S1NZH/Course-project-9.101/МКЭ/В отчет/Снимок экрана 2026-06-16 001204.png

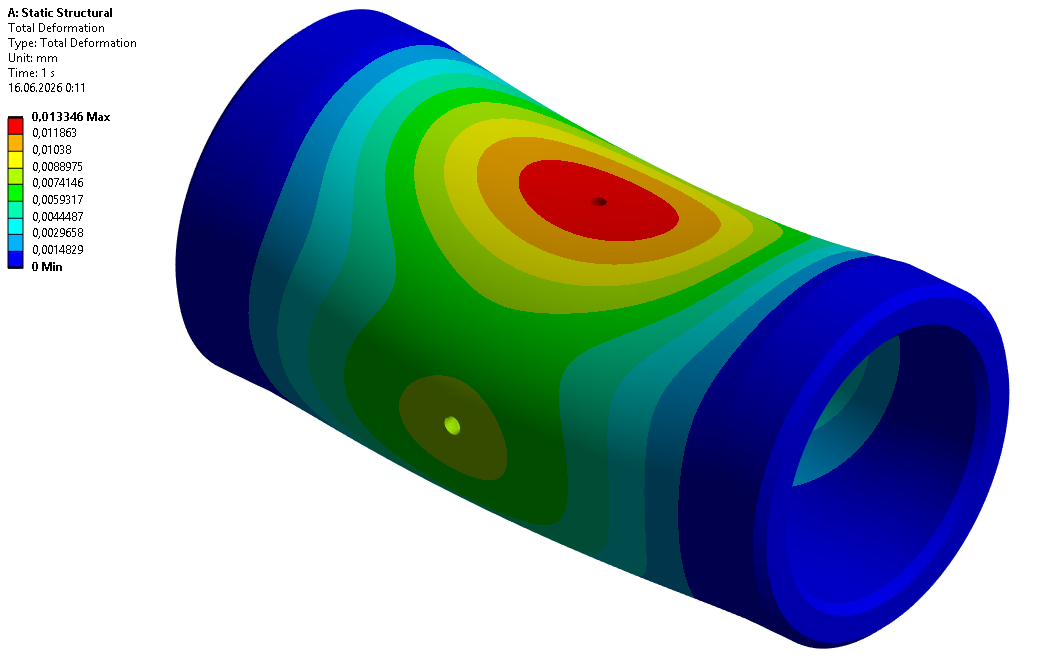
МКЭ/В отчет/Снимок экрана 2026-06-16 001204.png
