S1NZH/Course-project-9.101/Образцы/Ваня.jpg

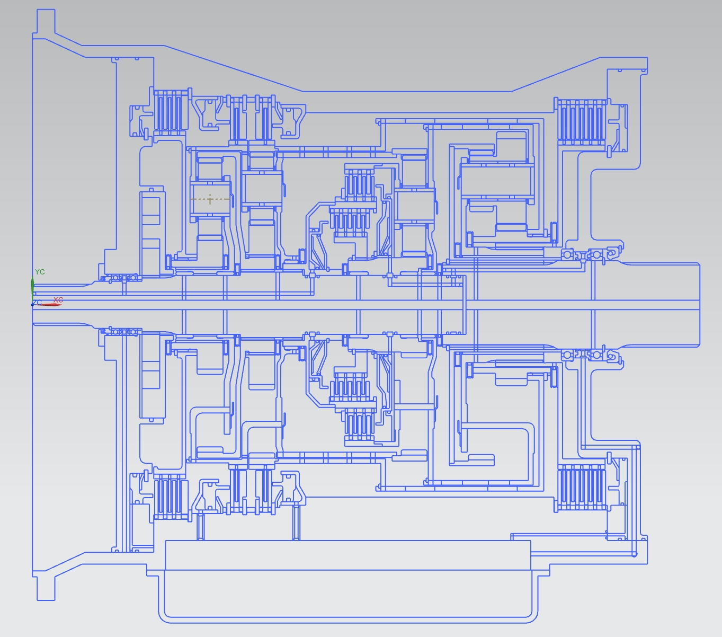
Образцы/Ваня.jpg
