S1NZH/Course-project-9.101/РПЗ ПКП Жиленко Н.Д, СМ9-101.docx

| Министерство науки и высшего образования Российской Федерации Федеральное государственное автономное образовательное учреждение высшего образования «Московский государственный технический университет имени Н.Э. Баумана (национальный исследовательский университет)» (МГТУ им. Н.Э. Баумана)

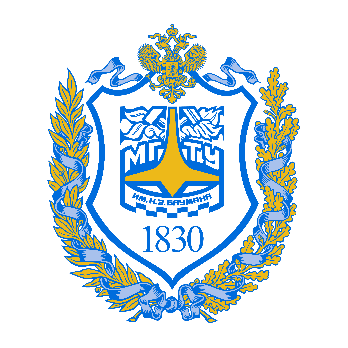
[picture p3: figure]

ФАКУЛЬТЕТ «Специальное машиностроение»

КАФЕДРА СМ9 «Многоцелевые гусеничные машины и мобильные роботы»

РАСЧЕТНО-ПОЯСНИТЕЛЬНАЯ ЗАПИСКА

К КУРСОВОМУ ПРОЕКТУ

НА ТЕМУ:

Проектирование планетарной

коробки передач

Студент: | | СМ9- 101 | | | | | | | | Н.Д. Жиленко
| | (Группа) | | | | (Подпись, дата) | | | | (И.О. Фамилия)
Руководитель курсового проекта: | | | | | | | | | | С.А. Харитонов
| | | | | | (Подпись, дата) | | | | (И.О. Фамилия)
Консультант: | | | | | | | | | | Т.Д. Поздняков
| | | | | | (Подпись, дата) | | | | (И.О. Фамилия)
Норм. контролер | | | | | | | | | | К.Е.Бяков
| | | | | | (Подпись, дата) | | | | (И.О. Фамилия)
Ответственный за курсовое проектирование | | | | | | | | | В.Б. Холоденко
| (Баллы за семестр) | | | | (Подпись, дата) | | | | (И.О. Фамилия)

Министерство науки и высшего образования Российской Федерации

Федеральное государственное бюджетное образовательное учреждение

высшего образования

«Московский государственный технический университет имени Н.Э. Баумана

(национальный исследовательский университет)»

(МГТУ им. Н.Э. Баумана)

Утверждаю
Заведующий кафедрой | | | СМ9
| | | (индекс)
| | В. А. Горелов
(подпись) | | (И.О. Фамилия)
| | (дата)

ЗАДАНИЕ

на выполнение курсового проекта

по дисциплине | | Методы расчета и проектирования
Студент группы | | СМ9-101 Жиленко Никита Дмитриевич
| | (Фамилия, имя, отчество)
Тема курсового проекта | | | Проектирование планетарной коробки передач

Направленность КП (учебная, исследовательская, практическая, производственная, др.)
Источник тематики (кафедра, предприятие, НИР)
Задание | Спроектировать по заданной кинематической схеме планетарную коробку передач

Раб. точки | 54 | 24 | 48 | 34 | 47 | 37 | 78 | 27 | 58 | 35
i0x | 7,75 | 3,10 | 1,84 | 1,46 | 1,22 | 1,10 | 1,00 | 0,87 | -5,55 | -3,40

Оформление курсовой работы:

Расчетно-пояснительная записка на _____ листах формата А4.

Перечень графического (иллюстративного) материала (чертежи, плакаты, слайды и т.п.)

Общий вид, продольный разрез коробки передач, поперечные разрезы по планетарным

рядам и насосу, рабочие чертежи, 3D-модель одного планетарного ряда

Дата выдачи задания «__» ______________ 2026 г.

Руководитель курсового проекта | | | | С.А. Харитонов
| | (подпись, дата) | | (И.О. Фамилия)
Студент | | | | Н.Д. Жиленко
| | (подпись, дата) | | (И.О. Фамилия)
Ответственный за курсовое проектирование | | | | В.Б. Холоденко
| | (подпись, дата) | | (И.О. Фамилия)

# Исходные данные

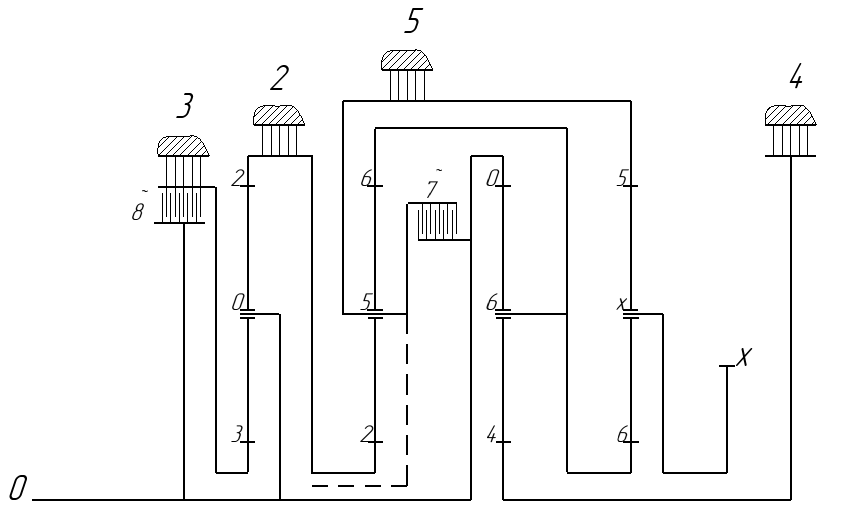
[picture p4: figure]

Исходные данные для расчетов элементов планетарной коробки передач на прочность

Mдвmax, Н∙м | nдв, об/мин | | Пробег, км | Коэффициент использования ДВС | Средняя скорость в течение всего срока эксплуатации, км/ч
| max | min
750 | 3000 | 900 | 250 000 | 0,45 | 25,0

Министерство науки и высшего образования Российской Федерации

Федеральное государственное бюджетное образовательное учреждение

высшего образования

«Московский государственный технический университет имени Н.Э. Баумана

(национальный исследовательский университет)»

(МГТУ им. Н.Э. Баумана)

КАЛЕНДАРНЫЙ ПЛАН

на выполнение курсового проекта

по дисциплине | Методы расчета и проектирования
Студент группы | СМ9-101 Жиленко Никита Дмитриевич
| (Фамилия, имя, отчество)
Тема курсового проекта | | Проектирование планетарной коробки передач

№ п/п | Наименование этапов выпускной квалификационной работы | Сроки выполнения этапов | | Отметка о выполнении
| | план | факт | Руководитель КП | Куратор
| Задание на выполнение курсового проекта
| 1 модуль | ____________ Планируемая дата
| 2 модуль | ____________ Планируемая дата
| Оформление РПЗ | ____________ Планируемая дата
| Подготовка доклада и презентации (при необходимости) | ____________ Планируемая дата
| Защита курсового проекта | ____________ Планируемая дата

Студент | | | Руководитель проекта
| (подпись, дата) | | | (подпись, дата)

СОДЕРЖАНИЕ

# СПИСОК СОКРАЩЕНИЙ И ОБОЗНАЧЕНИЙ

БЦК – большое центральное колесо

КПД – коэффициент полезного действия

КЭ – конечный элемент

КЭМ – конечно-элементная модель

МКЭ – метод конечных элементов

МЦК – малое центральное колесо

ПК – программный комплекс

ПКП – планетарная коробка передач

САТ – сателлит

a – межосевое расстояние

a_(дв) – коэффициент использования двигателя

a_1 – коэффициент, корректирующий ресурс в зависимости от надежности

a_23 – коэффициент, учитывающий условия применения подшипника

b – ширина зубчатого зацепления

b_ф – ширина контакта фрикционных дисков

C_(r i) – радиальная динамическая грузоподъемность подшипника i-го планетарного ряда

D_(о i) – внешний диаметр оси сателлита i-го ряда

D_(min) – минимальный внешний диаметр сечения вала

D_(we) – диаметр ролика

d – делительный диаметр

d_о – диаметр отверстия в валу

d_(о i) – внутренний диаметр оси сателлита i-го ряда

d_(отв i) – диаметр отверстия в сателлите

d_a – диаметр вершин зубьев

d_f – диаметр впадин зубьев

F – суммарная площадь боковых поверхностей зубьев с одной стороны

F_(оси i,j) – суммарная нагрузка на опору i-го сателлита на j-ой передаче

F_(оси ср. i) – средняя нагрузка на ось i-го планетарного ряда

F_(ЦБ i,j) – центробежная сила, действующая на ось i-го планетарного ряда на j-ой передаче

F_(t i,j) – окружная сила, действующая на ось i-го планетарного ряда на j-ой передаче

f_c – коэффициент, зависящий от отношения диаметра ролика к длине ролика

h_щ – минимальная толщина щеки

i_р – число рядов тел качения

K_б – коэффициент безопасности, учитывающий условия работы подшипника

K_(вод i,j) – коэффициент нагрузки водила i-го ряда на j-ой передаче

K_т – коэффициент, учитывающий рабочую температуру подшипника

K_(нер i) – коэффициент неравномерности распределения нагрузки для зацеплений iго ряда

k – коэффициент нагрузки на рассматриваемом участке

k_(ω вод i,j) – коэффициент угловой скорости водила i-го ряда на j-ой передаче

k_(ω сат i,j) – коэффициент угловой скорости сателлита i-го ряда на j-ой передаче

L_(sa i) – ресурс радиального игольчатого подшипника i-го планетарного ряда

L_(we) – длина ролика

l_(min) – минимальная длина шлицевого соединения

M_(дв max) – максимальный момент двигателя

M_н – момент, передаваемый фрикционным элементом

M_ф – расчетный момент фрикционного элемента

m – модуль зубчатых колес

m_ш – модуль шлицевого зацепления

m_i – приблизительная масса сателлита i-го ряда

N_(подш i,j) – требуемое количество оборотов подшипника i-го планетарного ряда на j-ой передаче до отказа

n_(ср) – средние обороты двигателя в процессе эксплуатации

n_(min) – минимальная частота вращения двигателя

n_(max) – максимальная частота вращения двигателя

P – сила, действующая на пакет фрикционов

P_(r i) – эквивалентная радиальная динамическая нагрузка подшипника i-го планетарного ряда

p_(упр) – давление в системе управления

q – удельное давление на поверхностях трения

R_(вод i) – радиус водила i-го ряда

R_(ПКП) – ресурс планетарной коробки передач

R_в – внутренний радиус контакта фрикционных дисков

R_н – наружный радиус контакта фрикционных дисков

R_(пв) – внутренний радиус поршня

R_(пн) – наружный радиус поршня

r_(ср) – средний радиус шлицевого соединения

V – коэффициент, учитывающий вращение внутреннего или внешнего кольца подшипника

v_(ср) – средняя скорость машины

Z – число роликов в подшипнике

z – пар трения фрикционного элемента

z_(МЦК) – число зубьев малого центрального колеса

z_(Сат) – число зубьев сателлита

z_(БЦК) – число зубьев большого центрального колеса

z_ш – количество шлицев

β – угол наклона зубчатых колес

β_з – коэффициент запаса фрикциона, при трении в масле

λ – коэффициент, учитывающий уменьшение площади поверхности трения дисков с накладками из-за наличия канавок

μ – коэффициент трения фрикционной пары

ρ_(ст) – плотность материала сателлита

[σ]_(см) – допустимые напряжения смятия

τ_(ср i) – напряжения среза осей i-го планетарного ряда

[τ]_(кр) – допускаемые касательные напряжения при кручении

φ – коэффициент неравномерности распределения нагрузки по рабочим поверхностям зубьев

# ВВЕДЕНИЕ

Курсовой проект посвящен проектированию планетарной коробки передач (ПКП). Планетарными называют передачи, в которых одно или несколько зубчатых колес кроме относительного вращения вокруг своих осей имеют еще и переносное вращение вместе с осями.

По сравнению с обычными передачами, в которых оси всех зубчатых колес неподвижны, планетарные передачи, благодаря применению нескольких промежуточных звеньев – сателлитов, обеспечивают большую напряженность зубьев, разгружают центральные валы и подшипниковые опоры от радиальных усилий, при правильном выборе кинематической схемы обладают более высоким коэффициентом полезного действия (далее КПД) при меньших размерах и больших передаточных отношениях.

Применение ПКП озволяет сократить время, затрачиваемое на переключение передач, существенно упрощает задачу автоматизации процесса управления, избавляет от необходимости устанавливать между двигателем и трансмиссией сцепление или главный фрикцион, так как его функции выполняют тормоза и блокировочные муфты, предназначенные для включения передач в коробке.

ПКП должна также обладать высокой надёжностью (в пределах заданного ресурса работы) и малыми габаритами.

# 1 Техническое задание

Разработать планетарную коробку передач с тремя степенями свободы, имеющую десять передач, из которых две – заднего хода, по исходным данным, представленным в таблицах 1 и 2.

Таблица 1 – Исходные данные

Наименование параметра | Значение
Максимальный крутящий момент двигателя М_(ДВСmax) , Н⋅м | 750
Максимальная частота вращения вала двигателя n_(ДВСmax) , об/мин | 3000
Минимальная частота вращения вала двигателя n_(ДВС min) , об/мин | 900
Ресурс коробки передач R_(КП) , км | 250000
Коэффициент использования двигателя a | 0,45
Средняя скорость машины в течение срока эксплуатации v_(ср) , км/ч | 25

Таблица 2 – Таблица включения передач

Номер передачи | КПД | i_(0x) | Элементы управления
| | | Т2 | Т3 | Т4 | Т5 | М7 | М8
ЗХ II | 0,940 | -3,459 | | X | | X
ЗХ I | 0,951 | -5,568 | | | | X | | X
1 | 0,962 | 7,830 | | | X | X
2 | 0,973 | 3,841 | X | | X
3 | 0,981 | 1,954 | | | X
4 | 0,972 | 1,542 | | X | X
5 | 0,991 | 1,277 | | | X | | X
6 | 0,991 | 1,123 | | X | | | X
7 | 1,000 | 1,000 | | | | | X | X
8 | 0,992 | 0,848 | X | | | | X

Кинематическая схема коробки передач представлена на рисунке 1

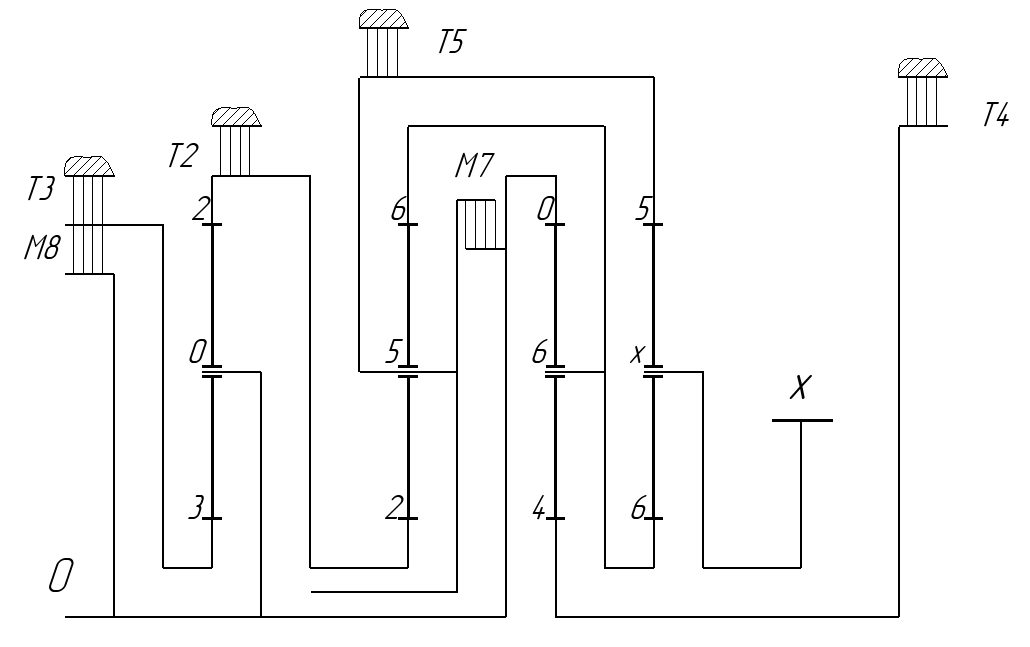
[picture p5: figure]

0 – входное звено; X – выходное звено коробки передач; 2, 3, 4, 5, 6 – звенья коробки передач; 7, 8 – блокировочные муфты

Рисунок 1 – Кинематическая схема ПКП

В ПКП имеются шесть элементов управления – четыре тормоза: Т2, Т3, Т4 и Т5 и две блокировочные муфты: муфта М7 соединяет звенья 0 и 5, муфта М8 – звенья 0 и 3. В ПКП входят 4 планетарных ряда (ПР) второго класса: первый ряд 302 с внутренним передаточным отношением -1,64, второй – 256 с внутренним передаточным отношением -1,93, третий – 460 с внутренним передаточным отношением -1,694, четвёртый – 6x5 с внутренним передаточным отношением -1,909.

# 2 Расчет элементов коробки передач

## Расчет минимального диаметра валов

Следует отметить, что одним из основных преимуществ планетарных коробок передач является разгруженность их центральных валов от радиальных сил, что определяется симметричным расположением сателлитов. Поэтому все центральные валы и их подшипниковые опоры разгружены от действия радиальных сил. Это значительно упрощает расчеты всех центральных валов, которые следует проводить только на действие крутящего момента.

Еще одна особенность работы планетарных коробок передач заключается в том, что на разных передачах на один и тот же участок вала могут действовать различные, как по направлению, так и по величине, крутящие моменты. Причем на каждом участке момент может изменяться от максимального по абсолютной величине до нулевого значения. Это приводит к необходимости использовать при выборе допускаемых напряжений на кручения значения, соответствующие переменной нагрузке, действующей от нуля до максимума и от максимума до нуля (пульсирующая нагрузка).

Для определения минимально допустимого числа зубьев МЦК планетарных рядов необходимо знать модуль зубчатых колес. При проектировании планетарных коробок передач в виду особенности назначения чисел зубьев зубчатых колес их модуль не рассчитывается, а назначается. Назначение величины модуля происходит, как правило, в зависимости от максимальной величины крутящего момента на ведущем валу и на основании опыта проектирования предыдущих планетарных коробок передач. Рекомендуемые значения модуля в зависимости от максимального момента на ведущем валу представлены в таблице 3.

Таблица 3 – Рекомендуемые значения модуля зубчатых колес планетарных рядов
Момент на ведущем валу, Н∙м | 100-300 | 300-700 | 700-2000 | 2000-4000
Модуль, мм | 1,25-1,5 | 1,5-1,75 | 2,0-2,5 | 3,0-4,0

Таким образом, для дальнейших расчетов примем величину модуля зубчатых колес всех планетарных рядов равным 2 мм.

Еще одним назначаемым параметром является угол наклона зубьев β . Наличие угла наклона зубьев увеличивает несущую способность цилиндрических передач. Кроме того, косозубые передачи отличаются от прямозубых меньшей виброактивностью и пониженным уровнем шума, которые тем меньше, чем больше угол наклона зубьев.

Но слишком большие значения β приводят к увеличению осевой составляющей силы в зацеплении. Поэтому для значений максимального момента, развиваемого двигателем, до 1500 Н∙м рекомендуется принимать угол наклона зубьев в пределах от 8º до 25º. Для моментов превышающих эту величину β должен быть принят равным нулю. В нашем случае назначим угол 15º.

Для проведения расчета минимальных диаметров валов необходимо, прежде всего, определить моменты, нагружающие тот или иной участок каждого вала. Для этого необходимо знать, какие пары элементов управления, включаются на каждой передаче, и значения относительный моментов, нагружающих звенья и элементы управления проектируемой коробки передач.

Какие пары элементов управления задействованы на каждой передаче задано в техническом задании или это также можно определить по плану угловых скоростей.

Схема участков валов для расчета их диаметров представлена на рисунке 2.

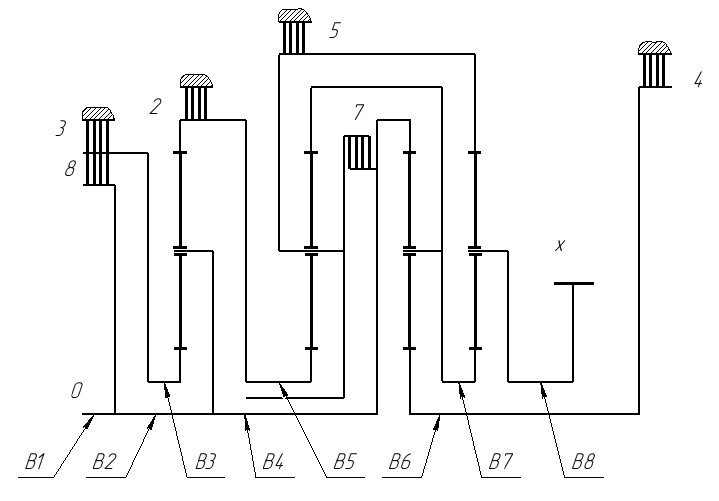
[picture p6: figure]

Рисунок 2 – Схема участков валов

Не сложный анализ структуры кинематической схемы показывает, что необходимо произвести расчет восьми участков валов (рисунок 8):

- В1 – ведущий вал ПКП (нагружен только моментом двигателя);
- В2 – момент с двигателя + на муфте 8;
- В3 – момент на МЦК первого ряда;
- В4 – момент с двигателя + на муфте 8 + водило первого ряда;
- В5 – момент на МЦК второго ряда;
- В6 – момент на МЦК третьего ряда;
- В7 – момент на МЦК четвертого ряда;
- В8 – момент 1-ой передаче или передаче заднего хода;

Для расчет минимальных диаметров валов можно воспользоваться программой WALY, расположенной в одноименной папке.

Работа с программой WALY весьма проста. Программа рассчитывает минимальное значение внешнего диаметра вала. Для этого следует задать следующие величины:

- допускаемые напряжения на кручение;
- максимальный момент, развиваемый двигателем;
- относительный момент, действующий на данный участок вала
- внутренний диаметр вала.

Величина относительного момента, действующего на том или ином участке вала, определяется по результату расчета кинематических и силовых характеристик кинематической схемы, проведенного по программе PKP4, (Приложение А).

Величину внутреннего диаметра вала возможно определить только, приступив к выполнению эскизной компоновки планетарной коробки передач.

При выборе марки стали для валов следует руководствоваться следующим: сталь должна быть относительно не дорогой, но при этом иметь достаточно приемлемое значение допускаемых напряжений на кручение.

Руководствуясь приведенными выше соображениями, выберем для изготовления валов нашей коробки передач сталь 35ХМ ГОСТ 4543-71. Данная марка стали при закалке и отпуске в масле имеет вполне приемлемые допускаемые напряжения на кручение 310 МПа. Также в процессе проектирования рассчитывались эвольвентные шлицы, служащие для сборки узлов ПКП. Расчёт производился в программе «Расчёт эвольвентных шлицов».

Начнем расчет минимальных внешних диаметров участков валов с ведущего вала. Результаты всех расчетов будем сводить в таблицу 4.

1) Участок В1.

Относительный момент, действующий на участке В1, равен 1.

Смазка планетарной коробки передач осуществляется принудительно посредством подачи масла через осевые и радиальные отверстия центрального вала к подшипниковым узлам, фрикционным дисковым элементам управления и зубчатым зацеплениям. В ведущем валу предусмотрено осевое отверстие диаметром 8 мм.

Расчеты по программе WALY с учетом принятых исходных данных показали, что внешний диаметр участка вала должен быть не менее 23 мм.

Поскольку участок В1 является частью ведущего вала, на его конце необходимо предусмотреть шлицы для соединения с двигателем или другими агрегатами трансмиссии.

На основании расчетов внешний диаметр участка В1 определяет диаметр впадин шлицев. Учитывая, что высота шлицев приблизительно равна модулю, внешний диаметр шлицованного конца участка В1 определяется как рассчитанный диаметр плюс два модуля эвольвентных шлицев.

При известных параметрах шлицев минимальный внешний диаметр шлицев составляет 21,15 мм. Заносим этот результат в таблицу 4. Таким образом, внешний диаметр шлицевого участка ведущего вала принимается равным 30 мм.

Таблица 4 – Результаты расчета минимальных диаметров валов

Участок | [τ] , МПа | M_(дв. max) , Н⋅м | Элемент ПКП,определяющий нагрузку | Коэф-т нагрузки участка | Внутренний диаметр, мм | Минимальный диаметр, мм | Принятый внешний диаметр, мм
В1 | 310 | 350 | ДВС | 1,00 | 8 | 23 | 30
В2 | | | ДВС + муфта 8 | 1,38 | 8 | 26 | 45
В3 | | | МЦК 1-го ПР | 0,38 | 54 | 55 | 76
В4 | | | ДВС + муфта 8 + водила 1-го ПР | 1,32 | 8 | 26 | 45
В5 | | | МЦК 2-го ПР | 1,00 | 61 | 62 | 69
В6 | | | МЦК 3-го ПР | 0,56 | 51 | 52 | 70

Продолжение таблицы 4

В7 | | | МЦК 4-го ПР | 2,70 | 74 | 76 | 82
В8 | | | I-ая передача | 7,83 | 74 | 78 | 85

Для установки уплотнений и подшипников предусматривается шейка диаметром 30 мм.

Далее устанавливаются шлицы для привода насоса диаметром 35 мм. Эти же шлицы используются для передачи крутящего момента на другие участки коробки передач.

1) Участок В2.

Относительный момент, действующий на участке В2, равен 1,38. На участке В2 находятся шлицы диаметром 35 мм и звено тормозной муфты 8.

2) Участок В3.

Относительный момент, действующий на участке В3, равен 0,37.

Внутренний диаметр участка составляет 36 мм. Внешний диаметр, равный 76 мм, принимаем для расположения шлицев.

На участке В3 располагается МЦК I-го ПР

Определим для него минимальные делительный диаметр и количество зубьев по формулам (1) и (2) соответственно:

d_(minПР1) =d_(fПР1) +2,5⋅m=76+2,5⋅2=81 мм | (1)
где d_f – диаметр впадин зубьев, мм; m – модуль зацепления, мм; z_(minПР1) =(d_(minПР1) ⋅cos(β))/m=(81⋅cos(15))/2≈40. | (2)

3) Участок В4.

Относительный момент, действующий на участке В4, равен 1,32.

Внутренний диаметр участка – 8 мм, для подвода масла. Согласно расчетам в программе WALY минимальное значение внешнего диаметра вала составило 26 мм. Принятый внешний диаметр на данном участке – 45 мм.

4) Участок В5.

Относительный момент, действующий на участке В5, равен моменту в тормозе звена 5, и равен 1.

Внутренний диаметр вала на этой участке – 61 мм. После расчетов в программе WALY значение минимального диаметра данного участка должно быть не менее 62 мм. Внешний диаметр принимается 69 мм. На участке В5 расположено МЦК II-го ПР. Определим для него минимальные делительный диаметр и количество зубьев по формулам (1) и (2) соответственно:

d_(minПР2) =d_(fПР1) +2,5⋅m=69+2,5⋅2=74 мм
z_(minПР2) =(d_(minПР2) ⋅cos(β))/m=(74⋅cos(15))/2≈36.

5) Участок В6.

Относительный момент, действующий на участке В6, равен 0,56.

Внутренний диаметр равен диаметру вершин внутренних эвольвентных шлицев (51мм). Тогда после расчета программы получаем внешний диаметр вала 52 мм. Из конструктивных соображений примем диаметр равным 70 мм.

На участке В6 расположено МЦК III-го ПР.

d_(minПР3) =d_(fПР1) +2,5⋅m=70+2,5⋅2=75 мм;

z_(minПР3) =(d_(minПР3) ⋅cos(β))/m=(75⋅cos(15))/2≈20.

6) Участок В7.

Относительный момент, действующий на участке В7, равен 2,7. На участке В7 расположено МЦК IV-го ПР. Внутренний диаметр вала – 74 мм. После расчета в программе получили значение внешнего диаметра вала равное 76 мм. Из конструктивных соображений примем значение равным 82 мм.

Таким образом,

d_(minПР4) =d_(fПР4) +2,5⋅m=82+2,5⋅2=87 мм ;

z_(minПР4) =(d_(minПР4) ⋅cos(β))/m=(82⋅cos(15))/2≈40.

7) Участок В8.

Относительный момент, действующий на участке В8, равен 7,83.

Внутренний диаметр участка вала 74 мм. Тогда после расчета программы получаем внешний диаметр вала 78 мм. Из конструктивных соображений примем диаметр равным 85 мм.

## Подбор чисел зубьев зубчатых колес планетарных рядов

В результате проведенных выше конструктивных проработок и расчетов были определены минимально допустимые числа зубьев МЦК для всех четырех планетарных рядов. Это обстоятельство дает возможность приступить к следующему этапу разработки эскизного проекта планетарной коробки передач – подбору чисел зубьев всех зубчатых колес, входящих в состав планетарных рядов.

Как известно, при подборе чисел зубьев шестерен планетарных рядов руководствуются шестью принципами:

1) Не желательны варианты, в которых числа зубьев сцепляющихся колес имели хотя бы один общий множитель;
2) Не желательны варианты, в которых числа зубьев сцепляющихся колес имели хотя бы один общий множитель;
3) Соблюдение условия соосности;
4) Соблюдение условия сборки;
5) Обеспечение условия соседства сателлитов;
8) Обеспечение условия не подрезания зубьев зубчатых колес.

В общем случае это достаточно трудоемкая процедура, поэтому удобнее воспользоваться разработанной для этой цели программой ZUB, расположенной в одноименной папке. Следует отметить, что данная программа осуществляет подбор чисел зубьев зубчатых колес только для планетарных рядов второго класса с одновенцовыми сателлитами.

В результате расчета программа предложит достаточно большое количество вариантов сочетания чисел зубьев шестерен планетарного ряда в зависимости от количества сателлитов, входящих в состав данного планетарного ряда. При этом следует выбирать такие варианты, в которых число зубьев МЦК было не меньше минимально допустимого значения, определенного выше. Кроме того, с точки зрения стоимости производства коробки передач, число сателлитов желательно принимать минимальным, но не менее трех.

Следует отметить, что это еще не окончательный выбор чисел зубьев шестерен планетарных рядов. Может оказаться так, что в результате прочностных расчетов или по конструктивным соображениям возникнет необходимость изменить количество зубьев шестерен в сторону их увеличения.

Так с помощью программы ZUB были получены варианты сочетания чисел зубьев зубчатых колес для каждого планетарного ряда. Результат расчета представлен в приложении Б.

При выборе сочетания числа зубьев зубчатых колес планетарных рядов следует учитывать еще один момент. Желательно, чтобы радиальные размеры всех планетарных рядов имели бы одинаковый размер. Это означает, что при одном и том же значении модуля зубчатых колес желательно, чтобы числа зубьев БЦК всех планетарных рядов имели бы близкие значения.

Сочетания чисел зубьев, принятых для дальнейших расчетов с учетом, высказанных выше замечаний представлены в таблице 5.

Следует отметить, что подобранные сочетания чисел зубьев шестерен планетарных рядов не являются окончательными, их, возможно, в результате расчетов на прочность необходимо будет использовать другие сочетания зубьев.

Таблица 5 – Подбор чисел зубьев шестерен планетарных рядов
Планетарный ряд | | Конструктивный параметр, k | Число сателлитов | Число зубьев МЦК, ZМЦК | | Число зубьев сателлитов, ZСАТ | Число зубьев БЦК, ZБЦК
| | | | min | принятое
1 | 302 | 1,640 | 3 | 30 | 50 | 16 | 82
2 | 256 | 1,930 | 3 | 33 | 43 | 20 | 83
3 | 460 | 1,694 | 3 | 20 | 49 | 17 | 83
4 | 6x5 | 1,909 | 4 | 26 | 44 | 20 | 84

## Определение параметров зубчатых колес и планетарных рядов

Исходные параметры для расчета зубчатых колес и планетарных рядов приведены в таблице 5. Все зубчатые колеса косозубые, марка стали – 20ХНМ. Химико-термическая обработка выбранной стали – цементация. Числа зубьев и количество сателлитов подбираются для каждого планетарного ряда по приложению Б.

Расчет геометрии зубчатых колес был проведен с помощью программы RASCHETPR, разработанной на кафедре СМ-9 МГТУ им. Н. Э. Баумана. Распечатки результатов расчета представлены в приложениях В-Е. Основные параметры приведены в таблице 6.

Таблица 6 – Исходные параметры зубчатых колес и планетарных рядов

Наименование параметра | | Номер планетарного ряда
| | 1 | | 2 | | 3 | | 4
Модуль зубчатых колес m, мм | | 2
Угол наклона зубьев , град. | | 20
Твердость поверхности зубьев, ед. HRC | | 60
Количество сателлитов ПР | 3 | | 3 | | 3 | | 4

Продолжение таблицы 6

Ширина зубчатого венца, мм | | 15 | 20 | 15 | 30
Число зубьев малого центрального колеса (МЦК) zМЦК | | 50 | 43 | 49 | 44
Число зубьев сателлитов (САТ) zСат | | 16 | 20 | 17 | 20
Число зубьев большого центрального колеса (БЦК) zБЦК | | 82 | 83 | 83 | 84
Коэффициент смещения МЦК | | 0
Коэффициент смещения САТ | | 0
Коэффициент смещения БЦК | | 0
Делительный диаметр | МЦК | 103,528 | 89,0338 | 101,457 | 91,1043
| БЦК | 169,785 | 171,856 | 171,856 | 173,926
Окружная скорость в зацеплении, м/с | | 16,26 | 22,52 | 10,04 | 7,85
Степень точности | | 6 | 6 | 7 | 7

## Расчет осей сателлитов

Радиальная нагрузка, воспринимаемая осями сателлитов, определяется моментом от зацеплений МЦК и БЦК, а также центробежной силой, действующей на сателлит. При этом необходимо провести расчет результирующей радиальной силы на каждой из передач для определения максимальной, продолжить расчет при данной силе и затем определить напряжения изгиба, среза и смятия. Далее приведен расчет первой задней передачи первого планетарного ряда. Расчет второго, третьего и четвёртого рядов аналогичен первому. Материал осей – закаленная сталь 45Х.

Радиальная нагрузка на оси сателлитов определяется по формуле (3):

F_(вод) =(K_M ⋅M_(ДВСmax) ⋅K_(нер))/(a_(ст) ⋅R_(сат)), | (3)

где K_M – коэффициент передаваемого момента, равный отношению момента на водиле к максимальному моменту от двигателя, берется из приложения А;

a_(ст) – количество сателлитов, равно трём;

K_(нер) – коэффициент неравномерности в зависимости от степени точности;

R_(сат) – радиус, на котором расположены оси сателлитов относительно оси МЦК, для первого планетарного ряда равен 68,33 мм.

Тогда:

F_(вод) =(1,61∙750∙1)/(3∙0,06833)=5890,53 Н.

Центробежная сила, действующая на сателлит, определяется по формуле (4):

P_ц =m_(сат) ∙ω_(вод) ^2 ∙R_(сат,) | (4)

где – масса сателлита, кг, определяется по формуле (5):

m_(сат) =ρV, | (5)

ρ – плотность легированной стали, кг/м³, равна 7874;

V – объем сателлита, м³ определяется по формуле (6):

V=(πb_(сат) (D_(сат) ^2 -d_(сат)^2 ))/4 | (6)

где b_(сат) – ширина сателлита, мм, равна 15;

D_(сат) – делительный диаметр сателлита, мм, равен 33,13;

d_(сат)^() – внешний диаметр оси сателлита, мм, равен 15;

– угловая скорость водила, об/мин определяется по формуле (7):

ω_(вод) =К_ω ⋅(2⋅n⋅_(ДВСmax))/60, | (7)

где – коэффициент угловой скорости, равный отношению угловой скорости водила на рассчитываемой передаче к максимальной угловой скорости двигателя, берется из приложения А, для первой передачи заднего хода первого ряда равен 1.

Тогда, центробежная сила, выражается формулой (8):

P_ц =(ρ⋅π⋅b_(сат) ⋅R_(сат) ⋅(D_(сат) ^2 -d_(сат) ^2 )((K_ω ⋅2⋅n_(⋅ДВСmax) π)/60)^2)/(4∙10^9), | (8)

P_ц =(7874∙π∙15∙68,33∙(33,13^2 -15^2 )∙((1∙2∙3000π)/60)^2)/(4∙10^12)=545,82 Н.

Расчетная схема представлена на рисунке 3.

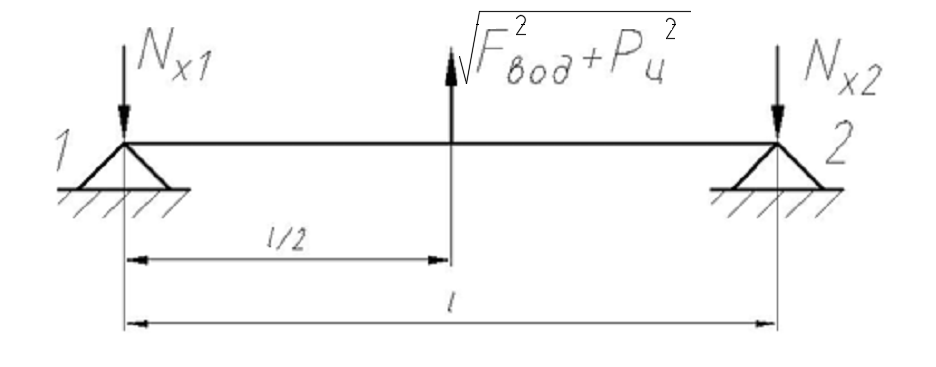
[picture p7: figure]
схема сателит

Рисунок 3 – Расчетная схема оси сателлита

Уравнение моментов относительно опоры 1 определяется выражением (9):

N_(x2) l-l/2√((F_(вод) ^2 +P_ц ^2 ))=0, | (9)

где l – расстояние между опорами, мм. Значение составляет 25.

Тогда, реакцию во второй опоре можно определить из выражения (10):

N_(x2) =1/2√((F_(вод) ^2 +P_ц ^2 )); N_(x2) =1/2∙√((5890 ^2 +545,82^2 ))=2958 Н. | (10)

Так как опоры расположены симметрично, то нагрузки в них одинаковы

N_(x2) =N_(x1) =N_x =2958 Н.

Наибольший изгибающий момент действует в середине оси и вычисляется по формуле (11).

M_и =N_x ∙l/(2∙10^3). | (11)

Таким образом, изгибающий момент равен:

M_и =2958∙25/(2∙10^3)=36,97 Н∙м.

Момент сопротивления оси сателлита вычисляется по формуле (12):

W=0,2∙d_(сат)^3 ∙(1-(d_(0сат)^4)/(d_(сат)^4)), | (12)

где d_(0сат) – внутренний диаметр оси сателлита, мм , равен 10.

Тогда

W=0,2∙15^3 ∙(1-(10^4)/(15^4))=541,67 мм^3 .

Напряжения, возникающие в поперечном сечении оси сателлита, вычисляются по формуле (13):

σ=(10^3 ∙M_и)/W. | (13)

Следовательно:

σ=(10^3 ∙36,97)/(541,67)=68,26 МПа.

Запас прочности в расчетном сечении определяется по формуле (14)

s=([σ])/σ. | (14)

Таким образом:

s=900/(68,26)=13,18.

Запас прочности превышает достаточный.

Далее необходимо провести расчет оси на срез. Напряжения среза, действующие в сечении, определяются по формуле (15)

τ_(ср) =(4∙N_x)/(π∙(d_(сат)^2 -d_(0сат)^2 )). | (15)

Следовательно, напряжения среза:

τ_(ср) =(4∙2958)/(π∙(15^2 -10^2 ))=30,13 МПа.

Запас прочности в расчетном сечении определяется по формуле (16):

s_(ср) =([τ])/τ. | (16)

Таким образом:

s_(ср) =135/(30,13)=4,48.

Запас прочности достаточный.

Далее необходимо провести расчет на смятие щек. Действующие напряжения смятия определяются по формуле (17):

σ_(см) =(N_x)/(δ∙d_(сат)), | (17)

где δ – толщина щеки водила, мм , равна 4.

Тогда:

σ_(см) =2958/(4∙15)=49,3 МПа.

Запас прочности на смятие определяется по формуле (18):

s_(см) =(σ_т)/σ, | (18)

Таким образом:

s_(см) =194/(49,3)=3.94.

Запас прочности достаточный.

Для остальных ПР и расчетных случаев по зависимостям, указанным выше, были проведены расчеты в Matlab, скрипт представлен в приложении Г. Результаты расчета приведены в таблице 7.

Таблица 7 – Результаты расчета осей сателлитов

Наименование параметра | Значения
Номер планетарного ряда | 1 | 2 | 3 | 4
Внешний диаметр оси сателлита d_(сат) , мм | 15 | 20 | 15 | 20
Внутренний диаметр оси сателлита d_(0сат) , мм | 10 | 15 | 10 | 15
Толщина щеки водила δ , мм | 3 | 3 | 3 | 4
Запас прочности оси при изгибе s | 13,18 | 11,68 | 7,81 | 4,42

Продолжение таблицы Таблица 7

Запас прочности оси на срез s_(ср) | 4,48 | 3,30 | 2,65 | 1,67
Запас прочности оси на смятие s_(см) | 3,94 | 2,76 | 2,33 | 1,39

## Расчет подшипников сателлитов

Радиальные усилия в сателлитах планетарных механизмов воспринимаются роликовыми игольчатыми подшипниками. В проектируемой ПКП используются роликовые игольчатые подшипники.

Расчет осуществляется по программе RASCHETPOD, которая расположена в папке с точно таким же названием.

Программа предназначена для расчета двух вариантов использования подшипников:

- в качестве опоры сателлитов;
- в качестве опоры вала.

Для определения варианта использования рассчитываемого подшипника необходимо в скрипте программы RASCHETPOD задать соответствующее значение параметра NPRIZNAK. Для расчета подшипников сателлитов этот параметр должен равняться 1, для подшипников, являющими опорой вала 2.

Для ввода исходных данных необходимо создать соответствующий файл в формате EXEL (приложение Д). Причем файлы для расчета подшипников сателлитов и опор валов отличаются друг от друга как по количеству вводимых параметров, так и по самим параметрам.

Покажем составление файла исходных данных для варианта использования подшипников в качества опоры сателлитов.

В первой строчке файла исходных данных указывается тип используемого подшипника:

1) шариковый радиальный или радиально упорный;
9) шариковый упорный или упорно-радиальный;
10) роликовый (игольчатый) радиальный или радиально упорный;
11) роликовый упорный или упорно-радиальный.

В большинстве случаев для опоры сателлитов используются игольчатые подшипники, реже – роликовые.

Во второй строке указывается диаметр тел качения. В третьей и четвертой строках следует указать диаметр окружности центров тел качения и длину тела качения. При этом, если используется шариковые подшипники, то длина указывается равной нулю.

В пятой строке записывается количество тел качения.

Длину иголок рекомендуется брать в переделах формулы (19):

l=(5..10)⋅d_(тк) , | (19)

где d_(тк) – диаметр тел качения, мм;

l – длина ролика, мм.

Нижний предел относится к подшипникам малых, а верхний – к подшипникам больших диаметров.

Если по конструкции необходима большая длина подшипника, чем подсчитанная по вышеприведенным формулам, то следует использовать двухрядную установку иголок.

Боковой зазор между иголками определяют из условия, чтобы при плотной укладке на валу между первой и последней иголкой оставался зазор, определяемый по формуле (20):

t=q⋅d_(тк) , | (20)

где q – коэффициент, равный 0,4…0,8.

При q<0,4 в подшипнике возникает повышенное трение, а при q>0,8 становятся возможными перекос и заклинивание иголок.

В шестую строчку заносится число рядов тел качения. Число иголок находим по формуле (21):

z=(π⋅d_(ср) -q⋅d_(тк))/(d_(тк))=(π⋅(D-d))/(2⋅d_(тк))-q=(π⋅(d+2⋅d_(тк) +d))/(2⋅d_(тк))==π⋅(d/(d_(тк))+1)-q, | (21)

где d_(ср) – диаметр центров тел качения, мм;

D – диаметр внешней беговой дорожки, мм.

Далее указывается номинальный угол контакта подшипника, град, (для игольчатых подшипников этот угол равен нулю) и коэффициент вращения. Для подшипников опоры сателлитов ось не вращается, а вращение совершает сам сателлит, поэтому коэффициент вращения подшипника равен 2.

Затем задаются уже эксплуатационные параметры условий работы подшипника:

- количество передач в коробке передач;
- максимальный момент, развиваемый двигателем;
- максимальная частота вращения двигателя;
- коэффициент использования двигателя;
- средняя частота вращения двигателя;
- пробег до капитального ремонта;
- средняя скорость;
- относительная угловая скорость сателлитов для каждой передачи;
- относительная угловая скорость водила для каждой передачи;
- масса сателлита (вычисляется приблизительно с учетом плотности материала);
- радиус центров осей сателлитов;
- относительный момент на водиле для каждой передачи;
- тип движителя транспортного средства (1колесный; 2 – гусеничный);
- число сателлитов планетарного ряда;
- какая используется функция распределения работы по передачам (0 заданная в программе; 1 – оригинальная).

Таким образом получаем результат расчета, представленный в Приложении Е.

## Расчет фрикционных элементов управления

В планетарных коробках передач для переключения передач используются фрикционные узлы, с помощью которых осуществляется полная остановка звена (тормоза) или совместное движение двух звеньев (блокировочные муфты).

В данной ПКП используются пары трения – сталь-материал на целлюлозной основе, так как данная пара трения наиболее компактна, обладает высоким коэффициентом трения μ , значения которого по [1] лежат в диапазоне от μ_(min) =0,13 до μ_(max) =0,17 , а допускаемое удельное давление [q] на поверхностях трения для данной пары составляет 10 МПа.

Расчет фрикционных элементов управления выполнен в программном комплексе Microsoft Office Excel 2021. Результаты расчета приведены в приложении И. Ниже приведен алгоритм, по которому выполнялся расчет.

Для надежной работы фрикционный элемент должен быть рассчитан на момент M_ф , превышающий расчетный M_н , по формуле (22):

M_ф =β∙M_н , | (22)

где β – коэффициент запаса фрикциона, при трении в масле принимается равным 1,1…1,5[4].

Расчетная схема представлена на рисунке 4. Диски сжимаются силой P , создаваемой поршнем. Момент с ведущих на ведомые детали передается за счет трения между сжатыми фрикционными дисками.

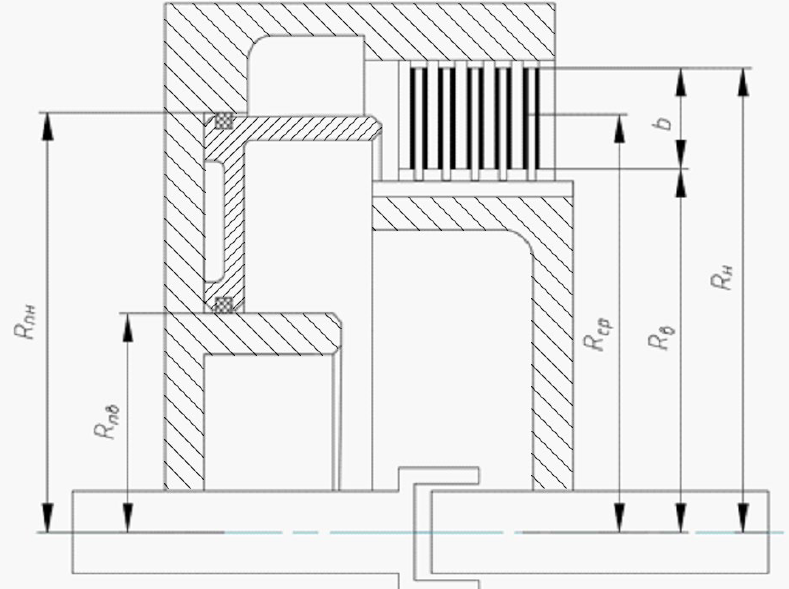
[picture p8: figure]

R_(пн) – наружный радиус поршня, R_(пв) – внутренний радиус поршня, R_(ср) – средний радиус поверхности трения, R_н и R_в - соответственно наружный и внутренний радиусы поверхности трения

Рисунок 4 – расчетная схема фрикционных элементов

Площадь контакта дисков вычисляется по формуле (23):

F=2π∙R_(ср) ∙b∙(1-λ), | (23)

где R_(ср) – средний радиус поверхности трения диска, мм;

b – ширина поверхности трения диска, мм;

λ – коэффициент, учитывающий уменьшение площади поверхности трения дисков с накладками из-за наличия канавок.

Тогда удельное давление на поверхности трения вычисляется по формуле (24):

q=P/(2π∙R_(ср) ∙b∙(1-λ)). | (24)

Момент трения по [1] определяется по формуле (25):

M_ф =2π∙z∙μ∙q∙b∙R_(ср)^2 ∙(1-λ), | (25)

где z – число пар трения.

Выразим средний радиус поверхности трения через наружный радиус диска по формуле (26):

R_(ср) =(R_н +R_в)/2=(R_н)/2∙(1-γ), | (26)

где γ – коэффициент ширины поверхности трения диска, рекомендуется принимать лежащим в диапазоне от 0,1 до 0,2, определяется по формуле (27):

γ=b/(R_н). | (27)

Тогда число пар трения, необходимое для передачи требуемого момента можно определить с помощью выражения (28):

z=(M_ф)/(2π∙μ_(min) ∙[q]∙R_(ср) ∙b∙(1-λ)). | (28)

Осевое усилие P ограничивается лишь допускаемым удельным давлением и рассчитывается по формуле (29):

P=2π∙[q]∙R_(ср) ∙b∙(1-λ). | (29)

Площадь поршня вычисляется по формуле (30)

F_п =(P-P_(пр))/(p_м), | (30)

где p_м – усилие возвратных пружин, как правило составляет приблизительно 20% от осевого усилия сжатия пакета фрикционных дисков P .

## Расчет шлицевых соединений

Расчет шлицевых соединений ведется по напряжениям смятия при максимальном моменте в соединении. Момент определяется из силового расчета ПКП, приведенного в приложении А.

Шлицевые соединения эвольвентные по ГОСТ 6033-80. Исходные данные для расчета шлицевых соединений приведены в таблице 8. На рисунке 5 представлены рассчитываемые шлицевые соединения.

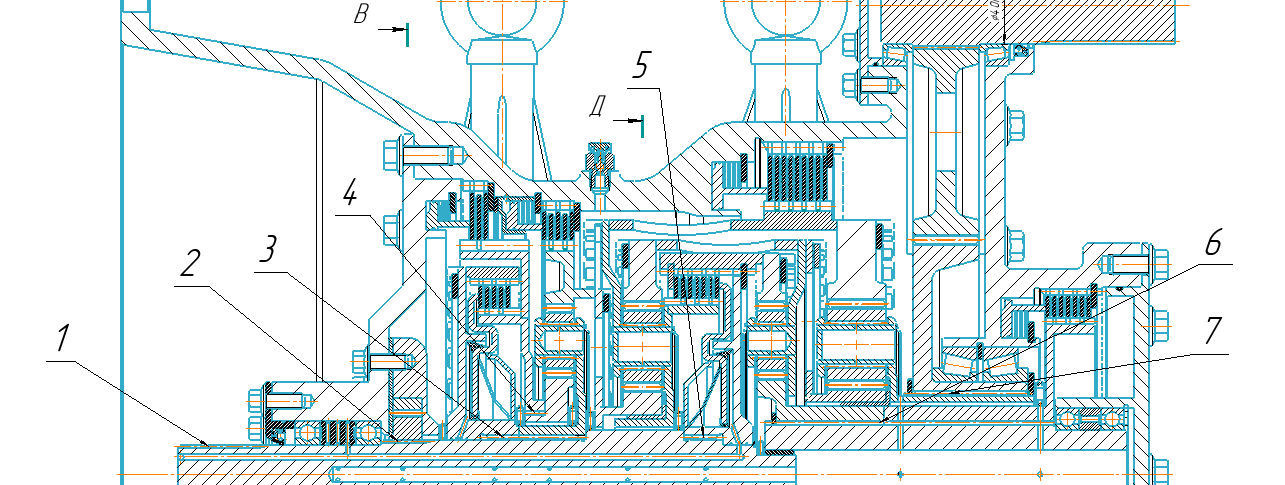
[picture p9: figure]

Рисунок 5 – Рассчитываемые шлицевые соединения

Таблица 8 – Исходные данные для расчета шлицевого соединения

Шлицевое соединение | 1 | 2 | 3 | 4
Обозначение соединения по ГОСТ 6033-80 | 30x1,25x9g | 35x1,25x9g | 40x2x9g | 65x2x9g
Передаваемый момент M_ш , Н∙м | 750 | 750 | 1035 | 285
Шлицевое соединение | 5 | | 6 | 7
Обозначение соединения по ГОСТ 6033-80 | 40x2x9g | | 55x2x9g | 40x2x9g
Передаваемый момент M_ш , Н∙м | 1035 | | 420 | 5872,5

Основным для шлицевых соединений является расчет на смятие [1]. Минимальная допустимая длина соединения определяется по формуле (31):

l_(min) =(10^3 M_ш)/(φ∙F∙r_(ср) ∙[σ]_(см)), | (31)

где φ – коэффициент неравномерности распределения нагрузки по рабочим поверхностям зубьев, принимается равным 0,75 [1];

F – суммарная площадь боковых поверхностей зубьев, с одной стороны, м2;

r_(ср) – средний радиус соединения, м;

[σ]_(см) – допускаемые напряжения смятия для шлицевых соединений, для термообработанных зубьев неподвижного соединения принимаются равными 200 МПа [1].

Суммарная площадь боковых поверхностей зубьев, с одной стороны, определяется по формуле (32):

F=0,8∙z_ш ∙m_ш , | (32)

где z_ш – количество шлицев;

m_ш – модуль шлицевого зацепления.

Расчет по приведенным формулам проводится с помощью программы для расчёта эвольвентных шлицев. Результаты расчета шлицевых соединений представлены в таблице 9.

Таблица 9 – Минимальные длины шлицевых соединений

Шлицевое соединение | 1 | 2 | 3 | 4 | 5 | 6 | 7
Минимальная длина соединения l_(min) , мм | 34,06 | 25,83 | 27,17 | 2,77 | 27,17 | 5,75 | 34,41

# 3 Расчет напряженно-деформированного состояния балансира методом конечных элементов

## Выполнение работы

Для дополнительного подтверждения работоспособности оси сателлита, выполним прочностной расчет методом конечных элементов (МКЭ). Пользуясь данными, полученными в при расчете осей сателитов, определим максимальные усилия, действующие на ось сателлита четвертого планетарного ряда. Исходя из расчета это сила:

N_x =7959 Н.

Имея эти данные и характеристики стали 45Х, из которой выполнена деталь, а именно:

- предел текучести σ_т , равный 835 МПа;

можно приступить к конечно-элементному моделированию.

После загрузки модели в программу ANSYS Workbench 2023 R1 приступим к построению конечно-элементной сетки. 3D-модель оси представлена на рисунке 6. Для наложения сетки было выбрано все тело целиком, что показано на рисунке 7.

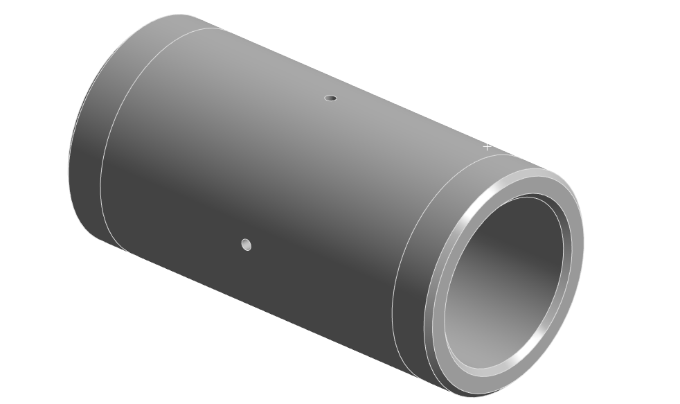
[picture p10: figure]

Рисунок 6 – 3D-модель оси

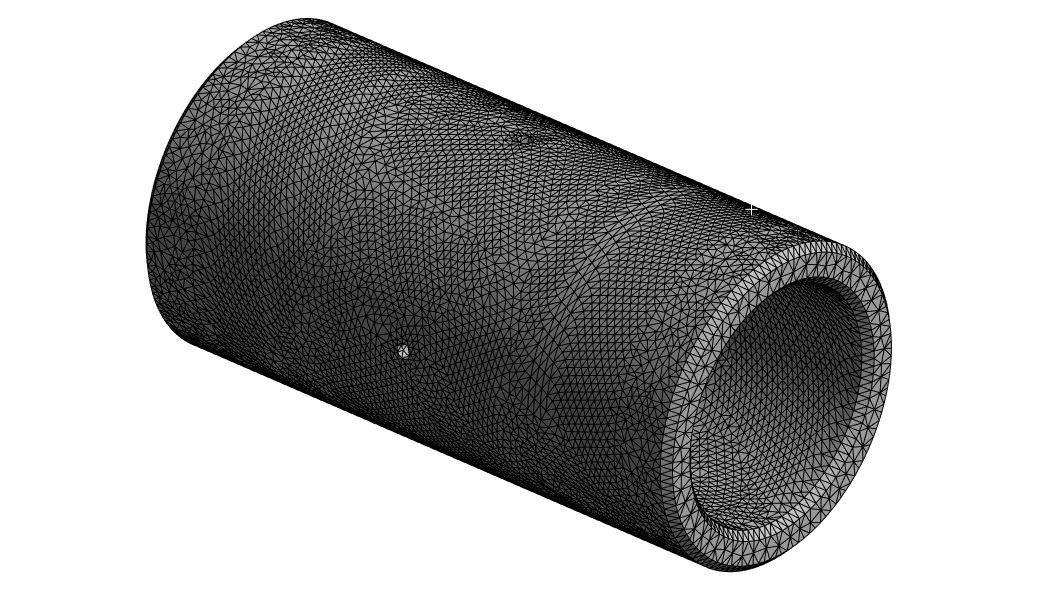
[picture p11: figure]

Рисунок 7 – Наложение сетки на математическую модель

Разбиение на элементы Tet10 показало себя как наиболее точное, о чем свидетельствует график, визуализирующий качество полученных элементов, изображенный на рисунке 8. Размер элемента ‒ 0,5 мм, количество элементов ‒ 88878, количество узлов ‒ 152897.

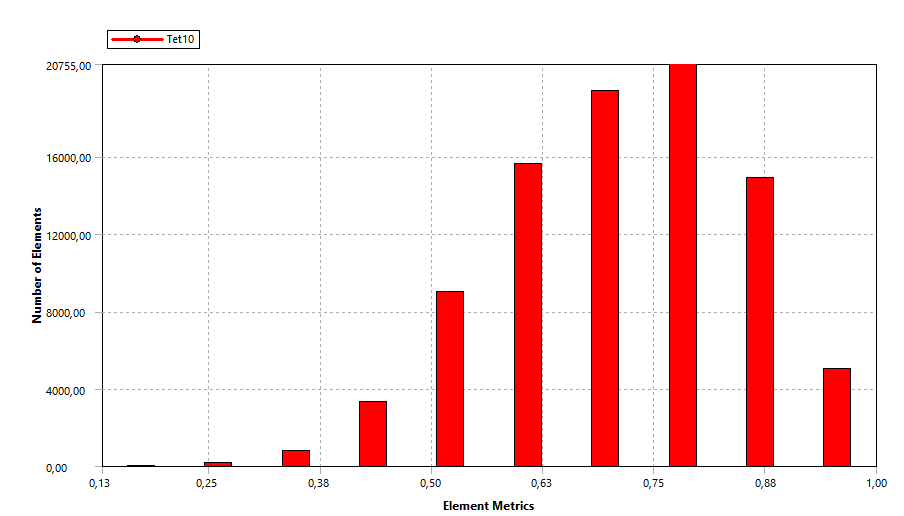
[picture p12: figure]

Рисунок 8 – График качества конечных элементов

Далее следует назначить граничные условия. В нашем случае ими будут являться зафиксированные опоры, расположенные в местах, где ось крепится к щекам водила. Граничные условия изображены на рисунке 9.

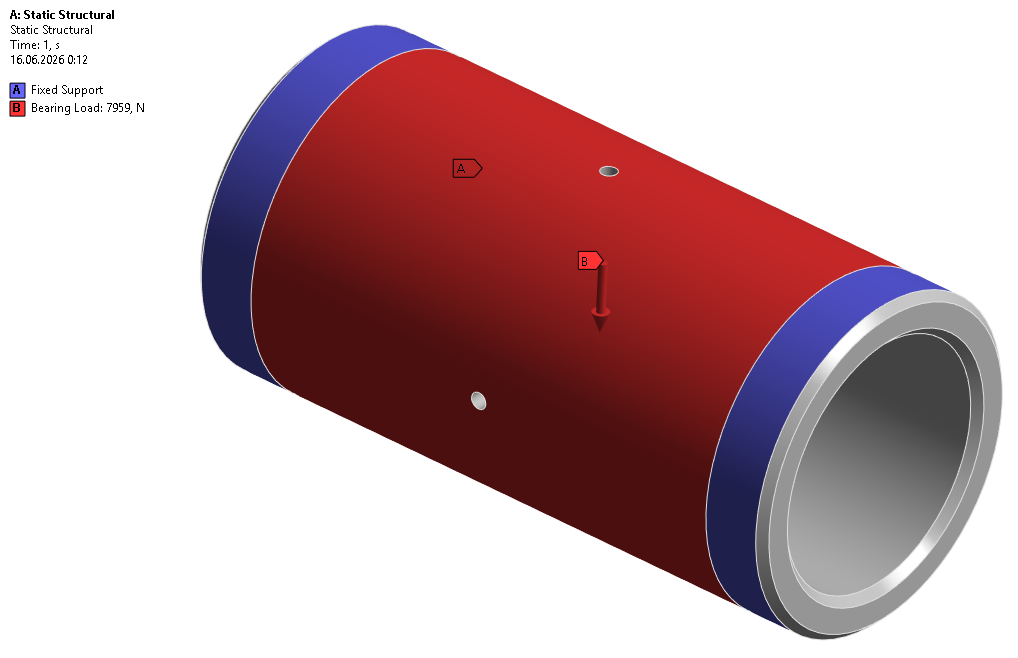
[picture p13: figure]

Рисунок 9 – Режим нагружения

Задав все необходимые граничные условия и нагрузки, можно приступать к расчету. В качестве критерия оценки напряженно-деформированного состояния, предел текучести предполагаемого материала сравнивается с эквивалентными напряжениями, рассчитанными по теории прочности Мизеса. Этот метод предполагает рассмотрение некоторого эквивалентного напряжения, посчитанного на основании трех главных напряжений по формуле (33):

σ_(экв) =1/(√2)√((σ_1 -σ_2 )^2 +(σ_2 -σ_3 )+(σ_3 -σ_1 )) | (33)

где σ_1 – первое главное напряжение;

σ_2 – второеглавное напряжение:

σ_3 – третье главное напряжение.

Данное эквивалентное напряжение сравнивается с пределом текучести материала по формуле (34), на основании чего делается вывод о работоспособности детали.

S=(σ_т)/(σ_(экв)). | (34)

В качестве результатов будем выводить перемещения и напряжения, которые реализуются в изделии вследствие нагружения детали. Полученные результаты представлены на рисунках 10 и 11


Рисунок 10 – Перемещения, реализуемые при нагружении, мм

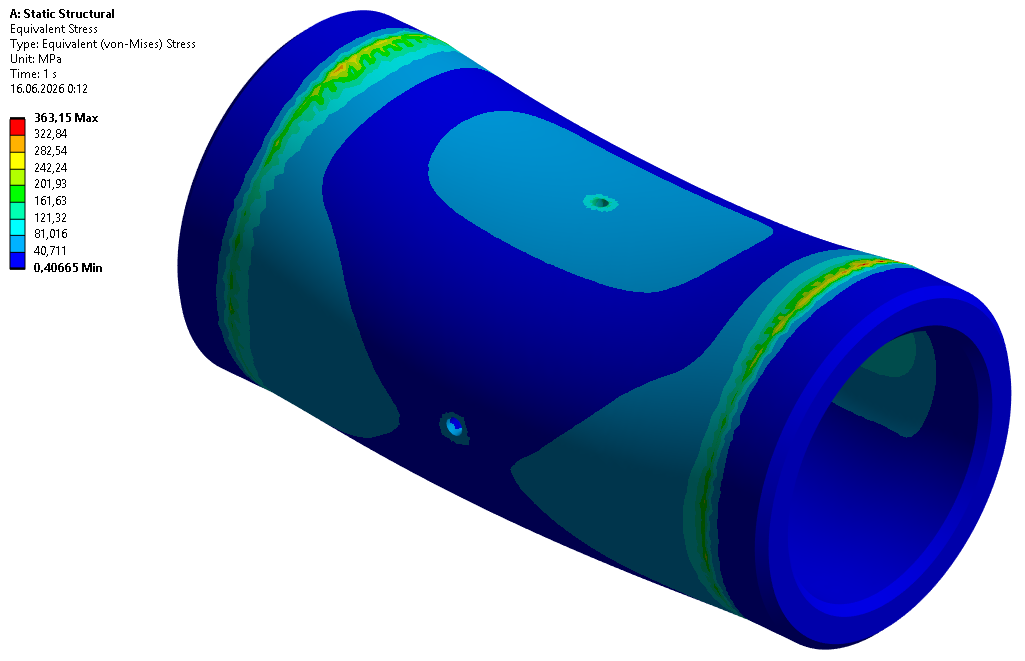
[picture p14: figure]

Рисунок 11 – Эквивалентные напряжения, реализуемые при нагружении, МПа

На рисунке 11 видно, что эквивалентные напряжения концентрируются в областях оси, находящихся рядом с местом ее крепления в щеке водила и около масляного канала. При этом большая часть оси с избыточной прочностью. Максимальные эквивалентные напряжения составили 363,15 МПа. Максимальные перемещения реализовались ближе к центру оси и составили 0,0133 мм.

## Анализ полученных результатов

В ходе работы был проведен расчет на прочность оси сателлита первого планетарного ряда с помощью программного пакета ANSYS. В результате расчета было выявлено, что деталь выдерживает приложенные нагрузки, и эквивалентные напряжения в детали не превышают предела текучести выбранного материала ( σ_т =835 МПа), а значит она не подвергается разрушению и при снятии нагрузки возвращается в свое первоначальное состояние.

Значение коэффициента запаса, считаемого по формуле (34) равно

S=835/(363,15)=2,29.

Можно сделать вывод о том, что деталь спроектирована верно и удовлетворяет прочностным требованиям конструкции. Максимальные перемещения, образующиеся в детали, составили 0,0133 мм. Исходя из вышесказанного, можно сделать вывод о достаточной конструкционной прочности исследуемого объекта.

# ЗАКЛЮЧЕНИЕ

В рамках данного курсового проекта разработана ПКП на 8 передач переднего и 2 передачи заднего хода.

Конструкция полностью отвечает критериям прочности и технологичности. В работе реализован полный цикл расчетов: кинематический, силовой, а также прочностной анализ валов, шлицев, подшипников, осей сателлитов, зубчатых передач и фрикционных пакетов. Дополнительно выполнен КЭ-расчет оси водила первого ряда, оценена технологичность детали и подготовлена пояснительная записка.

Все расчетно-графические задачи решены в программных средах: Mat, MS Excel, Ansys Workbench и Компас-3D.

# СПИСОК ИСПОЛЬЗОВАННЫХ ИСТОЧНИКОВ

1. Харитонов, С.А. Нагайцев М.В. «Расчет и проектирование планетарных коробок передач»/ С.А. Харитонов, М.В. Нагайцев – Москва, МГТУ им. Н. Э. Баумана, 2013, с.227.
2. Зубченко А.С. «Марочник сталей и сплавов» – Москва, «Машиностроение», 2001, с. 672.
3. Ряховский О. А. «Механика в техническом университете» – Москва, изд-во МГТУ им. Н. Э. Баумана, 2002, с. 544.
4. Харитонов, С.А. «Автоматические коробки передач» - Москва, Астрель∙АСТ, 2003, с. 479.
5. Носов, Н. А., Галышев, В. Д., Волков, Ю. П., Харченко, А. П. Расчет и конструирование гусеничных машин [Текст] / Н. А. Носов, В. Д. Галышев, Ю. П. Волков, А. П. Харченко. — Л.: Машиностроение, 1972 — 560 c.: ил.
6. Бруяка В. А., Инженерный анализ в ANSYS Workbench: учеб. пособ. / В. А. Бруяка, В. Г. Фокин, Е. А. Солдусова, Н. А. Глазунова, И. Е. Адеянов — Самара: Самар. гос. техн. ун-т, 2010. — 271 с.: ил.

# ПРИЛОЖЕНИЕ А

Количество планетарных рядов - 4

Количество элементов управления - 6

Количество звеньев ПКП - 7

Количество передач ПКП - 10

Схема ПКП:

ПР 3 1 2

ПР 2 5 6

ПР 4 6 1

ПР 6 7 5

Схема элементов управления:

1) 2 0

2) 3 0

3) 4 0

4) 5 0

5) 1 5

6) 1 3

Схема включения элементов управления на передачах:

1) 4 3 0

2) 1 3 0

3) 3 6 0

4) 2 3 0

5) 5 3 0

6) 2 5 0

7) 5 6 0

8) 1 5 0

9) 4 6 0

10) 2 4 0

Число зубьев шестерен планетарных рядов:

ПР1: -10 17 0 16.4

ПР2: -10 17 0 19.2

ПР3: -10 17 0 17

ПР4: -10 17 0 19

Конструктивные параметры планетарных рядов:

ПР1: -1.64

ПР2: -1.92

ПР3: -1.7

ПР4: -1.9

КПД планетарных рядов:

ПР1: 0.97

ПР2: 0.97

ПР3: 0.97

ПР4: 0.97

************************************************************

РЕЗУЛЬТАТЫ РАСЧЕТОВ

I Передача I 1 I 2 I 3 I 4 I 5 I 6 I 7 I 8 I 9 I 10 I

I I(0X) I 7.830 I 3.481 I 1.954 I 1.542 I 1.277 I 1.123 I 1.000 I 0.848 I -5.568 I -3.459 I

I q I I 2.249 I 1.781 I 1.267 I 1.207 I 1.137 I 1.123 I 1.180 I 0.000 I 0.000 I

I КПД I 0.962 I 0.973 I 0.981 I 0.972 I 0.991 I 0.991 I 1.000 I 0.992 I 0.951 I 0.940 I

Средний КПД: 0.982773; Диапазон: 9.23625

Угловые скорости звеньев

I Звено 1 I 1.000 I 1.000 I 1.000 I 1.000 I 1.000 I 1.000 I 1.000 I 1.000 I 1.000 I 1.000 I

I Звено 2 I -0.711 I 0.000 I 1.000 I 1.610 I 2.209 I 1.610 I 1.000 I 0.000 I 1.000 I 1.610 I

I Звено 3 I 3.806 I 2.640 I 1.000 I 0.000 I -0.983 I 0.000 I 1.000 I 2.640 I 1.000 I 0.000 I

I Звено 4 I 0.000 I 0.000 I 0.000 I 0.000 I 0.000 I 0.496 I 1.000 I 1.827 I -1.415 I -1.920 I

I Звено 5 I 0.000 I 0.244 I 0.586 I 0.795 I 1.000 I 1.000 I 1.000 I 1.000 I 0.000 I 0.000 I

I Звено 6 I 0.370 I 0.370 I 0.370 I 0.370 I 0.370 I 0.682 I 1.000 I 1.521 I -0.521 I -0.838 I

I Звено 7 I 0.128 I 0.287 I 0.512 I 0.648 I 0.783 I 0.890 I 1.000 I 1.180 I -0.180 I -0.289 I

Относительные угловые скорости сателлитов

I Wст(мцк)1 ряда I -8.769 I -5.125 I 0.000 I 3.125 I 6.196 I 3.125 I 0.000 I -5.125 I 0.000 I 3.125 I

I Wст(мцк)2 ряда I 1.546 I 0.529 I -0.900 I -1.772 I -2.628 I -1.326 I 0.000 I 2.174 I -2.174 I -3.499 I

I Wст(мцк)3 ряда I -1.799 I -1.799 I -1.799 I -1.799 I -1.799 I -0.907 I 0.000 I 1.488 I -4.345 I -5.253 I

I Wст(мцк)4 ряда I -0.539 I -0.185 I 0.314 I 0.618 I 0.917 I 0.462 I 0.000 I -0.758 I 0.758 I 1.221 I

Моменты на МЦК планетарных рядов

I M(мцк)1 ряда I -0.00 I -0.00 I 0.27 I 0.21 I -0.00 I -0.12 I -0.11 I -0.00 I 0.38 I 0.38 I

I M(мцк)2 ряда I -0.00 I -0.78 I -0.44 I -0.35 I -0.00 I 0.20 I 0.18 I 0.15 I -1.00 I -0.62 I

I M(мцк)3 ряда I -1.00 I -1.00 I -0.56 I -0.44 I -0.16 I -0.00 I -0.00 I -0.00 I -0.00 I -0.00 I

I M(мцк)4 ряда I -2.70 I -1.20 I -0.67 I -0.53 I -0.44 I -0.39 I -0.34 I -0.29 I 1.92 I 1.19 I

Моменты на водилах планетарных рядов

I M(вод)1 ряда I 0.00 I 0.00 I -0.71 I -0.56 I 0.00 I 0.32 I 0.29 I 0.00 I -1.61 I -1.00 I

I M(вод)2 ряда I 0.00 I 2.28 I 1.28 I 1.01 I 0.00 I -0.59 I -0.52 I -0.44 I 2.92 I 1.81 I

I M(вод)3 ряда I 2.70 I 2.70 I 1.52 I 1.20 I 0.44 I 0.00 I 0.00 I 0.00 I 0.00 I 0.00 I

I M(вод)4 ряда I 7.83 I 3.48 I 1.95 I 1.54 I 1.28 I 1.12 I 1.00 I 0.85 I -5.57 I -3.46 I

Моменты на БЦК планетарных рядов

I M(бцк)1 ряда I -0.00 I -0.00 I 0.44 I 0.35 I -0.00 I -0.20 I -0.18 I -0.00 I 1.00 I 0.62 I

I M(бцк)2 ряда I -0.00 I -1.50 I -0.84 I -0.66 I -0.00 I 0.39 I 0.34 I 0.29 I -1.92 I -1.19 I

I M(бцк)3 ряда I -1.70 I -1.70 I -0.95 I -0.75 I -0.28 I -0.00 I -0.00 I -0.00 I -0.00 I -0.00 I

I M(бцк)4 ряда I -5.13 I -2.28 I -1.28 I -1.01 I -0.84 I -0.74 I -0.66 I -0.56 I 3.65 I 2.27 I

Мощность на МЦК планетарных рядов

I N(мцк)1 ряда I -0.00 I -0.00 I 0.27 I 0.00 I 0.00 I -0.00 I -0.11 I -0.00 I 0.61 I 0.00 I

I N(мцк)2 ряда I 0.00 I -0.00 I -0.44 I -0.56 I -0.00 I 0.32 I 0.18 I 0.00 I -1.00 I -1.00 I

I N(мцк)3 ряда I -1.00 I -1.00 I -0.56 I -0.44 I -0.16 I -0.00 I -0.00 I -0.00 I -0.00 I -0.00 I

I N(мцк)4 ряда I -1.00 I -0.44 I -0.25 I -0.20 I -0.16 I -0.26 I -0.34 I -0.44 I -1.00 I -1.00 I

Мощность на водилах планетарных рядов

I N(вод)1 ряда I 0.00 I 0.00 I -0.71 I -0.56 I 0.00 I 0.32 I 0.29 I 0.00 I -1.61 I -1.00 I

I N(вод)2 ряда I 0.00 I 0.56 I 0.75 I 0.80 I 0.00 I -0.59 I -0.52 I -0.44 I 0.00 I 0.00 I

I N(вод)3 ряда I 1.00 I 1.00 I 0.56 I 0.44 I 0.16 I 0.00 I 0.00 I 0.00 I -0.00 I -0.00 I

I N(вод)4 ряда I 1.00 I 1.00 I 1.00 I 1.00 I 1.00 I 1.00 I 1.00 I 1.00 I 1.00 I 1.00 I

Мощность на БЦК планетарных рядов

I N(бцк)1 ряда I 0.00 I -0.00 I 0.44 I 0.56 I -0.00 I -0.32 I -0.18 I -0.00 I 1.00 I 1.00 I

I N(бцк)2 ряда I -0.00 I -0.56 I -0.31 I -0.25 I -0.00 I 0.26 I 0.34 I 0.44 I 1.00 I 1.00 I

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

k= 1.702 A(CT)= 6 Z(МЦК)= 131 Z(CT)= 46 Z(БЦК)= 223

k= 1.700 A(CT)= 6 Z(МЦК)= 140 Z(CT)= 49 Z(БЦК)= 238

k= 1.698 A(CT)= 6 Z(МЦК)= 149 Z(CT)= 52 Z(БЦК)= 253

k= 1.702 A(CT)= 6 Z(МЦК)= 151 Z(CT)= 53 Z(БЦК)= 257

k= 1.700 A(CT)= 6 Z(МЦК)= 160 Z(CT)= 56 Z(БЦК)= 272

k= 1.698 A(CT)= 6 Z(МЦК)= 169 Z(CT)= 59 Z(БЦК)= 287

k= 1.702 A(CT)= 6 Z(МЦК)= 171 Z(CT)= 60 Z(БЦК)= 291

k= 1.700 A(CT)= 6 Z(МЦК)= 180 Z(CT)= 63 Z(БЦК)= 306

k= 1.698 A(CT)= 6 Z(МЦК)= 189 Z(CT)= 66 Z(БЦК)= 321

k= 1.702 A(CT)= 6 Z(МЦК)= 191 Z(CT)= 67 Z(БЦК)= 325

k= 1.700 A(CT)= 6 Z(МЦК)= 200 Z(CT)= 70 Z(БЦК)= 340

k= 1.699 A(CT)= 6 Z(МЦК)= 209 Z(CT)= 73 Z(БЦК)= 355

k= 1.701 A(CT)= 6 Z(МЦК)= 211 Z(CT)= 74 Z(БЦК)= 359

k= 1.700 A(CT)= 6 Z(МЦК)= 220 Z(CT)= 77 Z(БЦК)= 374

k= 1.699 A(CT)= 6 Z(МЦК)= 229 Z(CT)= 80 Z(БЦК)= 389

k= 1.701 A(CT)= 6 Z(МЦК)= 231 Z(CT)= 81 Z(БЦК)= 393

k= 1.700 A(CT)= 6 Z(МЦК)= 240 Z(CT)= 84 Z(БЦК)= 408

k= 1.699 A(CT)= 6 Z(МЦК)= 249 Z(CT)= 87 Z(БЦК)= 423

k= 1.701 A(CT)= 6 Z(МЦК)= 251 Z(CT)= 88 Z(БЦК)= 427

k= 1.700 A(CT)= 6 Z(МЦК)= 260 Z(CT)= 91 Z(БЦК)= 442

k= 1.699 A(CT)= 6 Z(МЦК)= 269 Z(CT)= 94 Z(БЦК)= 457

k= 1.701 A(CT)= 6 Z(МЦК)= 271 Z(CT)= 95 Z(БЦК)= 461

k= 1.700 A(CT)= 6 Z(МЦК)= 280 Z(CT)= 98 Z(БЦК)= 476

k= 1.699 A(CT)= 6 Z(МЦК)= 289 Z(CT)= 101 Z(БЦК)= 491

k= 1.701 A(CT)= 6 Z(МЦК)= 291 Z(CT)= 102 Z(БЦК)= 495

k= 1.700 A(CT)= 6 Z(МЦК)= 300 Z(CT)= 105 Z(БЦК)= 510

k= 1.699 A(CT)= 6 Z(МЦК)= 309 Z(CT)= 108 Z(БЦК)= 525

k= 1.701 A(CT)= 6 Z(МЦК)= 311 Z(CT)= 109 Z(БЦК)= 529

k= 1.700 A(CT)= 6 Z(МЦК)= 320 Z(CT)= 112 Z(БЦК)= 544

k= 1.699 A(CT)= 6 Z(МЦК)= 329 Z(CT)= 115 Z(БЦК)= 559

k= 1.701 A(CT)= 6 Z(МЦК)= 331 Z(CT)= 116 Z(БЦК)= 563

k= 1.700 A(CT)= 6 Z(МЦК)= 340 Z(CT)= 119 Z(БЦК)= 578

k= 1.699 A(CT)= 6 Z(МЦК)= 349 Z(CT)= 122 Z(БЦК)= 593

k= 1.701 A(CT)= 6 Z(МЦК)= 351 Z(CT)= 123 Z(БЦК)= 597

k= 1.700 A(CT)= 6 Z(МЦК)= 360 Z(CT)= 126 Z(БЦК)= 612

k= 1.699 A(CT)= 6 Z(МЦК)= 369 Z(CT)= 129 Z(БЦК)= 627

k= 1.701 A(CT)= 6 Z(МЦК)= 371 Z(CT)= 130 Z(БЦК)= 631

# ПРИЛОЖЕНИЕ В

Планетарный ряд №1

ГИСТОГРАММЫ РАСПРЕДЕЛЕНИЕ ВРЕМЕНИ ДВИЖЕНИЯ ПО ПЕРЕДАЧАМ:

0.01 0.02 0.04 0.05 0.07 0.13 0.23 0.4 0.05 0.025

ИСХОДНЫЕ ДАННЫЕ

МОДУЛЬ ЗАЦПЛЕНИЯ - 2.00

ЧИСЛО ЗУБЬЕВ МЦК - 50 САТ(МЦК) - 16 САТ(БЦК) - 0 БЦК - 82

САТЕЛЛИТЫ ОДНОВЕНЦОВЫЕ

УГОЛ НАКЛОНА ЗУБЬЕВ (град.) - 15.00

КОЭФФИЦИЕНТЫ СМЕЩЕНИЯ: МЦК - 0.000 САТ1 - 0.000 САТ2 - 0.000 БЦК - 0.000

ШИРИНА ЗУБЧАТОГО ВЕНЦА (мм) - 15.00

ЧИСЛО САТЕЛЛИТОВ - 3

МАРКА СТАЛИ: МЦК - 20ХНМ САТ1 - 20ХНМ САТ2 - 20ХНМ БЦК - 20ХНМ

СПОСОБ ТЕРМИЧЕСКОЙ ОБРАБОТКИ ПОВЕРХНОСТЕЙ ЗУБЬЕВ: МЦК - 4 САТ1 - 4 САТ2 - 4 БЦК - 4

ТВЕРДОСТЬ ПОВЕРХНОСТЕЙ ЗУБЬЕВ: МЦК - 60 САТ1 - 60 САТ2 - 60 БЦК - 60

ВИД ОБРАБОТКИ ПЕРЕХОДНОЙ ПОВЕРХНОСТИ ЗУБЬЕВ: МЦК - 0 САТ1 - 0 САТ2 - 0 БЦК - 0

Kоэффициент, учитывающий способ получения заготовки: МЦК - 2 САТ1 - 2 САТ2 - 2 БЦК - 2

Номер схемы расположения зубчатых колес относительно опор: 6

Количество передач переднего хода: 8

Количество передач заднего хода: 2

МАКСИМАЛЬНЫЙ МОМЕНТ ДВИГАТЕЛЯ, Нм: 750

Максимальная частота вращения ведущего вала, об/мин: 3000

Коэффициент использования момента двигателя: 0.45

Средняя частота вращения двигателя, об/мин: 1950

Пробег до капитального ремонта, км: 250000

Средняя скорость, км/ч: 25

Коэффициент трансформации момента гидротрансформатора на стоповом режиме: 1.00

Коэффициенты частоты вращения МЦК на передачах:

4.623 2.64 1 0 -0.166 0 1 2.64 1 0

Коэффициенты частоты вращения водила на передачах:

1 1 1 1 1 1 1 1 1 1

Коэффициенты момента МЦК на передачах:

0 0 0.12 0.16 0 -0.12 -0.07 0 0.38 0.38

Тип движителя: 2

****************************************************

Расчет геометрии пары МЦК-Сателлит

Коэффициенты смещения Х(1)= 0, X(2)= 0

Делительное межосевое расстояние a, мм: 68.3282

Коэффициент суммы смещений - X(СУМ)= 0

Угол профиля ALFA(t)= 20.6469

Угол зацепления ALFA(tw)= 20.6469

Межосевое расстояние a(w), мм= 68.3282

Делительные диаметры d, мм:

Шестерни = 33.1288 Колеса = 103.528

Передаточное отношение U= 3.125

Начальные диаметры d(w), мм:

Шестерни = 33.1288 Колеса = 103.528

Коэффициент воспринимаемого смещения Y = 0

Коэффициент уравнительного смещения DELTA(Y) = 0

Диаметры вершин зубьев d(a), мм:

Шестерни: 37.1288 Колеса: 107.528

Диаметры впадин зубьев d(f), мм:

Шестерни: 28.1288 Колеса: 98.5276

Ocновной диаметр d(b), мм:

Шестерни: 31.001 Колеса: 96.8782

Угол профиля зуба в точке окружности вершин ALFA(a):

Шестерни: 33.3886 Колеса: 25.7154

Шаг зацепления P(alfa), мм: 5.90127

Осевой шаг P(x), мм: 24.2641

Коэффициенты торцевого перекрытия E(ALFA):

Шестерни: 0.718826 Колеса: 0.833875

Коэффициенты торцевого перекрытия E(ALFA): 1.5527

Коэффициенты осевого перекрытия E(BETTA): 1.5527

Коэффициенты перекрытия E(Y): 2.1709

Основной угол наклона BETTA(B): 14.0761

Эквивалентное число зубьев Z(V):

Шестерни: 17.7537 Колеса: 55.4803

Окружная скорость в зацеплении V, м/с: 16.2621

Удельное скольжение:

Шестерни: -0.855395 Колеса: 1.30066

Степень точности изготовления зубчатых колес: 6

****************************************************

КОЭФФИЦИЕНТ НЕРАВНОМЕРНОСТИ РАСПРЕДЕЛЕНИЯ НАГРУЗКИ 1.000

****************************************************

Расчет на контактную прочность для ПРЯМОГО действия нагрузки

МЦК-Сателлит

ОПРЕДЕЛЕНИЕ ДОПУСКАЕМЫХ НАПРЯЖЕНИЙ ПРИ РАСЧЕТЕ НА КОНТАКТНУЮ ВЫНОСЛИВОСТЬ

СУММАРНОЕ ЧИСЛО ЦИКЛОВ НАГРУЖЕНИЙ: ШЕСТЕРНИ - 2.74219e+08 КОЛЕСА - 2.6325e+08

РАСЧЕТ ВЕДЕТСЯ ПРИ ПЕРЕМЕННОЙ НАГРУЗКЕ И ПОСТОЯННЫХ ОБОРОТАХ

Oкружная сила на делительном диаметре F(TH), H - 825.867

Kоэффициент учитывающий характер циклограммы нагружения, MJU:

Шестерни - 0.0008 Колеса - 0.8404

Эквивалентное число циклов перемены напряжений N(HE):

Шестерни - 92133.6 Колеса - 1.0085e+08

Коэффициенты, учитывающие окружную скорость Z(V):

Шестерни - 1.04075 Колеса - 1.04075

Kоэффициент, учитывающий радиальный размер зубчатого колеса K(XH):

Шестерни - 1 Колеса - 1

Kоэффициент, учитывающий влияние смазки K(L) - 1

Kоэффициент, учитывающий шероховатость сопряженных поверхностей зубьев Z(R) - 1

Коэффициент долговечности Z(N):

Шестерни - 1.8 Колеса - 1.0294

Предел контактной выносливости поверхностей зубьев SIGMA(HLIM), MПa:

Шестерни - 2484 Колеса - 1420.57

Допускаемые контактные напряжения SIGMA(HP), МПа:

Шестерни - 2154.35 Колеса - 1232.05

Допускаемые контактные напряжения передачи, МПа - 1317.33

РАСЧЕТ НА КОНТАКТНУЮ ВЫНОСЛИВОСТЬ

Коэффициент, учитывающий форму сопряженных поверхностей зубьев, Z(H) - 2.42473

Коэффициент, учитывающий суммарную длину контактных линий, Z(EPSILON) - 0.84238

Коэффициент, учитывающий внешнюю динамическую нагрузку K(A) - 1.75

Коэффициент, учитывающий распределение нагрузки между зубьями, K(HALFA) - 1.02819

Коэффициент, учитывающий динамическую нагрузку, возникающую в зацеплении, K(HV) - 1.11696

Коэффициент, учитывающий распределение нагрузки по ширине венца, K(HBETTA) -1.03149

Коэффициент нагрузки K(H) - 2.07308

Контактные напряжения без учета дополнительных нагрузок SIGMA(HO), МПа - 574.803

Действующие в полюсе зацепления контактные напряжения SIGMA(H), МПа - 827.612

РАСЧЕТ НА КОНТАКТНУЮ ПРОЧНОСТЬ ПРИ ДЕЙСТВИИ МАКСИМАЛЬНОЙ НАГРУЗКИ

Коэффициент, учитывающий динамическую нагрузку, возникающую в зацеплении при max моменте, K(HV) - 1.05263

Коэффициент нагрузки K(HMAX) - 1.95368

Максимальный момент М(max), Нм - 95

Средний момент М(1), Нм - 42.75

Контактные напряжения при действии максимальной нагрузки SIGMA(HMAX), МПа - 1197.68

Допускаемые контактные напряжения при действии максимальной нагрузки SIGMA(HPMAX):

Шестерни - 2640 Колеса - 2640

****************************************************

Расчет на контактную прочность для реверсивной нагрузки

МЦК-Сателлит

ОПРЕДЕЛЕНИЕ ДОПУСКАЕМЫХ НАПРЯЖЕНИЙ ПРИ РАСЧЕТЕ НА КОНТАКТНУЮ ВЫНОСЛИВОСТЬ

РАСЧЕТ ВЕДЕТСЯ ПРИ ПОСТОЯННОЙ НАГРУЗКЕ

Коэффициенты, учитывающие окружную скорость Z(V):

Шестерни - 1.04075 Колеса - 1.04075

Kоэффициент, учитывающий радиальный размер зубчатого колеса K(XH):

Шестерни - 1 Колеса - 1

Kоэффициент, учитывающий влияние смазки K(L) - 1

Kоэффициент, учитывающий шероховатость сопряженных поверхностей зубьев Z(R) - 1

Коэффициент долговечности Z(N):

Шестерни - 0.933491 Колеса - 0.935398

Предел контактной выносливости поверхностей зубьев SIGMA(HLIM), MПa:

Шестерни - 1288.22 Колеса - 1290.85

Допускаемые контактные напряжения SIGMA(HP), МПа:

Шестерни - 1117.26 Колеса - 1119.54

Допускаемые контактные напряжения передачи, МПа - 1089.35

РАСЧЕТ НА КОНТАКТНУЮ ВЫНОСЛИВОСТЬ

Коэффициент, учитывающий форму сопряженных поверхностей зубьев, Z(H) - 2.42473

Коэффициент, учитывающий суммарную длину контактных линий, Z(EPSILON) - 0.84238

Коэффициент, учитывающий внешнюю динамическую нагрузку K(A) - 1.75

Коэффициент, учитывающий распределение нагрузки между зубьями, K(HALFA) - 1.02819

Коэффициент, учитывающий динамическую нагрузку, возникающую в зацеплении, K(HV) - 1.37038

Коэффициент, учитывающий распределение нагрузки по ширине венца, K(HBETTA) -1.03149

Коэффициент нагрузки K(H) - 2.54342

Контактные напряжения без учета дополнительных нагрузок SIGMA(HO), МПа - 323.012

Действующие в полюсе зацепления контактные напряжения SIGMA(H), МПа - 515.142

РАСЧЕТ НА КОНТАКТНУЮ ПРОЧНОСТЬ ПРИ ДЕЙСТВИИ МАКСИМАЛЬНОЙ НАГРУЗКИ

Коэффициент, учитывающий динамическую нагрузку, возникающую в зацеплении при max моменте, K(HV) - 1.16667

Коэффициент нагрузки K(HMAX) - 2.16534

Максимальный момент М(max), Нм - 30

Средний момент М(1), Нм - 13.5

Контактные напряжения при действии максимальной нагрузки SIGMA(HMAX), МПа - 708.557

Допускаемые контактные напряжения при действии максимальной нагрузки SIGMA(HPMAX):

Шестерни - 2640 Колеса - 2640

****************************************************

РАСЧЕТ НА ИЗГИБНУЮ ПРОЧНОСТЬ ПАРЫ МЦК-САТЕЛЛИТ

Расчет зубьев МЦК

ОПРЕДЕЛЕНИЕ ДОПУСКАЕМЫХ НАПРЯЖЕНИЙ ПРИ РАСЧЕТЕ НА ИЗГИБНУЮ ВЫНОСЛИВОСТЬ

ПРЯМОЕ ДЕЙСТВИЕ НАГРУЗКИ

Oкружная сила на делительном диаметре для прямого действия нагрузки F(TF), H - 825.867

Kоэффициент, учитывающий характер циклограммы для прямого действия нагрузки MJU(F1) - 21.9375

Эквивалентное число циклов перемены напряжений для прямого действия нагрузки N(FE) - 8.775e+07

Расчетный момент, M(H) - 13.68

Kоэффициент, учитывающий характер циклограммы для прямого действия нагрузки MJU(F1) - 21.9987

Эквивалентное число циклов перемены напряжений для прямого действия нагрузки N(FE) - 8.79949e+07

Расчетный момент, M(H) - 13.68

Коэффициент долговечности K(FL) - 1.000

РЕВЕРСИВНОЕ ДЕЙСТВИЕ НАГРУЗКИ

НАГРУЗКА ПОСТОЯННА

Oкружная сила на делительном диаметре для реверсивного действия нагрузки F(TF), H - 260.8

РАСЧЕТНЫЙ МОМЕНТ, Hм - 4.32

СКОРОСТЬ В ЗАЦЕПЛЕНИИ, м/с - 10.5704

ЧИСЛО ЦИКЛОВ - 4.563e+08

Коэффициент долговечности для реверсивного действия нагрузки K(FL) - 1

Kоэффициент, учитывающий влияние двухстороннего приложения нагрузки, K(FC) - 0.921053

Kоэффициент, учитывающий влияние деформационного упрочнeния или электрохимической обработки переходной поверхности, K(FG) - 0.75

Kоэффициент, учитывающий влияние шлифования переходной - 1

Kоэффициент, учитывающий влияние шлифования переходной поверхности зуба шестерни, K(FD) - 1

Предел изломной выносливости, SIGMA(FLIM0), МПа - 950

Предел выносливости зубьев колес при изгибе, SIGMA(FLIM), МПа - 712.5

Kоэффициент безопасности, S(F) - 1.7825

Kоэффициент, учитывающий градиент напряжений и чувствительность материала к концентрации напряжений, Y(S) - 1.03022

Kоэффициент, учитывающий шероховатость переходной поверхности, Y(R) - 1

Kоэффициент, учитывающий размеры зубчатого колеса, K(XF) - 1

Допускаемое изгибное напряжение при расчете на выносливость, МПа - 411.8

РАСЧЕТ НА ИЗГИБНУЮ ВЫНОСЛИВОСТЬ

Коэффициент, учитывающий динамическую нагрузку, возникающую в зацеплении, K(FV) - 1.117

Коэффициент, учитывающий распределение нагрузки по ширине венца, K(FBETTA) - 1.057

Коэффициент, учитывающий распределение нагрузки между зубьями, K(FALFA) - 1.028

Коэффициент внешней динамической нагрузки KA - 1.750

Коэффициент нагрузки, K(F) - 2.125

Коэффициент, учитывающий наклон зубьев, Y(BETTA) - 0.934

Коэффициент, учитывающий перекрытие зубьев, Y(E) - 0.644

Коэффициент, учитывающий форму зуба, Y(FS) - 3.708

Действующие в полюсе зацепления изгибные напряжения, SIGMA(F), МПа - 130.463

РАСЧЕТ НА ИЗГИБНУЮ ПРОЧНОСТЬ ПРИ ДЕЙСТВИИ МАКСИМАЛЬНОЙ НАГРУЗКИ

Максимальная расчетная нагрузка F(Tmax), Н - 1835.26

Pасчетная нагрузка F(T), Н - 825.867

Действующие максимальные изгибные напряжения SIGMA(FMAX), МПа - 165.667

Допускаемые максимальные изгибные напряжения SIGMA(FPMAX), МПа - 1932

Расчет зубьев сателлита

ОПРЕДЕЛЕНИЕ ДОПУСКАЕМЫХ НАПРЯЖЕНИЙ ПРИ РАСЧЕТЕ НА ИЗГИБНУЮ ВЫНОСЛИВОСТЬ

ПРЯМОЕ ДЕЙСТВИЕ НАГРУЗКИ

Oкружная сила на делительном диаметре для прямого действия нагрузки F(TF), H - 825.867

Kоэффициент, учитывающий характер циклограммы для прямого действия нагрузки MJU(F1) - 0

Эквивалентное число циклов перемены напряжений для прямого действия нагрузки N(FE) - 0

Расчетный момент, M(H) - 42.75

Kоэффициент, учитывающий характер циклограммы для прямого действия нагрузки MJU(F1) - 0

Эквивалентное число циклов перемены напряжений для прямого действия нагрузки N(FE) - 0

Расчетный момент, M(H) - 42.75

Коэффициент долговечности K(FL) - 1.630

РЕВЕРСИВНОЕ ДЕЙСТВИЕ НАГРУЗКИ

НАГРУЗКА ПОСТОЯННА

Oкружная сила на делительном диаметре для реверсивного действия нагрузки F(TF), H - 260.8

РАСЧЕТНЫЙ МОМЕНТ, Hм - 13.5

СКОРОСТЬ В ЗАЦЕПЛЕНИИ, м/с - 10.5704

ЧИСЛО ЦИКЛОВ - 4.75312e+08

Коэффициент долговечности для реверсивного действия нагрузки K(FL) - 1

Kоэффициент, учитывающий влияние двухстороннего приложения нагрузки, K(FC) - 0.871316

Kоэффициент, учитывающий влияние деформационного упрочнeния или электрохимической обработки переходной поверхности, K(FG) - 0.75

Kоэффициент, учитывающий влияние шлифования переходной - 1

Kоэффициент, учитывающий влияние шлифования переходной поверхности зуба шестерни, K(FD) - 1

Предел изломной выносливости, SIGMA(FLIM0), МПа - 950

Предел выносливости зубьев колес при изгибе, SIGMA(FLIM), МПа - 1011.92

Kоэффициент безопасности, S(F) - 1.7825

Kоэффициент, учитывающий градиент напряжений и чувствительность материала к концентрации напряжений, Y(S) - 1.03022

Kоэффициент, учитывающий шероховатость переходной поверхности, Y(R) - 1

Kоэффициент, учитывающий размеры зубчатого колеса, K(XF) - 1

Допускаемое изгибное напряжение при расчете на выносливость, МПа - 584.857

РАСЧЕТ НА ИЗГИБНУЮ ВЫНОСЛИВОСТЬ

Коэффициент, учитывающий динамическую нагрузку, возникающую в зацеплении, K(FV) - 1.117

Коэффициент, учитывающий распределение нагрузки по ширине венца, K(FBETTA) - 1.057

Коэффициент, учитывающий распределение нагрузки между зубьями, K(FALFA) - 1.028

Коэффициент внешней динамической нагрузки KA - 1.750

Коэффициент нагрузки, K(F) - 2.125

Коэффициент, учитывающий наклон зубьев, Y(BETTA) - 0.934

Коэффициент, учитывающий перекрытие зубьев, Y(E) - 0.644

Коэффициент, учитывающий форму зуба, Y(FS) - 4.214

Действующие в полюсе зацепления изгибные напряжения, SIGMA(F), МПа - 148.252

РАСЧЕТ НА ИЗГИБНУЮ ПРОЧНОСТЬ ПРИ ДЕЙСТВИИ МАКСИМАЛЬНОЙ НАГРУЗКИ

Максимальная расчетная нагрузка F(Tmax), Н - 1835.26

Pасчетная нагрузка F(T), Н - 825.867

Действующие максимальные изгибные напряжения SIGMA(FMAX), МПа - 188.256

Допускаемые максимальные изгибные напряжения SIGMA(FPMAX), МПа - 1932

****************************************************

Расчет геометрии пары Сателлит-БЦК

Коэффициенты смещения Х(1)= 0, X(2)= 0

Делительное межосевое расстояние a, мм: 68.3282

Коэффициент разности смещений X(d)= 0

Угол профиля ALFA(t)= 20.6365

Угол зацепления ALFA(tw)= 20.6365

Межосевое расстояние a(w), мм= 68.3282

Делительные диаметры d, мм:

Шестерни = 33.1288 Колеса = 169.785

Передаточное отношение U= 5.125

Начальные диаметры d(w), мм:

Шестерни = 33.1288 Колеса = 169.785

Коэффициент воспринимаемого смещения Y = 0

Коэффициент уравнительного смещения DELTA(Y) = 0

Диаметры вершин зубьев d(a), мм:

Шестерни: 37.1288 Колеса: 166.585

Диаметры впадин зубьев d(f), мм:

Шестерни: 28.1288 Колеса: 174.785

Ocновной диаметр d(b), мм:

Шестерни: 31.0031 Колеса: 158.891

Угол профиля зуба в точке окружности вершин ALFA(a):

Шестерни: 33.3826 Колеса: 17.4819

Шаг зацепления P(alfa), мм: 5.90165

Осевой шаг P(x), мм: 24.2641

Коэффициенты торцевого перекрытия E(ALFA):

Шестерни: 0.718975 Колеса: -0.804595

Коэффициенты торцевого перекрытия E(ALFA): 1.52357

Коэффициенты осевого перекрытия E(BETTA): 1.52357

Коэффициенты перекрытия E(Y): 2.14177

Основной угол наклона BETTA(B): 14.077

Эквивалентное число зубьев Z(V):

Шестерни: 17.7537 Колеса: 90.9877

Окружная скорость в зацеплении V, м/с: 16.2621

Удельное скольжение:

Шестерни: -0.139456 Колеса: 0.526415

Степень точности изготовления зубчатых колес: 6

****************************************************

КОЭФФИЦИЕНТ НЕРАВНОМЕРНОСТИ РАСПРЕДЕЛЕНИЯ НАГРУЗКИ 1.000

****************************************************

Планетарный ряд №2

ГИСТОГРАММЫ РАСПРЕДЕЛЕНИЕ ВРЕМЕНИ ДВИЖЕНИЯ ПО ПЕРЕДАЧАМ:

0.01 0.02 0.04 0.05 0.07 0.13 0.23 0.4 0.05 0.025

ИСХОДНЫЕ ДАННЫЕ

МОДУЛЬ ЗАЦПЛЕНИЯ - 2.00

ЧИСЛО ЗУБЬЕВ МЦК - 43 САТ(МЦК) - 20 САТ(БЦК) - 0 БЦК - 83

САТЕЛЛИТЫ ОДНОВЕНЦОВЫЕ

УГОЛ НАКЛОНА ЗУБЬЕВ (град.) - 15.00

КОЭФФИЦИЕНТЫ СМЕЩЕНИЯ: МЦК - 0.000 САТ1 - 0.000 САТ2 - 0.000 БЦК - 0.000

ШИРИНА ЗУБЧАТОГО ВЕНЦА (мм) - 20.00

ЧИСЛО САТЕЛЛИТОВ - 3

МАРКА СТАЛИ: МЦК - 20ХНМ САТ1 - 20ХНМ САТ2 - 20ХНМ БЦК - 20ХНМ

СПОСОБ ТЕРМИЧЕСКОЙ ОБРАБОТКИ ПОВЕРХНОСТЕЙ ЗУБЬЕВ: МЦК - 4 САТ1 - 4 САТ2 - 4 БЦК - 4

ТВЕРДОСТЬ ПОВЕРХНОСТЕЙ ЗУБЬЕВ: МЦК - 60 САТ1 - 60 САТ2 - 60 БЦК - 60

ВИД ОБРАБОТКИ ПЕРЕХОДНОЙ ПОВЕРХНОСТИ ЗУБЬЕВ: МЦК - 0 САТ1 - 0 САТ2 - 0 БЦК - 0

Kоэффициент, учитывающий способ получения заготовки: МЦК - 2 САТ1 - 2 САТ2 - 2 БЦК - 2

Номер схемы расположения зубчатых колес относительно опор: 6

Количество передач переднего хода: 8

Количество передач заднего хода: 2

МАКСИМАЛЬНЫЙ МОМЕНТ ДВИГАТЕЛЯ, Нм: 750

Максимальная частота вращения ведущего вала, об/мин: 3000

Коэффициент использования момента двигателя: 0.45

Средняя частота вращения двигателя, об/мин: 1950

Пробег до капитального ремонта, км: 250000

Средняя скорость, км/ч: 25

Коэффициент трансформации момента гидротрансформатора на стоповом режиме: 1.00

Коэффициенты частоты вращения МЦК на передачах:

-1.209 0 1 1.61 1.711 1.61 1 0 1 1.61

Коэффициенты частоты вращения водила на передачах:

0 0.414 0.756 0.965 1 1 1 1 0 0

Коэффициенты момента МЦК на передачах:

0 -0.46 -0.31 -0.26 0 0.2 0.18 0.15 -1 -0.62

Тип движителя: 2

****************************************************

Расчет геометрии пары МЦК-Сателлит

Коэффициенты смещения Х(1)= 0, X(2)= 0

Делительное межосевое расстояние a, мм: 65.2224

Коэффициент суммы смещений - X(СУМ)= 0

Угол профиля ALFA(t)= 20.6469

Угол зацепления ALFA(tw)= 20.6469

Межосевое расстояние a(w), мм= 65.2224

Делительные диаметры d, мм:

Шестерни = 41.411 Колеса = 89.0338

Передаточное отношение U= 2.15

Начальные диаметры d(w), мм:

Шестерни = 41.411 Колеса = 89.0338

Коэффициент воспринимаемого смещения Y = 0

Коэффициент уравнительного смещения DELTA(Y) = 0

Диаметры вершин зубьев d(a), мм:

Шестерни: 45.411 Колеса: 93.0338

Диаметры впадин зубьев d(f), мм:

Шестерни: 36.411 Колеса: 84.0338

Ocновной диаметр d(b), мм:

Шестерни: 38.7513 Колеса: 83.3152

Угол профиля зуба в точке окружности вершин ALFA(a):

Шестерни: 31.4227 Колеса: 26.4224

Шаг зацепления P(alfa), мм: 5.90127

Осевой шаг P(x), мм: 24.2641

Коэффициенты торцевого перекрытия E(ALFA):

Шестерни: 0.745279 Колеса: 0.821805

Коэффициенты торцевого перекрытия E(ALFA): 1.56708

Коэффициенты осевого перекрытия E(BETTA): 1.56708

Коэффициенты перекрытия E(Y): 2.39135

Основной угол наклона BETTA(B): 14.0761

Эквивалентное число зубьев Z(V):

Шестерни: 22.1921 Колеса: 47.713

Окружная скорость в зацеплении V, м/с: 22.5165

Удельное скольжение:

Шестерни: -2.98823 Колеса: 1.28042

Степень точности изготовления зубчатых колес: 6

****************************************************

КОЭФФИЦИЕНТ НЕРАВНОМЕРНОСТИ РАСПРЕДЕЛЕНИЯ НАГРУЗКИ 1.000

****************************************************

Расчет на контактную прочность для ПРЯМОГО действия нагрузки

МЦК-Сателлит

ОПРЕДЕЛЕНИЕ ДОПУСКАЕМЫХ НАПРЯЖЕНИЙ ПРИ РАСЧЕТЕ НА КОНТАКТНУЮ ВЫНОСЛИВОСТЬ

СУММАРНОЕ ЧИСЛО ЦИКЛОВ НАГРУЖЕНИЙ: ШЕСТЕРНИ - 1.20568e+09 КОЛЕСА - 1.68234e+09

РАСЧЕТ ВЕДЕТСЯ ПРИ ПЕРЕМЕННОЙ НАГРУЗКЕ И ПЕРЕМЕННЫХ ОБОРОТАХ

Oкружная сила на делительном диаметре F(TH), H - 505.426

Kоэффициент учитывающий характер циклограммы нагружения, MJU:

Шестерни - 5.8634 Колеса - 8.1815

Эквивалентное число циклов перемены напряжений N(HE):

Шестерни - 7.0361e+08 Колеса - 9.81781e+08

Коэффициенты, учитывающие окружную скорость Z(V):

Шестерни - 1.00771 Колеса - 1.00771

Kоэффициент, учитывающий радиальный размер зубчатого колеса K(XH):

Шестерни - 1 Колеса - 1

Kоэффициент, учитывающий влияние смазки K(L) - 1

Kоэффициент, учитывающий шероховатость сопряженных поверхностей зубьев Z(R) - 1

Коэффициент долговечности Z(N):

Шестерни - 0.915361 Колеса - 0.90024

Предел контактной выносливости поверхностей зубьев SIGMA(HLIM), MПa:

Шестерни - 1263.2 Колеса - 1242.33

Допускаемые контактные напряжения SIGMA(HP), МПа:

Шестерни - 1060.79 Колеса - 1043.26

Допускаемые контактные напряжения передачи, МПа - 1022.15

РАСЧЕТ НА КОНТАКТНУЮ ВЫНОСЛИВОСТЬ

Коэффициент, учитывающий форму сопряженных поверхностей зубьев, Z(H) - 2.42473

Коэффициент, учитывающий суммарную длину контактных линий, Z(EPSILON) - 0.81762

Коэффициент, учитывающий внешнюю динамическую нагрузку K(A) - 1.75

Коэффициент, учитывающий распределение нагрузки между зубьями, K(HALFA) - 1.01479

Коэффициент, учитывающий динамическую нагрузку, возникающую в зацеплении, K(HV) - 1.15746

Коэффициент, учитывающий распределение нагрузки по ширине венца, K(HBETTA) -1.03578

Коэффициент нагрузки K(H) - 2.12905

Контактные напряжения без учета дополнительных нагрузок SIGMA(HO), МПа - 356.173

Действующие в полюсе зацепления контактные напряжения SIGMA(H), МПа - 519.702

РАСЧЕТ НА КОНТАКТНУЮ ПРОЧНОСТЬ ПРИ ДЕЙСТВИИ МАКСИМАЛЬНОЙ НАГРУЗКИ

Коэффициент, учитывающий динамическую нагрузку, возникающую в зацеплении при max моменте, K(HV) - 1.07086

Коэффициент нагрузки K(HMAX) - 1.96975

Максимальный момент М(max), Нм - 50

Средний момент М(1), Нм - 22.5

Контактные напряжения при действии максимальной нагрузки SIGMA(HMAX), МПа - 745.18

Допускаемые контактные напряжения при действии максимальной нагрузки SIGMA(HPMAX):

Шестерни - 2640 Колеса - 2640

****************************************************

Расчет на контактную прочность для реверсивной нагрузки

МЦК-Сателлит

ОПРЕДЕЛЕНИЕ ДОПУСКАЕМЫХ НАПРЯЖЕНИЙ ПРИ РАСЧЕТЕ НА КОНТАКТНУЮ ВЫНОСЛИВОСТЬ

СУММАРНОЕ ЧИСЛО ЦИКЛОВ НАГРУЖЕНИЙ: ШЕСТЕРНИ - 3.53528e+08 КОЛЕСА - 4.93295e+08

РАСЧЕТ ВЕДЕТСЯ ПРИ ПЕРЕМЕННОЙ НАГРУЗКЕ И ПЕРЕМЕННЫХ ОБОРОТАХ

Oкружная сила на делительном диаметре F(TH), H - 2527.13

Kоэффициент учитывающий характер циклограммы нагружения, MJU:

Шестерни - 1.2949 Колеса - 1.8069

Эквивалентное число циклов перемены напряжений N(HE):

Шестерни - 1.55393e+08 Колеса - 2.16828e+08

Коэффициенты, учитывающие окружную скорость Z(V):

Шестерни - 1.03293 Колеса - 1.03293

Kоэффициент, учитывающий радиальный размер зубчатого колеса K(XH):

Шестерни - 1 Колеса - 1

Kоэффициент, учитывающий влияние смазки K(L) - 1

Kоэффициент, учитывающий шероховатость сопряженных поверхностей зубьев Z(R) - 1

Коэффициент долговечности Z(N):

Шестерни - 0.98716 Колеса - 0.970853

Предел контактной выносливости поверхностей зубьев SIGMA(HLIM), MПa:

Шестерни - 1362.28 Колеса - 1339.78

Допускаемые контактные напряжения SIGMA(HP), МПа:

Шестерни - 1172.62 Колеса - 1153.25

Допускаемые контактные напряжения передачи, МПа - 1129.9

РАСЧЕТ НА КОНТАКТНУЮ ВЫНОСЛИВОСТЬ

Коэффициент, учитывающий форму сопряженных поверхностей зубьев, Z(H) - 2.42473

Коэффициент, учитывающий суммарную длину контактных линий, Z(EPSILON) - 0.81762

Коэффициент, учитывающий внешнюю динамическую нагрузку K(A) - 1.75

Коэффициент, учитывающий распределение нагрузки между зубьями, K(HALFA) - 1.02424

Коэффициент, учитывающий динамическую нагрузку, возникающую в зацеплении, K(HV) - 1.05163

Коэффициент, учитывающий распределение нагрузки по ширине венца, K(HBETTA) -1.03578

Коэффициент нагрузки K(H) - 1.9524

Контактные напряжения без учета дополнительных нагрузок SIGMA(HO), МПа - 796.427

Действующие в полюсе зацепления контактные напряжения SIGMA(H), МПа - 1112.84

РАСЧЕТ НА КОНТАКТНУЮ ПРОЧНОСТЬ ПРИ ДЕЙСТВИИ МАКСИМАЛЬНОЙ НАГРУЗКИ

Коэффициент, учитывающий динамическую нагрузку, возникающую в зацеплении при max моменте, K(HV) - 1.02323

Коэффициент нагрузки K(HMAX) - 1.89969

Максимальный момент М(max), Нм - 250

Средний момент М(1), Нм - 112.5

Контактные напряжения при действии максимальной нагрузки SIGMA(HMAX), МПа - 1636.37

Допускаемые контактные напряжения при действии максимальной нагрузки SIGMA(HPMAX):

Шестерни - 2640 Колеса - 2640

****************************************************

РАСЧЕТ НА ИЗГИБНУЮ ПРОЧНОСТЬ ПАРЫ МЦК-САТЕЛЛИТ

Расчет зубьев МЦК

ОПРЕДЕЛЕНИЕ ДОПУСКАЕМЫХ НАПРЯЖЕНИЙ ПРИ РАСЧЕТЕ НА ИЗГИБНУЮ ВЫНОСЛИВОСТЬ

ПРЯМОЕ ДЕЙСТВИЕ НАГРУЗКИ

Oкружная сила на делительном диаметре для прямого действия нагрузки F(TF), H - 505.426

Kоэффициент, учитывающий характер циклограммы для прямого действия нагрузки MJU(F1) - 69.5858

Эквивалентное число циклов перемены напряжений для прямого действия нагрузки N(FE) - 2.78343e+08

Расчетный момент, M(H) - 10.4651

Kоэффициент, учитывающий характер циклограммы для прямого действия нагрузки MJU(F1) - 3428.75

Эквивалентное число циклов перемены напряжений для прямого действия нагрузки N(FE) - 1.3715e+10

Расчетный момент, M(H) - 10.4651

Коэффициент долговечности K(FL) - 1.000

РЕВЕРСИВНОЕ ДЕЙСТВИЕ НАГРУЗКИ

НАГРУЗКА ПОСТОЯННА

Окружная сила на делительном диаметре для реверсивного действия нагрузки F(TF), H - 2527.13

Kоэффициент, учитывающий характер циклограммы, для реверсивного действия нагрузки MJU(F1) - 89.2526

Эквивалентное число циклов перемены напряжений для реверсивного действия нагрузки N(FE) - 3.5701e+08

Расчетный момент для реверсивного действия нагрузки, M(H) - 52.3256

Коэффициент долговечности для реверсивного действия нагрузки K(FL) - 1

Kоэффициент, учитывающий влияние двухстороннего приложения нагрузки, K(FC) - 0.95

Kоэффициент, учитывающий влияние деформационного упрочнeния или электрохимической обработки переходной поверхности, K(FG) - 0.75

Kоэффициент, учитывающий влияние шлифования переходной - 1

Kоэффициент, учитывающий влияние шлифования переходной поверхности зуба шестерни, K(FD) - 1

Предел изломной выносливости, SIGMA(FLIM0), МПа - 950

Предел выносливости зубьев колес при изгибе, SIGMA(FLIM), МПа - 712.5

Kоэффициент безопасности, S(F) - 1.7825

Kоэффициент, учитывающий градиент напряжений и чувствительность материала к концентрации напряжений, Y(S) - 1.03022

Kоэффициент, учитывающий шероховатость переходной поверхности, Y(R) - 1

Kоэффициент, учитывающий размеры зубчатого колеса, K(XF) - 1

Допускаемое изгибное напряжение при расчете на выносливость, МПа - 411.8

РАСЧЕТ НА ИЗГИБНУЮ ВЫНОСЛИВОСТЬ

Коэффициент, учитывающий динамическую нагрузку, возникающую в зацеплении, K(FV) - 1.052

Коэффициент, учитывающий распределение нагрузки по ширине венца, K(FBETTA) - 1.068

Коэффициент, учитывающий распределение нагрузки между зубьями, K(FALFA) - 1.024

Коэффициент внешней динамической нагрузки KA - 1.750

Коэффициент нагрузки, K(F) - 2.013

Коэффициент, учитывающий наклон зубьев, Y(BETTA) - 0.912

Коэффициент, учитывающий перекрытие зубьев, Y(E) - 0.638

Коэффициент, учитывающий форму зуба, Y(FS) - 3.747

Действующие в полюсе зацепления изгибные напряжения, SIGMA(F), МПа - 277.238

РАСЧЕТ НА ИЗГИБНУЮ ПРОЧНОСТЬ ПРИ ДЕЙСТВИИ МАКСИМАЛЬНОЙ НАГРУЗКИ

Максимальная расчетная нагрузка F(Tmax), Н - 5615.85

Pасчетная нагрузка F(T), Н - 2527.13

Действующие максимальные изгибные напряжения SIGMA(FMAX), МПа - 352.048

Допускаемые максимальные изгибные напряжения SIGMA(FPMAX), МПа - 1932

Расчет зубьев сателлита

ОПРЕДЕЛЕНИЕ ДОПУСКАЕМЫХ НАПРЯЖЕНИЙ ПРИ РАСЧЕТЕ НА ИЗГИБНУЮ ВЫНОСЛИВОСТЬ

ПРЯМОЕ ДЕЙСТВИЕ НАГРУЗКИ

Oкружная сила на делительном диаметре для прямого действия нагрузки F(TF), H - 505.426

Kоэффициент, учитывающий характер циклограммы для прямого действия нагрузки MJU(F1) - 0

Эквивалентное число циклов перемены напряжений для прямого действия нагрузки N(FE) - 0

Расчетный момент, M(H) - 22.5

Kоэффициент, учитывающий характер циклограммы для прямого действия нагрузки MJU(F1) - 0

Эквивалентное число циклов перемены напряжений для прямого действия нагрузки N(FE) - 0

Расчетный момент, M(H) - 22.5

Коэффициент долговечности K(FL) - 1.630

РЕВЕРСИВНОЕ ДЕЙСТВИЕ НАГРУЗКИ

НАГРУЗКА ПОСТОЯННА

Окружная сила на делительном диаметре для реверсивного действия нагрузки F(TF), H - 2527.13

Kоэффициент, учитывающий характер циклограммы, для реверсивного действия нагрузки MJU(F1) - 0

Эквивалентное число циклов перемены напряжений для реверсивного действия нагрузки N(FE) - 0

Расчетный момент для реверсивного действия нагрузки, M(H) - 112.5

Коэффициент долговечности для реверсивного действия нагрузки K(FL) - 1.63

Kоэффициент, учитывающий влияние двухстороннего приложения нагрузки, K(FC) - 0.95

Kоэффициент, учитывающий влияние деформационного упрочнeния или электрохимической обработки переходной поверхности, K(FG) - 0.75

Kоэффициент, учитывающий влияние шлифования переходной - 1.63

Kоэффициент, учитывающий влияние шлифования переходной поверхности зуба шестерни, K(FD) - 1

Предел изломной выносливости, SIGMA(FLIM0), МПа - 950

Предел выносливости зубьев колес при изгибе, SIGMA(FLIM), МПа - 1103.31

Kоэффициент безопасности, S(F) - 1.7825

Kоэффициент, учитывающий градиент напряжений и чувствительность материала к концентрации напряжений, Y(S) - 1.03022

Kоэффициент, учитывающий шероховатость переходной поверхности, Y(R) - 1

Kоэффициент, учитывающий размеры зубчатого колеса, K(XF) - 1

Допускаемое изгибное напряжение при расчете на выносливость, МПа - 637.673

РАСЧЕТ НА ИЗГИБНУЮ ВЫНОСЛИВОСТЬ

Коэффициент, учитывающий динамическую нагрузку, возникающую в зацеплении, K(FV) - 1.052

Коэффициент, учитывающий распределение нагрузки по ширине венца, K(FBETTA) - 1.068

Коэффициент, учитывающий распределение нагрузки между зубьями, K(FALFA) - 1.024

Коэффициент внешней динамической нагрузки KA - 1.750

Коэффициент нагрузки, K(F) - 2.013

Коэффициент, учитывающий наклон зубьев, Y(BETTA) - 0.912

Коэффициент, учитывающий перекрытие зубьев, Y(E) - 0.638

Коэффициент, учитывающий форму зуба, Y(FS) - 4.065

Действующие в полюсе зацепления изгибные напряжения, SIGMA(F), МПа - 300.780

РАСЧЕТ НА ИЗГИБНУЮ ПРОЧНОСТЬ ПРИ ДЕЙСТВИИ МАКСИМАЛЬНОЙ НАГРУЗКИ

Максимальная расчетная нагрузка F(Tmax), Н - 5615.85

Pасчетная нагрузка F(T), Н - 2527.13

Действующие максимальные изгибные напряжения SIGMA(FMAX), МПа - 381.942

Допускаемые максимальные изгибные напряжения SIGMA(FPMAX), МПа - 1932

****************************************************

Расчет геометрии пары Сателлит-БЦК

Коэффициенты смещения Х(1)= 0, X(2)= 0

Делительное межосевое расстояние a, мм: 65.2224

Коэффициент разности смещений X(d)= 0

Угол профиля ALFA(t)= 20.6365

Угол зацепления ALFA(tw)= 20.6365

Межосевое расстояние a(w), мм= 65.2224

Делительные диаметры d, мм:

Шестерни = 41.411 Колеса = 171.856

Передаточное отношение U= 4.15

Начальные диаметры d(w), мм:

Шестерни = 41.411 Колеса = 171.856

Коэффициент воспринимаемого смещения Y = 0

Коэффициент уравнительного смещения DELTA(Y) = 0

Диаметры вершин зубьев d(a), мм:

Шестерни: 45.411 Колеса: 168.656

Диаметры впадин зубьев d(f), мм:

Шестерни: 36.411 Колеса: 176.856

Ocновной диаметр d(b), мм:

Шестерни: 38.7539 Колеса: 160.829

Угол профиля зуба в точке окружности вершин ALFA(a):

Шестерни: 31.4163 Колеса: 17.5239

Шаг зацепления P(alfa), мм: 5.90165

Осевой шаг P(x), мм: 24.2641

Коэффициенты торцевого перекрытия E(ALFA):

Шестерни: 0.74545 Колеса: -0.80375

Коэффициенты торцевого перекрытия E(ALFA): 1.5492

Коэффициенты осевого перекрытия E(BETTA): 1.5492

Коэффициенты перекрытия E(Y): 2.37346

Основной угол наклона BETTA(B): 14.077

Эквивалентное число зубьев Z(V):

Шестерни: 22.1921 Колеса: 92.0973

Окружная скорость в зацеплении V, м/с: 22.5165

Удельное скольжение:

Шестерни: -0.14213 Колеса: 0.410496

Степень точности изготовления зубчатых колес: 6

****************************************************

КОЭФФИЦИЕНТ НЕРАВНОМЕРНОСТИ РАСПРЕДЕЛЕНИЯ НАГРУЗКИ 1.000

****************************************************

Планетарный ряд №3

ГИСТОГРАММЫ РАСПРЕДЕЛЕНИЕ ВРЕМЕНИ ДВИЖЕНИЯ ПО ПЕРЕДАЧАМ:

0.01 0.02 0.04 0.05 0.07 0.13 0.23 0.4 0.05 0.025

ИСХОДНЫЕ ДАННЫЕ

МОДУЛЬ ЗАЦПЛЕНИЯ - 2.00

ЧИСЛО ЗУБЬЕВ МЦК - 49 САТ(МЦК) - 17 САТ(БЦК) - 0 БЦК - 83

САТЕЛЛИТЫ ОДНОВЕНЦОВЫЕ

УГОЛ НАКЛОНА ЗУБЬЕВ (град.) - 15.00

КОЭФФИЦИЕНТЫ СМЕЩЕНИЯ: МЦК - 0.000 САТ1 - 0.000 САТ2 - 0.000 БЦК - 0.000

ШИРИНА ЗУБЧАТОГО ВЕНЦА (мм) - 15.00

ЧИСЛО САТЕЛЛИТОВ - 3

МАРКА СТАЛИ: МЦК - 20ХНМ САТ1 - 20ХНМ САТ2 - 20ХНМ БЦК - 20ХНМ

СПОСОБ ТЕРМИЧЕСКОЙ ОБРАБОТКИ ПОВЕРХНОСТЕЙ ЗУБЬЕВ: МЦК - 4 САТ1 - 4 САТ2 - 4 БЦК - 4

ТВЕРДОСТЬ ПОВЕРХНОСТЕЙ ЗУБЬЕВ: МЦК - 60 САТ1 - 60 САТ2 - 60 БЦК - 60

ВИД ОБРАБОТКИ ПЕРЕХОДНОЙ ПОВЕРХНОСТИ ЗУБЬЕВ: МЦК - 0 САТ1 - 0 САТ2 - 0 БЦК - 0

Kоэффициент, учитывающий способ получения заготовки: МЦК - 2 САТ1 - 2 САТ2 - 2 БЦК - 2

Номер схемы расположения зубчатых колес относительно опор: 6

Количество передач переднего хода: 8

Количество передач заднего хода: 2

МАКСИМАЛЬНЫЙ МОМЕНТ ДВИГАТЕЛЯ, Нм: 750

Максимальная частота вращения ведущего вала, об/мин: 3000

Коэффициент использования момента двигателя: 0.45

Средняя частота вращения двигателя, об/мин: 1950

Пробег до капитального ремонта, км: 250000

Средняя скорость, км/ч: 25

Коэффициент трансформации момента гидротрансформатора на стоповом режиме: 1.00

Коэффициенты частоты вращения МЦК на передачах:

0 0 0 0 0 0.143 1 2.406 -3.106 -3.964

Коэффициенты частоты вращения водила на передачах:

0.63 0.63 0.63 0.63 0.63 0.682 1 1.521 -0.521 -0.838

Коэффициенты момента МЦК на передачах:

-0.59 -0.59 -0.4 -0.34 -0.15 0 0 0 0 0

Тип движителя: 2

****************************************************

Расчет геометрии пары МЦК-Сателлит

Коэффициенты смещения Х(1)= 0, X(2)= 0

Делительное межосевое расстояние a, мм: 68.3282

Коэффициент суммы смещений - X(СУМ)= 0

Угол профиля ALFA(t)= 20.6469

Угол зацепления ALFA(tw)= 20.6469

Межосевое расстояние a(w), мм= 68.3282

Делительные диаметры d, мм:

Шестерни = 35.1994 Колеса = 101.457

Передаточное отношение U= 2.88235

Начальные диаметры d(w), мм:

Шестерни = 35.1994 Колеса = 101.457

Коэффициент воспринимаемого смещения Y = 0

Коэффициент уравнительного смещения DELTA(Y) = 0

Диаметры вершин зубьев d(a), мм:

Шестерни: 39.1994 Колеса: 105.457

Диаметры впадин зубьев d(f), мм:

Шестерни: 30.1994 Колеса: 96.4571

Ocновной диаметр d(b), мм:

Шестерни: 32.9386 Колеса: 94.9406

Угол профиля зуба в точке окружности вершин ALFA(a):

Шестерни: 32.83 Колеса: 25.8055

Шаг зацепления P(alfa), мм: 5.90127

Осевой шаг P(x), мм: 24.2641

Коэффициенты торцевого перекрытия E(ALFA):

Шестерни: 0.726158 Колеса: 0.832318

Коэффициенты торцевого перекрытия E(ALFA): 1.55848

Коэффициенты осевого перекрытия E(BETTA): 1.55848

Коэффициенты перекрытия E(Y): 2.17667

Основной угол наклона BETTA(B): 14.0761

Эквивалентное число зубьев Z(V):

Шестерни: 18.8633 Колеса: 54.3707

Окружная скорость в зацеплении V, м/с: 10.0402

Удельное скольжение:

Шестерни: -1.04429 Колеса: 1.27426

Степень точности изготовления зубчатых колес: 7

****************************************************

КОЭФФИЦИЕНТ НЕРАВНОМЕРНОСТИ РАСПРЕДЕЛЕНИЯ НАГРУЗКИ 1.230

****************************************************

Расчет на контактную прочность для ПРЯМОГО действия нагрузки

МЦК-Сателлит

ОПРЕДЕЛЕНИЕ ДОПУСКАЕМЫХ НАПРЯЖЕНИЙ ПРИ РАСЧЕТЕ НА КОНТАКТНУЮ ВЫНОСЛИВОСТЬ

****************************************************

Расчет на контактную прочность для реверсивной нагрузки

МЦК-Сателлит

ОПРЕДЕЛЕНИЕ ДОПУСКАЕМЫХ НАПРЯЖЕНИЙ ПРИ РАСЧЕТЕ НА КОНТАКТНУЮ ВЫНОСЛИВОСТЬ

СУММАРНОЕ ЧИСЛО ЦИКЛОВ НАГРУЖЕНИЙ: ШЕСТЕРНИ - 4.03671e+08 КОЛЕСА - 4.20147e+08

РАСЧЕТ ВЕДЕТСЯ ПРИ ПЕРЕМЕННОЙ НАГРУЗКЕ И ПОСТОЯННЫХ ОБОРОТАХ

Oкружная сила на делительном диаметре F(TH), H - 1308.44

Kоэффициент учитывающий характер циклограммы нагружения, MJU:

Шестерни - 0.0004 Колеса - 0.9800

Эквивалентное число циклов перемены напряжений N(HE):

Шестерни - 50022.3 Колеса - 1.17605e+08

Коэффициенты, учитывающие окружную скорость Z(V):

Шестерни - 1.01596 Колеса - 1.01596

Kоэффициент, учитывающий радиальный размер зубчатого колеса K(XH):

Шестерни - 1 Колеса - 1

Kоэффициент, учитывающий влияние смазки K(L) - 1

Kоэффициент, учитывающий шероховатость сопряженных поверхностей зубьев Z(R) - 1

Коэффициент долговечности Z(N):

Шестерни - 1.8 Колеса - 1.00337

Предел контактной выносливости поверхностей зубьев SIGMA(HLIM), MПa:

Шестерни - 2484 Колеса - 1384.64

Допускаемые контактные напряжения SIGMA(HP), МПа:

Шестерни - 2103.03 Колеса - 1172.28

Допускаемые контактные напряжения передачи, МПа - 1255.44

РАСЧЕТ НА КОНТАКТНУЮ ВЫНОСЛИВОСТЬ

Коэффициент, учитывающий форму сопряженных поверхностей зубьев, Z(H) - 2.42473

Коэффициент, учитывающий суммарную длину контактных линий, Z(EPSILON) - 0.841067

Коэффициент, учитывающий внешнюю динамическую нагрузку K(A) - 1.75

Коэффициент, учитывающий распределение нагрузки между зубьями, K(HALFA) - 1.05263

Коэффициент, учитывающий динамическую нагрузку, возникающую в зацеплении, K(HV) - 1.0587

Коэффициент, учитывающий распределение нагрузки по ширине венца, K(HBETTA) -1.02771

Коэффициент нагрузки K(H) - 2.00428

Контактные напряжения без учета дополнительных нагрузок SIGMA(HO), МПа - 707.922

Действующие в полюсе зацепления контактные напряжения SIGMA(H), МПа - 1002.22

РАСЧЕТ НА КОНТАКТНУЮ ПРОЧНОСТЬ ПРИ ДЕЙСТВИИ МАКСИМАЛЬНОЙ НАГРУЗКИ

Коэффициент, учитывающий динамическую нагрузку, возникающую в зацеплении при max моменте, K(HV) - 1.02641

Коэффициент нагрузки K(HMAX) - 1.94316

Максимальный момент М(max), Нм - 147.5

Средний момент М(1), Нм - 66.375

Контактные напряжения при действии максимальной нагрузки SIGMA(HMAX), МПа - 1471.07

Допускаемые контактные напряжения при действии максимальной нагрузки SIGMA(HPMAX):

Шестерни - 2640 Колеса - 2640

****************************************************

РАСЧЕТ НА ИЗГИБНУЮ ПРОЧНОСТЬ ПАРЫ МЦК-САТЕЛЛИТ

Расчет зубьев МЦК

ОПРЕДЕЛЕНИЕ ДОПУСКАЕМЫХ НАПРЯЖЕНИЙ ПРИ РАСЧЕТЕ НА ИЗГИБНУЮ ВЫНОСЛИВОСТЬ

ПРЯМОЕ ДЕЙСТВИЕ НАГРУЗКИ

РЕВЕРСИВНОЕ ДЕЙСТВИЕ НАГРУЗКИ

НАГРУЗКА ПОСТОЯННА

Окружная сила на делительном диаметре для реверсивного действия нагрузки F(TF), H - 1308.44

Kоэффициент, учитывающий характер циклограммы, для реверсивного действия нагрузки MJU(F1) - 17.7085

Эквивалентное число циклов перемены напряжений для реверсивного действия нагрузки N(FE) - 7.08341e+07

Расчетный момент для реверсивного действия нагрузки, M(H) - 23.0281

Коэффициент долговечности для реверсивного действия нагрузки K(FL) - 1

Kоэффициент, учитывающий влияние двухстороннего приложения нагрузки, K(FC) - 1

Kоэффициент, учитывающий влияние деформационного упрочнeния или электрохимической обработки переходной поверхности, K(FG) - 0.75

Kоэффициент, учитывающий влияние шлифования переходной - 1

Kоэффициент, учитывающий влияние шлифования переходной поверхности зуба шестерни, K(FD) - 1

Предел изломной выносливости, SIGMA(FLIM0), МПа - 950

Предел выносливости зубьев колес при изгибе, SIGMA(FLIM), МПа - 712.5

Kоэффициент безопасности, S(F) - 1.7825

Kоэффициент, учитывающий градиент напряжений и чувствительность материала к концентрации напряжений, Y(S) - 1.03022

Kоэффициент, учитывающий шероховатость переходной поверхности, Y(R) - 1

Kоэффициент, учитывающий размеры зубчатого колеса, K(XF) - 1

Допускаемое изгибное напряжение при расчете на выносливость, МПа - 411.8

РАСЧЕТ НА ИЗГИБНУЮ ВЫНОСЛИВОСТЬ

Коэффициент, учитывающий динамическую нагрузку, возникающую в зацеплении, K(FV) - 1.059

Коэффициент, учитывающий распределение нагрузки по ширине венца, K(FBETTA) - 1.048

Коэффициент, учитывающий распределение нагрузки между зубьями, K(FALFA) - 1.053

Коэффициент внешней динамической нагрузки KA - 1.750

Коэффициент нагрузки, K(F) - 2.044

Коэффициент, учитывающий наклон зубьев, Y(BETTA) - 0.934

Коэффициент, учитывающий перекрытие зубьев, Y(E) - 0.642

Коэффициент, учитывающий форму зуба, Y(FS) - 3.713

Действующие в полюсе зацепления изгибные напряжения, SIGMA(F), МПа - 198.325

РАСЧЕТ НА ИЗГИБНУЮ ПРОЧНОСТЬ ПРИ ДЕЙСТВИИ МАКСИМАЛЬНОЙ НАГРУЗКИ

Максимальная расчетная нагрузка F(Tmax), Н - 2907.63

Pасчетная нагрузка F(T), Н - 1308.44

Действующие максимальные изгибные напряжения SIGMA(FMAX), МПа - 251.841

Допускаемые максимальные изгибные напряжения SIGMA(FPMAX), МПа - 1932

Расчет зубьев сателлита

ОПРЕДЕЛЕНИЕ ДОПУСКАЕМЫХ НАПРЯЖЕНИЙ ПРИ РАСЧЕТЕ НА ИЗГИБНУЮ ВЫНОСЛИВОСТЬ

ПРЯМОЕ ДЕЙСТВИЕ НАГРУЗКИ

РЕВЕРСИВНОЕ ДЕЙСТВИЕ НАГРУЗКИ

НАГРУЗКА ПОСТОЯННА

Окружная сила на делительном диаметре для реверсивного действия нагрузки F(TF), H - 1308.44

Kоэффициент, учитывающий характер циклограммы, для реверсивного действия нагрузки MJU(F1) - 0

Эквивалентное число циклов перемены напряжений для реверсивного действия нагрузки N(FE) - 0

Расчетный момент для реверсивного действия нагрузки, M(H) - 66.375

Коэффициент долговечности для реверсивного действия нагрузки K(FL) - 1.63

Kоэффициент, учитывающий влияние двухстороннего приложения нагрузки, K(FC) - 1

Kоэффициент, учитывающий влияние деформационного упрочнeния или электрохимической обработки переходной поверхности, K(FG) - 0.75

Kоэффициент, учитывающий влияние шлифования переходной - 1.63

Kоэффициент, учитывающий влияние шлифования переходной поверхности зуба шестерни, K(FD) - 1

Предел изломной выносливости, SIGMA(FLIM0), МПа - 950

Предел выносливости зубьев колес при изгибе, SIGMA(FLIM), МПа - 1161.38

Kоэффициент безопасности, S(F) - 1.7825

Kоэффициент, учитывающий градиент напряжений и чувствительность материала к концентрации напряжений, Y(S) - 1.03022

Kоэффициент, учитывающий шероховатость переходной поверхности, Y(R) - 1

Kоэффициент, учитывающий размеры зубчатого колеса, K(XF) - 1

Допускаемое изгибное напряжение при расчете на выносливость, МПа - 671.234

РАСЧЕТ НА ИЗГИБНУЮ ВЫНОСЛИВОСТЬ

Коэффициент, учитывающий динамическую нагрузку, возникающую в зацеплении, K(FV) - 1.059

Коэффициент, учитывающий распределение нагрузки по ширине венца, K(FBETTA) - 1.048

Коэффициент, учитывающий распределение нагрузки между зубьями, K(FALFA) - 1.053

Коэффициент внешней динамической нагрузки KA - 1.750

Коэффициент нагрузки, K(F) - 2.044

Коэффициент, учитывающий наклон зубьев, Y(BETTA) - 0.934

Коэффициент, учитывающий перекрытие зубьев, Y(E) - 0.642

Коэффициент, учитывающий форму зуба, Y(FS) - 4.170

Действующие в полюсе зацепления изгибные напряжения, SIGMA(F), МПа - 222.736

РАСЧЕТ НА ИЗГИБНУЮ ПРОЧНОСТЬ ПРИ ДЕЙСТВИИ МАКСИМАЛЬНОЙ НАГРУЗКИ

Максимальная расчетная нагрузка F(Tmax), Н - 2907.63

Pасчетная нагрузка F(T), Н - 1308.44

Действующие максимальные изгибные напряжения SIGMA(FMAX), МПа - 282.84

Допускаемые максимальные изгибные напряжения SIGMA(FPMAX), МПа - 1932

****************************************************

Расчет геометрии пары Сателлит-БЦК

Коэффициенты смещения Х(1)= 0, X(2)= 0

Делительное межосевое расстояние a, мм: 68.3282

Коэффициент разности смещений X(d)= 0

Угол профиля ALFA(t)= 20.6365

Угол зацепления ALFA(tw)= 20.6365

Межосевое расстояние a(w), мм= 68.3282

Делительные диаметры d, мм:

Шестерни = 35.1994 Колеса = 171.856

Передаточное отношение U= 4.88235

Начальные диаметры d(w), мм:

Шестерни = 35.1994 Колеса = 171.856

Коэффициент воспринимаемого смещения Y = 0

Коэффициент уравнительного смещения DELTA(Y) = 0

Диаметры вершин зубьев d(a), мм:

Шестерни: 39.1994 Колеса: 168.656

Диаметры впадин зубьев d(f), мм:

Шестерни: 30.1994 Колеса: 176.856

Ocновной диаметр d(b), мм:

Шестерни: 32.9408 Колеса: 160.829

Угол профиля зуба в точке окружности вершин ALFA(a):

Шестерни: 32.8239 Колеса: 17.5239

Шаг зацепления P(alfa), мм: 5.90165

Осевой шаг P(x), мм: 24.2641

Коэффициенты торцевого перекрытия E(ALFA):

Шестерни: 0.726313 Колеса: -0.80375

Коэффициенты торцевого перекрытия E(ALFA): 1.53006

Коэффициенты осевого перекрытия E(BETTA): 1.53006

Коэффициенты перекрытия E(Y): 2.14826

Основной угол наклона BETTA(B): 14.077

Эквивалентное число зубьев Z(V):

Шестерни: 18.8633 Колеса: 92.0973

Окружная скорость в зацеплении V, м/с: 10.0402

Удельное скольжение:

Шестерни: -0.140004 Колеса: 0.4946

Степень точности изготовления зубчатых колес: 7

****************************************************

КОЭФФИЦИЕНТ НЕРАВНОМЕРНОСТИ РАСПРЕДЕЛЕНИЯ НАГРУЗКИ 1.230

****************************************************

Планетарный ряд №4

ГИСТОГРАММЫ РАСПРЕДЕЛЕНИЕ ВРЕМЕНИ ДВИЖЕНИЯ ПО ПЕРЕДАЧАМ:

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

ИСХОДНЫЕ ДАННЫЕ

МОДУЛЬ ЗАЦПЛЕНИЯ - 2.00

ЧИСЛО ЗУБЬЕВ МЦК - 44 САТ(МЦК) - 20 САТ(БЦК) - 0 БЦК - 84

САТЕЛЛИТЫ ОДНОВЕНЦОВЫЕ

УГОЛ НАКЛОНА ЗУБЬЕВ (град.) - 15.00

КОЭФФИЦИЕНТЫ СМЕЩЕНИЯ: МЦК - 0.000 САТ1 - 0.000 САТ2 - 0.000 БЦК - 0.000

ШИРИНА ЗУБЧАТОГО ВЕНЦА (мм) - 30.00

ЧИСЛО САТЕЛЛИТОВ - 4

МАРКА СТАЛИ: МЦК - 20ХНМ САТ1 - 20ХНМ САТ2 - 20ХНМ БЦК - 20ХНМ

СПОСОБ ТЕРМИЧЕСКОЙ ОБРАБОТКИ ПОВЕРХНОСТЕЙ ЗУБЬЕВ: МЦК - 4 САТ1 - 4 САТ2 - 4 БЦК - 4

ТВЕРДОСТЬ ПОВЕРХНОСТЕЙ ЗУБЬЕВ: МЦК - 60 САТ1 - 60 САТ2 - 60 БЦК - 60

ВИД ОБРАБОТКИ ПЕРЕХОДНОЙ ПОВЕРХНОСТИ ЗУБЬЕВ: МЦК - 0 САТ1 - 0 САТ2 - 0 БЦК - 0

Kоэффициент, учитывающий способ получения заготовки: МЦК - 2 САТ1 - 2 САТ2 - 2 БЦК - 2

Номер схемы расположения зубчатых колес относительно опор: 6

Количество передач переднего хода: 8

Количество передач заднего хода: 2

МАКСИМАЛЬНЫЙ МОМЕНТ ДВИГАТЕЛЯ, Нм: 750

Максимальная частота вращения ведущего вала, об/мин: 3000

Коэффициент использования момента двигателя: 0.45

Средняя частота вращения двигателя, об/мин: 1950

Пробег до капитального ремонта, км: 250000

Средняя скорость, км/ч: 25

Коэффициент трансформации момента гидротрансформатора на стоповом режиме: 1.00

Коэффициенты частоты вращения МЦК на передачах:

0.63 0.63 0.63 0.63 0.63 0.682 1 1.521 -0.521 -0.838

Коэффициенты частоты вращения водила на передачах:

0.217 0.488 0.713 0.85 0.872 0.89 1 1.18 -0.18 -0.289

Коэффициенты момента МЦК на передачах:

-1.59 -0.71 -0.48 -0.41 -0.4 -0.39 -0.34 -0.29 1.92 1.19

Тип движителя: 2

****************************************************

Расчет геометрии пары МЦК-Сателлит

Коэффициенты смещения Х(1)= 0, X(2)= 0

Делительное межосевое расстояние a, мм: 66.2577

Коэффициент суммы смещений - X(СУМ)= 0

Угол профиля ALFA(t)= 20.6469

Угол зацепления ALFA(tw)= 20.6469

Межосевое расстояние a(w), мм= 66.2577

Делительные диаметры d, мм:

Шестерни = 41.411 Колеса = 91.1043

Передаточное отношение U= 2.2

Начальные диаметры d(w), мм:

Шестерни = 41.411 Колеса = 91.1043

Коэффициент воспринимаемого смещения Y = 0

Коэффициент уравнительного смещения DELTA(Y) = 0

Диаметры вершин зубьев d(a), мм:

Шестерни: 45.411 Колеса: 95.1043

Диаметры впадин зубьев d(f), мм:

Шестерни: 36.411 Колеса: 86.1043

Ocновной диаметр d(b), мм:

Шестерни: 38.7513 Колеса: 85.2528

Угол профиля зуба в точке окружности вершин ALFA(a):

Шестерни: 31.4227 Колеса: 26.3094

Шаг зацепления P(alfa), мм: 5.90127

Осевой шаг P(x), мм: 24.2641

Коэффициенты торцевого перекрытия E(ALFA):

Шестерни: 0.745279 Колеса: 0.823711

Коэффициенты торцевого перекрытия E(ALFA): 1.56899

Коэффициенты осевого перекрытия E(BETTA): 1.56899

Коэффициенты перекрытия E(Y): 2.80539

Основной угол наклона BETTA(B): 14.0761

Эквивалентное число зубьев Z(V):

Шестерни: 22.1921 Колеса: 48.8226

Окружная скорость в зацеплении V, м/с: 7.85654

Удельное скольжение:

Шестерни: -2.72183 Колеса: 1.25955

Степень точности изготовления зубчатых колес: 7

****************************************************

КОЭФФИЦИЕНТ НЕРАВНОМЕРНОСТИ РАСПРЕДЕЛЕНИЯ НАГРУЗКИ 1.320

****************************************************

Расчет на контактную прочность для ПРЯМОГО действия нагрузки

МЦК-Сателлит

ОПРЕДЕЛЕНИЕ ДОПУСКАЕМЫХ НАПРЯЖЕНИЙ ПРИ РАСЧЕТЕ НА КОНТАКТНУЮ ВЫНОСЛИВОСТЬ

СУММАРНОЕ ЧИСЛО ЦИКЛОВ НАГРУЖЕНИЙ: ШЕСТЕРНИ - 1.17928e+08 КОЛЕСА - 2.14414e+08

РАСЧЕТ ВЕДЕТСЯ ПРИ ПЕРЕМЕННОЙ НАГРУЗКЕ И ПЕРЕМЕННЫХ ОБОРОТАХ

Oкружная сила на делительном диаметре F(TH), H - 3556.36

Kоэффициент учитывающий характер циклограммы нагружения, MJU:

Шестерни - 0.6475 Колеса - 1.1773

Эквивалентное число циклов перемены напряжений N(HE):

Шестерни - 7.77007e+07 Колеса - 1.41274e+08

Коэффициенты, учитывающие окружную скорость Z(V):

Шестерни - 1 Колеса - 1

Kоэффициент, учитывающий радиальный размер зубчатого колеса K(XH):

Шестерни - 1 Колеса - 1

Kоэффициент, учитывающий влияние смазки K(L) - 1

Kоэффициент, учитывающий шероховатость сопряженных поверхностей зубьев Z(R) - 0.95

Коэффициент долговечности Z(N):

Шестерни - 1.07513 Колеса - 0.991873

Предел контактной выносливости поверхностей зубьев SIGMA(HLIM), MПa:

Шестерни - 1483.67 Колеса - 1368.78

Допускаемые контактные напряжения SIGMA(HP), МПа:

Шестерни - 1174.58 Колеса - 1083.62

Допускаемые контактные напряжения передачи, МПа - 1094.63

РАСЧЕТ НА КОНТАКТНУЮ ВЫНОСЛИВОСТЬ

Коэффициент, учитывающий форму сопряженных поверхностей зубьев, Z(H) - 2.42473

Коэффициент, учитывающий суммарную длину контактных линий, Z(EPSILON) - 0.798344

Коэффициент, учитывающий внешнюю динамическую нагрузку K(A) - 1.75

Коэффициент, учитывающий распределение нагрузки между зубьями, K(HALFA) - 1.08806

Коэффициент, учитывающий динамическую нагрузку, возникающую в зацеплении, K(HV) - 1.04198

Коэффициент, учитывающий распределение нагрузки по ширине венца, K(HBETTA) -1.07007

Коэффициент нагрузки K(H) - 2.12306

Контактные напряжения без учета дополнительных нагрузок SIGMA(HO), МПа - 750.509

Действующие в полюсе зацепления контактные напряжения SIGMA(H), МПа - 1093.54

РАСЧЕТ НА КОНТАКТНУЮ ПРОЧНОСТЬ ПРИ ДЕЙСТВИИ МАКСИМАЛЬНОЙ НАГРУЗКИ

Коэффициент, учитывающий динамическую нагрузку, возникающую в зацеплении при max моменте, K(HV) - 1.01889

Коэффициент нагрузки K(HMAX) - 2.07602

Максимальный момент М(max), Нм - 360

Средний момент М(1), Нм - 162

Контактные напряжения при действии максимальной нагрузки SIGMA(HMAX), МПа - 1612

Допускаемые контактные напряжения при действии максимальной нагрузки SIGMA(HPMAX):

Шестерни - 2640 Колеса - 2640

****************************************************

Расчет на контактную прочность для реверсивной нагрузки

МЦК-Сателлит

ОПРЕДЕЛЕНИЕ ДОПУСКАЕМЫХ НАПРЯЖЕНИЙ ПРИ РАСЧЕТЕ НА КОНТАКТНУЮ ВЫНОСЛИВОСТЬ

СУММАРНОЕ ЧИСЛО ЦИКЛОВ НАГРУЖЕНИЙ: ШЕСТЕРНИ - 1.10046e+09 КОЛЕСА - 2.00084e+09

РАСЧЕТ ВЕДЕТСЯ ПРИ ПЕРЕМЕННОЙ НАГРУЗКЕ И ПЕРЕМЕННЫХ ОБОРОТАХ

Oкружная сила на делительном диаметре F(TH), H - 2945.11

Kоэффициент учитывающий характер циклограммы нагружения, MJU:

Шестерни - 0.2470 Колеса - 0.4490

Эквивалентное число циклов перемены напряжений N(HE):

Шестерни - 2.96367e+07 Колеса - 5.38849e+07

Коэффициенты, учитывающие окружную скорость Z(V):

Шестерни - 1.00925 Колеса - 1.00925

Kоэффициент, учитывающий радиальный размер зубчатого колеса K(XH):

Шестерни - 1 Колеса - 1

Kоэффициент, учитывающий влияние смазки K(L) - 1

Kоэффициент, учитывающий шероховатость сопряженных поверхностей зубьев Z(R) - 0.95

Коэффициент долговечности Z(N):

Шестерни - 1.26248 Колеса - 1.14275

Предел контактной выносливости поверхностей зубьев SIGMA(HLIM), MПa:

Шестерни - 1742.23 Колеса - 1577

Допускаемые контактные напряжения SIGMA(HP), МПа:

Шестерни - 1392.02 Колеса - 1260.01

Допускаемые контактные напряжения передачи, МПа - 1284.68

РАСЧЕТ НА КОНТАКТНУЮ ВЫНОСЛИВОСТЬ

Коэффициент, учитывающий форму сопряженных поверхностей зубьев, Z(H) - 2.42473

Коэффициент, учитывающий суммарную длину контактных линий, Z(EPSILON) - 0.798344

Коэффициент, учитывающий внешнюю динамическую нагрузку K(A) - 1.75

Коэффициент, учитывающий распределение нагрузки между зубьями, K(HALFA) - 1.09502

Коэффициент, учитывающий динамическую нагрузку, возникающую в зацеплении, K(HV) - 1.06136

Коэффициент, учитывающий распределение нагрузки по ширине венца, K(HBETTA) -1.07007

Коэффициент нагрузки K(H) - 2.17638

Контактные напряжения без учета дополнительных нагрузок SIGMA(HO), МПа - 682.973

Действующие в полюсе зацепления контактные напряжения SIGMA(H), МПа - 1007.56

РАСЧЕТ НА КОНТАКТНУЮ ПРОЧНОСТЬ ПРИ ДЕЙСТВИИ МАКСИМАЛЬНОЙ НАГРУЗКИ

Коэффициент, учитывающий динамическую нагрузку, возникающую в зацеплении при max моменте, K(HV) - 1.02761

Коэффициент нагрузки K(HMAX) - 2.10718

Максимальный момент М(max), Нм - 298.125

Средний момент М(1), Нм - 134.156

Контактные напряжения при действии максимальной нагрузки SIGMA(HMAX), МПа - 1477.91

Допускаемые контактные напряжения при действии максимальной нагрузки SIGMA(HPMAX):

Шестерни - 2640 Колеса - 2640

****************************************************

РАСЧЕТ НА ИЗГИБНУЮ ПРОЧНОСТЬ ПАРЫ МЦК-САТЕЛЛИТ

Расчет зубьев МЦК

ОПРЕДЕЛЕНИЕ ДОПУСКАЕМЫХ НАПРЯЖЕНИЙ ПРИ РАСЧЕТЕ НА ИЗГИБНУЮ ВЫНОСЛИВОСТЬ

ПРЯМОЕ ДЕЙСТВИЕ НАГРУЗКИ

Oкружная сила на делительном диаметре для прямого действия нагрузки F(TF), H - 3556.36

Kоэффициент, учитывающий характер циклограммы для прямого действия нагрузки MJU(F1) - 29.7016

Эквивалентное число циклов перемены напряжений для прямого действия нагрузки N(FE) - 1.18806e+08

Расчетный момент, M(H) - 73.6364

Kоэффициент, учитывающий характер циклограммы для прямого действия нагрузки MJU(F1) - 58.8231

Эквивалентное число циклов перемены напряжений для прямого действия нагрузки N(FE) - 2.35292e+08

Расчетный момент, M(H) - 73.6364

Коэффициент долговечности K(FL) - 1.000

РЕВЕРСИВНОЕ ДЕЙСТВИЕ НАГРУЗКИ

НАГРУЗКА ПОСТОЯННА

Окружная сила на делительном диаметре для реверсивного действия нагрузки F(TF), H - 2945.11

Kоэффициент, учитывающий характер циклограммы, для реверсивного действия нагрузки MJU(F1) - 7.20091

Эквивалентное число циклов перемены напряжений для реверсивного действия нагрузки N(FE) - 2.88036e+07

Расчетный момент для реверсивного действия нагрузки, M(H) - 60.9801

Коэффициент долговечности для реверсивного действия нагрузки K(FL) - 1

Kоэффициент, учитывающий влияние двухстороннего приложения нагрузки, K(FC) - 0.792969

Kоэффициент, учитывающий влияние деформационного упрочнeния или электрохимической обработки переходной поверхности, K(FG) - 0.75

Kоэффициент, учитывающий влияние шлифования переходной - 1

Kоэффициент, учитывающий влияние шлифования переходной поверхности зуба шестерни, K(FD) - 1

Предел изломной выносливости, SIGMA(FLIM0), МПа - 950

Предел выносливости зубьев колес при изгибе, SIGMA(FLIM), МПа - 712.5

Kоэффициент безопасности, S(F) - 1.7825

Kоэффициент, учитывающий градиент напряжений и чувствительность материала к концентрации напряжений, Y(S) - 1.03022

Kоэффициент, учитывающий шероховатость переходной поверхности, Y(R) - 1

Kоэффициент, учитывающий размеры зубчатого колеса, K(XF) - 1

Допускаемое изгибное напряжение при расчете на выносливость, МПа - 411.8

РАСЧЕТ НА ИЗГИБНУЮ ВЫНОСЛИВОСТЬ

Коэффициент, учитывающий динамическую нагрузку, возникающую в зацеплении, K(FV) - 1.051

Коэффициент, учитывающий распределение нагрузки по ширине венца, K(FBETTA) - 1.153

Коэффициент, учитывающий распределение нагрузки между зубьями, K(FALFA) - 1.095

Коэффициент внешней динамической нагрузки KA - 1.750

Коэффициент нагрузки, K(F) - 2.321

Коэффициент, учитывающий наклон зубьев, Y(BETTA) - 0.868

Коэффициент, учитывающий перекрытие зубьев, Y(E) - 0.637

Коэффициент, учитывающий форму зуба, Y(FS) - 3.740

Действующие в полюсе зацепления изгибные напряжения, SIGMA(F), МПа - 284.499

РАСЧЕТ НА ИЗГИБНУЮ ПРОЧНОСТЬ ПРИ ДЕЙСТВИИ МАКСИМАЛЬНОЙ НАГРУЗКИ

Максимальная расчетная нагрузка F(Tmax), Н - 7903.03

Pасчетная нагрузка F(T), Н - 3556.36

Действующие максимальные изгибные напряжения SIGMA(FMAX), МПа - 361.268

Допускаемые максимальные изгибные напряжения SIGMA(FPMAX), МПа - 1932

Расчет зубьев сателлита

ОПРЕДЕЛЕНИЕ ДОПУСКАЕМЫХ НАПРЯЖЕНИЙ ПРИ РАСЧЕТЕ НА ИЗГИБНУЮ ВЫНОСЛИВОСТЬ

ПРЯМОЕ ДЕЙСТВИЕ НАГРУЗКИ

Oкружная сила на делительном диаметре для прямого действия нагрузки F(TF), H - 3556.36

Kоэффициент, учитывающий характер циклограммы для прямого действия нагрузки MJU(F1) - 0

Эквивалентное число циклов перемены напряжений для прямого действия нагрузки N(FE) - 0

Расчетный момент, M(H) - 162

Kоэффициент, учитывающий характер циклограммы для прямого действия нагрузки MJU(F1) - 0

Эквивалентное число циклов перемены напряжений для прямого действия нагрузки N(FE) - 0

Расчетный момент, M(H) - 162

Коэффициент долговечности K(FL) - 1.630

РЕВЕРСИВНОЕ ДЕЙСТВИЕ НАГРУЗКИ

НАГРУЗКА ПОСТОЯННА

Окружная сила на делительном диаметре для реверсивного действия нагрузки F(TF), H - 2945.11

Kоэффициент, учитывающий характер циклограммы, для реверсивного действия нагрузки MJU(F1) - 0

Эквивалентное число циклов перемены напряжений для реверсивного действия нагрузки N(FE) - 0

Расчетный момент для реверсивного действия нагрузки, M(H) - 134.156

Коэффициент долговечности для реверсивного действия нагрузки K(FL) - 1.63

Kоэффициент, учитывающий влияние двухстороннего приложения нагрузки, K(FC) - 0.792969

Kоэффициент, учитывающий влияние деформационного упрочнeния или электрохимической обработки переходной поверхности, K(FG) - 0.75

Kоэффициент, учитывающий влияние шлифования переходной - 1.63

Kоэффициент, учитывающий влияние шлифования переходной поверхности зуба шестерни, K(FD) - 1

Предел изломной выносливости, SIGMA(FLIM0), МПа - 950

Предел выносливости зубьев колес при изгибе, SIGMA(FLIM), МПа - 920.934

Kоэффициент безопасности, S(F) - 1.7825

Kоэффициент, учитывающий градиент напряжений и чувствительность материала к концентрации напряжений, Y(S) - 1.03022

Kоэффициент, учитывающий шероховатость переходной поверхности, Y(R) - 1

Kоэффициент, учитывающий размеры зубчатого колеса, K(XF) - 1

Допускаемое изгибное напряжение при расчете на выносливость, МПа - 532.268

РАСЧЕТ НА ИЗГИБНУЮ ВЫНОСЛИВОСТЬ

Коэффициент, учитывающий динамическую нагрузку, возникающую в зацеплении, K(FV) - 1.051

Коэффициент, учитывающий распределение нагрузки по ширине венца, K(FBETTA) - 1.153

Коэффициент, учитывающий распределение нагрузки между зубьями, K(FALFA) - 1.095

Коэффициент внешней динамической нагрузки KA - 1.750

Коэффициент нагрузки, K(F) - 2.321

Коэффициент, учитывающий наклон зубьев, Y(BETTA) - 0.868

Коэффициент, учитывающий перекрытие зубьев, Y(E) - 0.637

Коэффициент, учитывающий форму зуба, Y(FS) - 4.065

Действующие в полюсе зацепления изгибные напряжения, SIGMA(F), МПа - 309.176

РАСЧЕТ НА ИЗГИБНУЮ ПРОЧНОСТЬ ПРИ ДЕЙСТВИИ МАКСИМАЛЬНОЙ НАГРУЗКИ

Максимальная расчетная нагрузка F(Tmax), Н - 7903.03

Pасчетная нагрузка F(T), Н - 3556.36

Действующие максимальные изгибные напряжения SIGMA(FMAX), МПа - 392.605

Допускаемые максимальные изгибные напряжения SIGMA(FPMAX), МПа - 1932

****************************************************

Расчет геометрии пары Сателлит-БЦК

Коэффициенты смещения Х(1)= 0, X(2)= 0

Делительное межосевое расстояние a, мм: 66.2577

Коэффициент разности смещений X(d)= 0

Угол профиля ALFA(t)= 20.6365

Угол зацепления ALFA(tw)= 20.6365

Межосевое расстояние a(w), мм= 66.2577

Делительные диаметры d, мм:

Шестерни = 41.411 Колеса = 173.926

Передаточное отношение U= 4.2

Начальные диаметры d(w), мм:

Шестерни = 41.411 Колеса = 173.926

Коэффициент воспринимаемого смещения Y = 0

Коэффициент уравнительного смещения DELTA(Y) = 0

Диаметры вершин зубьев d(a), мм:

Шестерни: 45.411 Колеса: 170.726

Диаметры впадин зубьев d(f), мм:

Шестерни: 36.411 Колеса: 178.926

Ocновной диаметр d(b), мм:

Шестерни: 38.7539 Колеса: 162.766

Угол профиля зуба в точке окружности вершин ALFA(a):

Шестерни: 31.4163 Колеса: 17.5648

Шаг зацепления P(alfa), мм: 5.90165

Осевой шаг P(x), мм: 24.2641

Коэффициенты торцевого перекрытия E(ALFA):

Шестерни: 0.74545 Колеса: -0.802929

Коэффициенты торцевого перекрытия E(ALFA): 1.54838

Коэффициенты осевого перекрытия E(BETTA): 1.54838

Коэффициенты перекрытия E(Y): 2.78478

Основной угол наклона BETTA(B): 14.077

Эквивалентное число зубьев Z(V):

Шестерни: 22.1921 Колеса: 93.2069

Окружная скорость в зацеплении V, м/с: 7.85654

Удельное скольжение:

Шестерни: -0.141294 Колеса: 0.412688

Степень точности изготовления зубчатых колес: 7

****************************************************

КОЭФФИЦИЕНТ НЕРАВНОМЕРНОСТИ РАСПРЕДЕЛЕНИЯ НАГРУЗКИ 1.320

****************************************************

# ПИЛОЖЕНИЕ Г

Расчет осей сателлитов

clc

clear all

% format bank

%% Начальные данные

sigma_iz = 900*10^6;

sigma_sm_iz = 194*10^6;

t_iz = 135*10^6;

% Моменты на водилах планетарных рядов

K_1 = [0.00 0.00 -0.71 -0.56 0.00 0.32 0.29 0.00 -1.61 -1.00];

K_2 = [0.00 2.28 1.28 1.01 0.00 -0.59 -0.52 -0.44 2.92 1.81];

K_3 = [2.70 2.70 1.52 1.20 0.44 0.00 0.00 0.00 0.00 0.00];

K_4 = [7.83 3.48 1.95 1.54 1.28 1.12 1.00 0.85 -5.57 -3.46];

A = [3 3 3 4];% Количество сателлитов

K_ner = [1 1 1 1];% Коэффициент неравномерности

R_st = [68.3282 65.2224 68.3282 66.2577]*10^(-3);% Радиус, на котором расположены оси сателлитов

M_max = 750; % Макс момент двигателя

n_dvs_max = 3000;% Макс число оборотов двигателя

ro = 7874;% Плотность легированной стали

b_st = [15 20 15 30]*10^(-3);% Ширина сателлита

D_st = [33.1288 41.411 35.1994 41.411]*10^(-3);% Делительный диаметр сателлита

d_st = [15 20 15 20]*10^(-3);% Внешний диаметр оси сателлита

d_0_st = [10 15 10 15]*10^(-3);% Диаметр отверстия в оси сателлита

%Угловые скорости сателлитов

% K_vod_1 = [-11.321 -5.125 0.000 3.125 3.644 3.125 0.000 -5.125 0.000 3.125];

% K_vod_2 = [2.628 0.900 -0.529 -1.401 -1.546 -1.326 0.000 2.174 -2.174 -3.499];

% K_vod_3 = [1.799 1.799 1.799 1.799 1.799 1.543 0.000 -2.530 7.387 8.929];

% K_vod_4 = [-0.917 -0.314 0.185 0.489 0.539 0.462 0.000 -0.758 0.758 1.221];

K_vod_1 = [1.000 1.000 1.000 1.000 1.000 1.000 1.000 1.000 1.000 1.000];

K_vod_2 = [0.000 0.244 0.586 0.795 1.000 1.000 1.000 1.000 0.000 0.000];

K_vod_3 = [0.370 0.370 0.370 0.370 0.370 0.682 1.000 1.521 -0.521 -0.838];

K_vod_4 = [0.128 0.287 0.512 0.648 0.783 0.890 1.000 1.180 -0.180 -0.289];

l = [25 30 25 40]*10^(-3);% Длина оси сателлита

delta = [4 4 4 4]*10^(-3); % толщина щеки

%% Расчет

[K_1_1, I_1_1] = max(abs(K_1));

[K_2_1, I_2_1] = max(abs(K_2));

[K_3_1, I_3_1] = max(abs(K_3));

[K_4_1, I_4_1] = max(abs(K_4));

K1 = [K_1_1 K_2_1 K_3_1 K_4_1];

K = [K_1(I_1_1) K_2(I_2_1) K_3(I_3_1) K_4(I_4_1)];

[K_vod_1_1, I_vod_1_1] = max(abs(K_vod_1));

[K_vod_2_1, I_vod_2_1] = max(abs(K_vod_2));

[K_vod_3_1, I_vod_3_1] = max(abs(K_vod_3));

[K_vod_4_1, I_vod_4_1] = max(abs(K_vod_4));

K_vod1 = [K_vod_1_1 K_vod_2_1 K_vod_3_1 K_vod_4_1];

K_vod = [K_vod_1(I_vod_1_1) K_vod_2(I_vod_2_1) K_vod_3(I_vod_3_1) K_vod_4(I_vod_4_1)];

F_vod = K.*M_max.*K_ner./(A.*R_st); % Радиальная нагрузка на оси сателита

F_vod_1 = K_1(1)*M_max*K_ner(1)./(A.*R_st(1)); % Радиальная нагрузка на оси сателита 1 зад перед

V = pi.*b_st.*(D_st.^2-d_st.^2)/4;

m_st = ro*V;

omega = (K_vod*2*n_dvs_max*pi)/60;

% omega(1) = (K_vod(1)*2*1500*pi)/60;

% P_ch = m_st.*omega.*R_st;

P_ch = m_st.*omega.^2.*R_st;

F_r = (F_vod.^2+P_ch.^2).^(1/2);

% ур-ние моментов относительно опоры 1

N_x = 1/2.*F_r; % максимальное на 3 ряду диаметр сателита 50

N_x_1 = N_x;

M_i = N_x.*l./2;

W = 0.2*d_st.^3.*(1-((d_0_st.^4)./(d_st.^4)));

W_1=W.*10^9;

sigma = M_i./W;

Zapas_prochnosti_si = sigma_iz./sigma;

if min(Zapas_prochnosti_si) > 1.15

disp ('По прочности прошло)')

else

disp ('Проблемы с прочностью(')

end

% срез

t_sr = 4*N_x./(pi*(d_st.^2-d_0_st.^2));

Zapas_prochnosti_t_sr = t_iz./t_sr;

if min(Zapas_prochnosti_t_sr) > 1.15

disp ('Срез по прочности прошло)')

else

disp ('Срез проблемы с прочностью(')

end

% смятие

sigma_sm = N_x./(delta.*d_st);

Zapas_prochnosti_sm = sigma_sm_iz./sigma_sm;

if min(Zapas_prochnosti_sm) > 1.15

disp ('Смятие по прочности прошло)')

else

disp ('Смятие проблемы с прочностью(')

end

SKI = [Zapas_prochnosti_si; Zapas_prochnosti_t_sr; Zapas_prochnosti_sm];

# ПРИЛОЖЕНИЕ Д

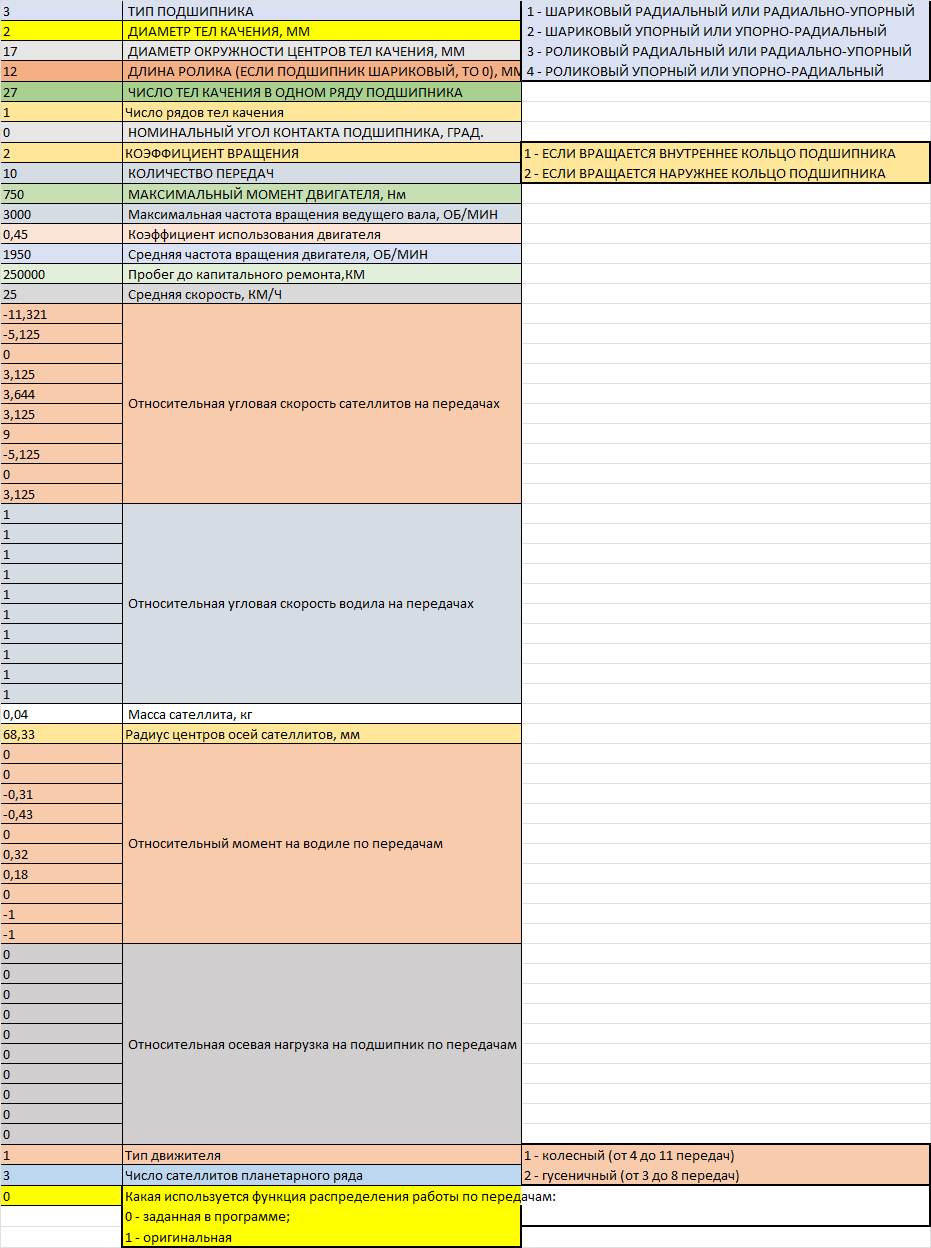
[picture p15: figure]

# ПРИЛОЖЕНИЕ Е

Планетарный ряд №1

ИСХОДНЫЕ ДАННЫЕ

Тип подшипника: роликовый радиальный или радиально-упорный

Диаметр тел качения - 2, мм

Диаметр окружности центров тел качения - 17, мм

Длина роликов - 12, мм

Число тел качения в одном ряду подшипника - 27

Число рядов тел качения - 1

Номинальный угол контакта подшипника - 0, град.

Вращается внешнее кольцо подшипника

Количество передач в КПП - 10

Максимальный момент на ведущем валу КПП - 750, Нм

Максимальная частота вращения ведущего вала КПП - 314, об/мин

Коэффициент использования момента двигателя - 0.45

Средняя частота вращения двигателя - 204.1, об/мин

Пробег до капитального ремонта - 250000, км

Средняя скорость - 25, км/ч

Относительная угловая скорость подшипника (для ПР - сателлитов)

на передачах:

1 - -11.321

2 - -5.125

3 - 0

4 - 3.125

5 - 3.644

6 - 3.125

7 - 9

8 - -5.125

9 - 0

10 - 3.125

Относительная угловая скорость водила на передачах:

1 - 1

2 - 1

3 - 1

4 - 1

5 - 1

6 - 1

7 - 1

8 - 1

9 - 1

10 - 1

Масса сателлита - 0.04, кг

Радиус осей сателлитов - 68.33, мм

Относительный момент на водиле по передачам

1 - 0

2 - 0

3 - -0.31

4 - -0.43

5 - 0

6 - 0.32

7 - 0.18

8 - 0

9 - -1

10 - -1

Относительная осевая нагрузка на подшипник по передачам:

1 - 0

2 - 0

3 - 0

4 - 0

5 - 0

6 - 0

7 - 0

8 - 0

9 - 0

10 - 0

Тип движителя: колесный

****************************************************

РАСЧЕТ СТАТИЧЕСКОЙ ГРУЗОПОДЪЕМНОСТИ:

Максимальная радиальная нагрузка на подшипник - 3668.63, Н

Максимальная осевая нагрузка на подшипник - 0, Н

СТАТИЧЕСКАЯ РАДИАЛЬНАЯ И ЭКВИВАЛЕНТНАЯ РАДИАЛЬНАЯ ГРУЗОПОДЪEМНОСТЬ:

C(or)=25157.6; P(or)=3668.63

****************************************************

РАСПРЕДЕЛЕНИЕ ВРЕМЕНИ РАБОТЫ ПОДШИПНИКА ПО ПЕРЕДАЧАМ:

1 - 0.005:

2 - 0.01:

3 - 0.015:

4 - 0.025:

5 - 0.04:

6 - 0.065:

7 - 0.1:

8 - 0.15:

9 - 0.24:

10 - 0.3:

РАДИАЛЬНАЯ, ЦЕНТРОБЕЖНАЯ И СУММАРНАЯ РАДИАЛЬНАЯ СИЛЫ

ПО ПЕРЕДАЧАМ, H:

1 - 0.00 113.86 113.86:

2 - 0.00 113.86 113.86:

3 - 510.39 113.86 522.94:

4 - 707.96 113.86 717.06:

5 - 0.00 113.86 113.86:

6 - 526.85 113.86 539.02:

7 - 296.36 113.86 317.47:

8 - 0.00 113.86 113.86:

9 - 1646.42 113.86 1650.35:

10 - 1646.42 113.86 1650.35:

CУММАРНОЕ ЧИСЛО ОБОРОТОВ ПОДШИПНИКА N= 3.84661e+08

СРЕДНЯЯ РАДИАЛЬНАЯ СИЛА F(r)= 1153.23 H

СРЕДНЯЯ ОСЕВАЯ СИЛА F(a)= 0 H

****************************************************

РАСЧЕТ ДИНАМИЧЕСКОЙ ГРУЗОПОДЪЕМНОСТИ:

КОЭФ., ЗАВИСЯЩИЙ ОТ ГЕОМЕТРИИ, ТОЧНОСТИ И МАТЕРИАЛА ПОДШИПНИКА:

F(c): 86.1647

КОЭФФИЦИЕНТ, ХАРАКТЕРИЗУЮЩИЙ СВОЙСТВА СТАЛИ:

B(m):- 1.3

КОЭФФИЦИЕНТЫ ДИНАМИЧЕСКИХ РАДИАЛЬНОЙ И ОСЕВОЙ НАГРУЗОК:

X= 0; Y= 0

ДИНАМИЧЕСКИЙ КОЭФФИЦИЕНТ K(Б)= 1.4

ТЕМПЕРАТУРНЫЙ КОЭФФИЦИЕНТ К(Т)= 1

КОЭФФИЦИЕНТ V= 1.2

БАЗОВАЯ ДИНАМИЧЕСКАЯ РАДИАЛЬНАЯ РАСЧЕТНАЯ ГРУЗОПОДЪEМНОСТЬ:

C(r)= 16328.1

БАЗОВАЯ ДИНАМИЧЕСКАЯ ЭКВИВАЛЕНТНАЯ РАДИАЛЬНАЯ НАГРУЗКА:

P(r)= 1153.23

КОЭФФИЦИЕНТ A(23)= 0.8

БАЗОВЫЙ РАСЧЕТНЫЙ РЕСУРС, [МИЛ.ОБОРОТОВ L(10)=5493.25

ТРЕБУЕМЫЙ РЕСУРС, [МИЛ.ОБОРОТОВ] L(T)=384.661

РАСЧЕТНЫЙ РЕСУРС ПОДШИПНИКОВ В КИЛОМЕТРАХ ПРОБЕГА L(s)=3.57019e+06

Планетарный ряд №2

ИСХОДНЫЕ ДАННЫЕ

Тип подшипника: роликовый радиальный или радиально-упорный

Диаметр тел качения - 2, мм

Диаметр окружности центров тел качения - 17, мм

Длина роликов - 15, мм

Число тел качения в одном ряду подшипника - 34

Число рядов тел качения - 1

Номинальный угол контакта подшипника - 0, град.

Вращается внешнее кольцо подшипника

Количество передач в КПП - 10

Максимальный момент на ведущем валу КПП - 750, Нм

Максимальная частота вращения ведущего вала КПП - 314, об/мин

Коэффициент использования момента двигателя - 0.45

Средняя частота вращения двигателя - 204.1, об/мин

Пробег до капитального ремонта - 250000, км

Средняя скорость - 25, км/ч

Относительная угловая скорость подшипника (для ПР - сателлитов)

на передачах:

1 - 2.628

2 - 0.9

3 - -0.529

4 - -1.401

5 - -1.546

6 - -1.326

7 - 0

8 - 2.174

9 - -2.174

10 - -3.499

Относительная угловая скорость водила на передачах:

1 - 0

2 - 0.414

3 - 0.756

4 - 0.965

5 - 1

6 - 1

7 - 1

8 - 1

9 - 0

10 - 0

Масса сателлита - 0.1, кг

Радиус осей сателлитов - 65.22, мм

Относительный момент на водиле по передачам

1 - 0

2 - 1.34

3 - 0.92

4 - 0.77

5 - 0

6 - -0.59

7 - -0.52

8 - -0.44

9 - 2.92

10 - 1.81

Относительная осевая нагрузка на подшипник по передачам:

1 - 0

2 - 0

3 - 0

4 - 0

5 - 0

6 - 0

7 - 0

8 - 0

9 - 0

10 - 0

Тип движителя: колесный

****************************************************

РАСЧЕТ СТАТИЧЕСКОЙ ГРУЗОПОДЪЕМНОСТИ:

Максимальная радиальная нагрузка на подшипник - 11192.9, Н

Максимальная осевая нагрузка на подшипник - 0, Н

СТАТИЧЕСКАЯ РАДИАЛЬНАЯ И ЭКВИВАЛЕНТНАЯ РАДИАЛЬНАЯ ГРУЗОПОДЪEМНОСТЬ:

C(or)=39600; P(or)=11192.9

****************************************************

РАСПРЕДЕЛЕНИЕ ВРЕМЕНИ РАБОТЫ ПОДШИПНИКА ПО ПЕРЕДАЧАМ:

1 - 0.005:

2 - 0.01:

3 - 0.015:

4 - 0.025:

5 - 0.04:

6 - 0.065:

7 - 0.1:

8 - 0.15:

9 - 0.24:

10 - 0.3:

РАДИАЛЬНАЯ, ЦЕНТРОБЕЖНАЯ И СУММАРНАЯ РАДИАЛЬНАЯ СИЛЫ

ПО ПЕРЕДАЧАМ, H:

1 - 0.00 0.00 0.00:

2 - 2311.41 46.57 2311.88:

3 - 1586.94 155.28 1594.52:

4 - 1328.20 253.00 1352.08:

5 - 0.00 271.69 271.69:

6 - 1017.71 271.69 1053.35:

7 - 896.96 271.69 937.21:

8 - 758.97 271.69 806.13:

9 - 5036.80 0.00 5036.80:

10 - 3122.13 0.00 3122.13:

CУММАРНОЕ ЧИСЛО ОБОРОТОВ ПОДШИПНИКА N= 2.58475e+08

СРЕДНЯЯ РАДИАЛЬНАЯ СИЛА F(r)= 3674 H

СРЕДНЯЯ ОСЕВАЯ СИЛА F(a)= 0 H

****************************************************

РАСЧЕТ ДИНАМИЧЕСКОЙ ГРУЗОПОДЪЕМНОСТИ:

КОЭФ., ЗАВИСЯЩИЙ ОТ ГЕОМЕТРИИ, ТОЧНОСТИ И МАТЕРИАЛА ПОДШИПНИКА:

F(c): 86.1647

КОЭФФИЦИЕНТ, ХАРАКТЕРИЗУЮЩИЙ СВОЙСТВА СТАЛИ:

B(m):- 1.3

КОЭФФИЦИЕНТЫ ДИНАМИЧЕСКИХ РАДИАЛЬНОЙ И ОСЕВОЙ НАГРУЗОК:

X= 0; Y= 0

ДИНАМИЧЕСКИЙ КОЭФФИЦИЕНТ K(Б)= 1.4

ТЕМПЕРАТУРНЫЙ КОЭФФИЦИЕНТ К(Т)= 1

КОЭФФИЦИЕНТ V= 1.2

БАЗОВАЯ ДИНАМИЧЕСКАЯ РАДИАЛЬНАЯ РАСЧЕТНАЯ ГРУЗОПОДЪEМНОСТЬ:

C(r)= 23088.6

БАЗОВАЯ ДИНАМИЧЕСКАЯ ЭКВИВАЛЕНТНАЯ РАДИАЛЬНАЯ НАГРУЗКА:

P(r)= 3674

КОЭФФИЦИЕНТ A(23)= 0.8

БАЗОВЫЙ РАСЧЕТНЫЙ РЕСУРС, [МИЛ.ОБОРОТОВ L(10)=366.397

ТРЕБУЕМЫЙ РЕСУРС, [МИЛ.ОБОРОТОВ] L(T)=258.475

РАСЧЕТНЫЙ РЕСУРС ПОДШИПНИКОВ В КИЛОМЕТРАХ ПРОБЕГА L(s)=354384

Планетарный ряд №3

ИСХОДНЫЕ ДАННЫЕ

Тип подшипника: роликовый радиальный или радиально-упорный

Диаметр тел качения - 2, мм

Диаметр окружности центров тел качения - 17, мм

Длина роликов - 13, мм

Число тел качения в одном ряду подшипника - 27

Число рядов тел качения - 1

Номинальный угол контакта подшипника - 0, град.

Вращается внешнее кольцо подшипника

Количество передач в КПП - 10

Максимальный момент на ведущем валу КПП - 750, Нм

Максимальная частота вращения ведущего вала КПП - 314, об/мин

Коэффициент использования момента двигателя - 0.45

Средняя частота вращения двигателя - 204.1, об/мин

Пробег до капитального ремонта - 250000, км

Средняя скорость - 25, км/ч

Относительная угловая скорость подшипника (для ПР - сателлитов)

на передачах:

1 - 1.799

2 - 1.799

3 - 1.799

4 - 1.799

5 - 1.799

6 - 1.543

7 - 0

8 - -2.53

9 - 7.387

10 - 8.929

Относительная угловая скорость водила на передачах:

1 - 0.63

2 - 0.63

3 - 0.63

4 - 0.63

5 - 0.63

6 - 0.682

7 - 1

8 - 1.521

9 - -0.521

10 - -0.838

Масса сателлита - 0.05, кг

Радиус осей сателлитов - 68.33, мм

Относительный момент на водиле по передачам

1 - 1.59

2 - 1.59

3 - 1.09

4 - 0.91

5 - 0.4

6 - 0

7 - 0

8 - 0

9 - 0

10 - 0

Относительная осевая нагрузка на подшипник по передачам:

1 - 0

2 - 0

3 - 0

4 - 0

5 - 0

6 - 0

7 - 0

8 - 0

9 - 0

10 - 0

Тип движителя: колесный

****************************************************

РАСЧЕТ СТАТИЧЕСКОЙ ГРУЗОПОДЪЕМНОСТИ:

Максимальная радиальная нагрузка на подшипник - 5818.89, Н

Максимальная осевая нагрузка на подшипник - 0, Н

СТАТИЧЕСКАЯ РАДИАЛЬНАЯ И ЭКВИВАЛЕНТНАЯ РАДИАЛЬНАЯ ГРУЗОПОДЪEМНОСТЬ:

C(or)=27254.1; P(or)=5818.89

****************************************************

РАСПРЕДЕЛЕНИЕ ВРЕМЕНИ РАБОТЫ ПОДШИПНИКА ПО ПЕРЕДАЧАМ:

1 - 0.005:

2 - 0.01:

3 - 0.015:

4 - 0.025:

5 - 0.04:

6 - 0.065:

7 - 0.1:

8 - 0.15:

9 - 0.24:

10 - 0.3:

РАДИАЛЬНАЯ, ЦЕНТРОБЕЖНАЯ И СУММАРНАЯ РАДИАЛЬНАЯ СИЛЫ

ПО ПЕРЕДАЧАМ, H:

1 - 2617.81 56.49 2618.42:

2 - 2617.81 56.49 2618.42:

3 - 1794.60 56.49 1795.49:

4 - 1498.24 56.49 1499.31:

5 - 658.57 56.49 660.99:

6 - 0.00 66.20 66.20:

7 - 0.00 142.32 142.32:

8 - 0.00 329.25 329.25:

9 - 0.00 38.63 38.63:

10 - 0.00 99.94 99.94:

CУММАРНОЕ ЧИСЛО ОБОРОТОВ ПОДШИПНИКА N= 6.24825e+08

СРЕДНЯЯ РАДИАЛЬНАЯ СИЛА F(r)= 624.074 H

СРЕДНЯЯ ОСЕВАЯ СИЛА F(a)= 0 H

****************************************************

РАСЧЕТ ДИНАМИЧЕСКОЙ ГРУЗОПОДЪЕМНОСТИ:

КОЭФ., ЗАВИСЯЩИЙ ОТ ГЕОМЕТРИИ, ТОЧНОСТИ И МАТЕРИАЛА ПОДШИПНИКА:

F(c): 86.1647

КОЭФФИЦИЕНТ, ХАРАКТЕРИЗУЮЩИЙ СВОЙСТВА СТАЛИ:

B(m):- 1.3

КОЭФФИЦИЕНТЫ ДИНАМИЧЕСКИХ РАДИАЛЬНОЙ И ОСЕВОЙ НАГРУЗОК:

X= 0; Y= 0

ДИНАМИЧЕСКИЙ КОЭФФИЦИЕНТ K(Б)= 1.4

ТЕМПЕРАТУРНЫЙ КОЭФФИЦИЕНТ К(Т)= 1

КОЭФФИЦИЕНТ V= 1.2

БАЗОВАЯ ДИНАМИЧЕСКАЯ РАДИАЛЬНАЯ РАСЧЕТНАЯ ГРУЗОПОДЪEМНОСТЬ:

C(r)= 17377

БАЗОВАЯ ДИНАМИЧЕСКАЯ ЭКВИВАЛЕНТНАЯ РАДИАЛЬНАЯ НАГРУЗКА:

P(r)= 624.074

КОЭФФИЦИЕНТ A(23)= 0.8

БАЗОВЫЙ РАСЧЕТНЫЙ РЕСУРС, [МИЛ.ОБОРОТОВ L(10)=52345.9

ТРЕБУЕМЫЙ РЕСУРС, [МИЛ.ОБОРОТОВ] L(T)=624.825

РАСЧЕТНЫЙ РЕСУРС ПОДШИПНИКОВ В КИЛОМЕТРАХ ПРОБЕГА L(s)=2.09442e+07

Планетарный ряд №4

ИСХОДНЫЕ ДАННЫЕ

Тип подшипника: роликовый радиальный или радиально-упорный

Диаметр тел качения - 2, мм

Диаметр окружности центров тел качения - 17, мм

Длина роликов - 20, мм

Число тел качения в одном ряду подшипника - 34

Число рядов тел качения - 1

Номинальный угол контакта подшипника - 0, град.

Вращается внешнее кольцо подшипника

Количество передач в КПП - 10

Максимальный момент на ведущем валу КПП - 750, Нм

Максимальная частота вращения ведущего вала КПП - 314, об/мин

Коэффициент использования момента двигателя - 0.45

Средняя частота вращения двигателя - 204.1, об/мин

Пробег до капитального ремонта - 250000, км

Средняя скорость - 25, км/ч

Относительная угловая скорость подшипника (для ПР - сателлитов)

на передачах:

1 - -0.917

2 - -0.314

3 - 0.185

4 - 0.489

5 - 0.539

6 - 0.462

7 - 0

8 - -0.758

9 - 0.758

10 - 1.221

Относительная угловая скорость водила на передачах:

1 - 0.217

2 - 0.488

3 - 0.713

4 - 0.85

5 - 0.872

6 - 0.89

7 - 1

8 - 1.18

9 - -0.18

10 - -0.289

Масса сателлита - 0.13, кг

Радиус осей сателлитов - 66.26, мм

Относительный момент на водиле по передачам

1 - 4.61

2 - 2.05

3 - 1.4

4 - 1.18

5 - 1.15

6 - 1.12

7 - 1

8 - 0.85

9 - -5.57

10 - -3.46

Относительная осевая нагрузка на подшипник по передачам:

1 - 0

2 - 0

3 - 0

4 - 0

5 - 0

6 - 0

7 - 0

8 - 0

9 - 0

10 - 0

Тип движителя: колесный

****************************************************

РАСЧЕТ СТАТИЧЕСКОЙ ГРУЗОПОДЪЕМНОСТИ:

Максимальная радиальная нагрузка на подшипник - 21015.7, Н

Максимальная осевая нагрузка на подшипник - 0, Н

СТАТИЧЕСКАЯ РАДИАЛЬНАЯ И ЭКВИВАЛЕНТНАЯ РАДИАЛЬНАЯ ГРУЗОПОДЪEМНОСТЬ:

C(or)=52800; P(or)=21015.7

****************************************************

РАСПРЕДЕЛЕНИЕ ВРЕМЕНИ РАБОТЫ ПОДШИПНИКА ПО ПЕРЕДАЧАМ:

1 - 0.005:

2 - 0.01:

3 - 0.015:

4 - 0.025:

5 - 0.04:

6 - 0.065:

7 - 0.1:

8 - 0.15:

9 - 0.24:

10 - 0.3:

РАДИАЛЬНАЯ, ЦЕНТРОБЕЖНАЯ И СУММАРНАЯ РАДИАЛЬНАЯ СИЛЫ

ПО ПЕРЕДАЧАМ, H:

1 - 7827.12 16.90 7827.14:

2 - 3480.61 85.45 3481.66:

3 - 2377.00 182.41 2383.99:

4 - 2003.47 259.25 2020.18:

5 - 1952.54 272.84 1971.51:

6 - 1901.60 284.22 1922.72:

7 - 1697.86 358.82 1735.36:

8 - 1443.18 499.63 1527.22:

9 - 9457.06 11.63 9457.07:

10 - 5874.58 29.97 5874.66:

CУММАРНОЕ ЧИСЛО ОБОРОТОВ ПОДШИПНИКА N= 9.01593e+07

СРЕДНЯЯ РАДИАЛЬНАЯ СИЛА F(r)= 6920.73 H

СРЕДНЯЯ ОСЕВАЯ СИЛА F(a)= 0 H

****************************************************

РАСЧЕТ ДИНАМИЧЕСКОЙ ГРУЗОПОДЪЕМНОСТИ:

КОЭФ., ЗАВИСЯЩИЙ ОТ ГЕОМЕТРИИ, ТОЧНОСТИ И МАТЕРИАЛА ПОДШИПНИКА:

F(c): 86.1647

КОЭФФИЦИЕНТ, ХАРАКТЕРИЗУЮЩИЙ СВОЙСТВА СТАЛИ:

B(m):- 1.3

КОЭФФИЦИЕНТЫ ДИНАМИЧЕСКИХ РАДИАЛЬНОЙ И ОСЕВОЙ НАГРУЗОК:

X= 0; Y= 0

ДИНАМИЧЕСКИЙ КОЭФФИЦИЕНТ K(Б)= 1.4

ТЕМПЕРАТУРНЫЙ КОЭФФИЦИЕНТ К(Т)= 1

КОЭФФИЦИЕНТ V= 1.2

БАЗОВАЯ ДИНАМИЧЕСКАЯ РАДИАЛЬНАЯ РАСЧЕТНАЯ ГРУЗОПОДЪEМНОСТЬ:

C(r)= 28878.3

БАЗОВАЯ ДИНАМИЧЕСКАЯ ЭКВИВАЛЕНТНАЯ РАДИАЛЬНАЯ НАГРУЗКА:

P(r)= 6920.73

КОЭФФИЦИЕНТ A(23)= 0.8

БАЗОВЫЙ РАСЧЕТНЫЙ РЕСУРС, [МИЛ.ОБОРОТОВ L(10)=93.5745

ТРЕБУЕМЫЙ РЕСУРС, [МИЛ.ОБОРОТОВ] L(T)=90.1593

РАСЧЕТНЫЙ РЕСУРС ПОДШИПНИКОВ В КИЛОМЕТРАХ ПРОБЕГА L(s)=259470

# ПРИЛОЖЕНИЕ Ж

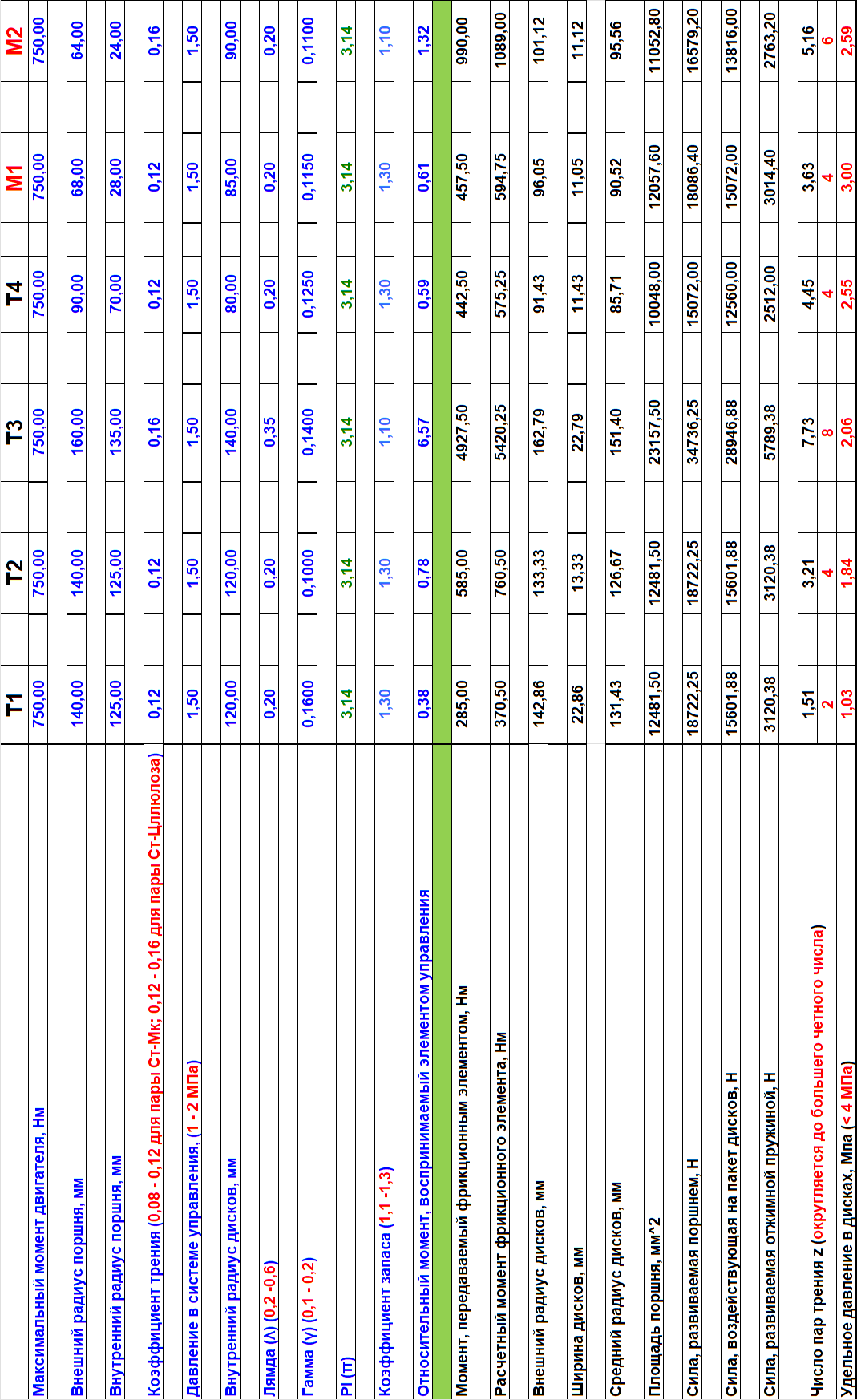
[picture p16: figure]

Инв. № подл. Подп. и дата Взам. инв. № Подп. и дата Инв. № дубл. Изм. Лист № докум. Подп. Дата Лист 48
