S1NZH/Course-project-9.101/Лаб.работа/Допускаемые напряжения для расчета валов.docx

## Допускаемые напряжения для углеродистых сталей обыкновенного качества в горячекатаном состоянии

Марка стали по ГОСТ 380 | Допускаемые напряжения, МПа
| При растяжении [σр] | | | При изгибе [σиз] | | | При кручении [τкр] | | | При срезе [τср] | | | | При смятии [σсм]
| I | II | III | I | II | III | I | II | III | | I | II | III | I | II
Ст 2 | 115 | 80 | 60 | 140 | 100 | 80 | 85 | 65 | 50 | | 70 | 50 | 40 | 175 | 120
Ст 3 | 125 | 90 | 70 | 150 | 110 | 85 | 95 | 65 | 50 | | 75 | 50 | 40 | 190 | 135
Ст 4 | 140 | 95 | 75 | 170 | 120 | 95 | 105 | 75 | 60 | | 85 | 65 | 50 | 210 | 145
Ст 5 | 165 | 115 | 90 | 200 | 140 | 110 | 125 | 90 | 70 | | 100 | 65 | 55 | 250 | 175
Ст 6 | 195 | 140 | 110 | 230 | 170 | 135 | 145 | 105 | 80 | | 115 | 85 | 65 | 290 | 210

Механические свойства и допустимые напряжения углеродистых качественных конструкционных сталей

### Примечание. Условные обозначения термической обработки:

О — отжиг; Н — нормализация; У — улучшение; Ц — цементация; ТВЧ — закалка с нагревом т.в.ч.; В — закалка с охлаждением в воде; М — закалка с охлаждением в масле; НВ — твердость по Бринеллю. Число после М, В, Н или ТВЧ — среднее значение твердости по HRC.

*) Римскими цифрами обозначен вид нагрузки: I — статическая; II — переменная, действующая от нуля до максимума и от максимума до нуля (пульсирующая), III — знакопеременная (симметричная).
Марка стали ГОСТ 1050 | Термо- обработка | Предел прочности при растяжении σв | Предел текучести σт | Предел выносливости при | | | Допускаемые напряжения *, МПа, при
| | | | растяжении σ[−1р] | изгибе σ−1 | кручении τ−1 | растяжении [σ р] | | | изгибе [σиз] | | | кручении [τкр] | | | срезе [τср] | | | смятии [σсм]
| | кгс/мм² | | | | | I | II | III | I | II | III | I | II | III | I | II | III | I | II
8 | Н | 33 | 20 | 12 | 15 | 9 | 110 | 80 | 60 | 130 | 95 | 75 | 80 | 60 | 45 | 60 | 45 | 35 | 165 | 120
10 | Н | 34 | 21 | 12,5 | 15,5 | 9,5 | 110 | 80 | 60 | 145 | 100 | 75 | 80 | 60 | 45 | 65 | 45 | 35 | 165 | 120
| Ц-В59 | 40 | 25 | 14,5 | 18 | 11 | 130 | 90 | 70 | 155 | 115 | 90 | 100 | 65 | 55 | 70 | 50 | 40 | 195 | 135
15 | Н | 38 | 23 | 13,5 | 17 | 10 | 125 | 85 | 65 | 150 | 110 | 85 | 95 | 65 | 50 | 75 | 50 | 40 | 185 | 125
| Ц-В59 | 45 | 25 | 16 | 20 | 12 | 145 | 50 | 80 | 175 | 125 | 100 | 110 | 80 | 60 | 85 | 60 | 45 | 210 | 75
20 | Н | 42 | 25 | 15 | 19 | 11,5 | 140 | 115 | 95 | 170 | 120 | 95 | 105 | 70 | 55 | 85 | 60 | 45 | 210 | 175
| Ц-В59 | 50 | 30 | 18 | 22,5 | 13,5 | 165 | 115 | 90 | 200 | 140 | 110 | 125 | 75 | 55 | 100 | 60 | 45 | 240 | 175
25 | Н | 46 | 28 | 17 | 21 | 12,5 | 150 | 110 | 85 | 180 | 130 | 105 | 110 | 80 | 60 | 90 | 65 | 50 | 220 | 165
| Ц-В58 | 55 | 35 | 20 | 25 | 15 | 180 | 130 | 100 | 210 | 160 | 125 | 135 | 95 | 75 | 110 | 80 | 60 | 270 | 195
30 | Н | 50 | 30 | 18 | 22,5 | 13,5 | 165 | 115 | 90 | 200 | 140 | 110 | 125 | 90 | 70 | 100 | 65 | 55 | 240 | 175
| У | 60 | 35 | 21,5 | 27 | 16 | 200 | 140 | 105 | 240 | 175 | 135 | 150 | 105 | 80 | 120 | 85 | 65 | 300 | 210

35 | Н | 54 | 32 | 19 | 24 | 14,5 | 180 | 125 | 95 | 210 | 155 | 120 | 135 | 90 | 70 | 110 | 75 | 55 | 270 | 190
| У | 65 | 38 | 23 | 29 | 17,5 | 210 | 150 | 115 | 260 | 185 | 145 | 160 | 110 | 85 | 130 | 90 | 70 | 520 | 220
| В35 | 100 | 65 | 36 | 45 | 27 | 330 | 230 | 180 | 400 | 290 | 220 | 250 | 165 | 135 | 200 | 140 | 110 | 500 | 350
40 | Н | 58 | 34 | 21 | 26 | 15,5 | 190 | 130 | 105 | 230 | 165 | 130 | 140 | 100 | 75 | 115 | 80 | 60 | 280 | 200
| У | 70 | 40 | 25 | 31,5 | 19 | 230 | 160 | 125 | 270 | 200 | 155 | 170 | 120 | 95 | 140 | 100 | 80 | 340 | 240
| В35 | 100 | 65 | 36 | 45 | 27 | 340 | 230 | 180 | 400 | 290 | 2200 | 250 | 175 | 135 | 200 | 140 | 110 | 500 | 350
45 | Н | 61 | 36 | 22 | 27,5 | 16,5 | 200 | 140 | 110 | 240 | 175 | 135 | 150 | 105 | 80 | 125 | 85 | 65 | 300 | 210
| У | 75 | 45 | 27 | 34 | 20,5 | 240 | 170 | 135 | 290 | 215 | 170 | 185 | 130 | 100 | 145 | 105 | 80 | 360 | 260
| М35 | 90 | 65 | 32,5 | 40,5 | 24,5 | 300 | 210 | 160 | 360 | 260 | 200 | 230 | 165 | 120 | 185 | 125 | 95 | 450 | 310
| В42 | 90-120 | 70 | 32,5 | 40,5 | 24,5 | 300 | 210 | 160 | 360 | 260 | 200 | 230 | 160 | 120 | 185 | 125 | 95 | 450 | 310
| В48 | 120 | 95 | 43 | 54 | 32,5 | 400 | 280 | 210 | 480 | 340 | 270 | 300 | 210 | 160 | 240 | 170 | 130 | 600 | 420
| ТВЧ56 | 75 | 45 | 27 | 34 | 20,5 | 240 | 170 | 135 | 290 | 210 | 170 | 185 | 130 | 100 | 145 | 105 | 80 | 360 | 260
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
ШХ15 | 801 | О | 60 | 38 | 24 | 30 | 18 | 200 | 150 | 120 | 2400 | 180 | 150 | 150 | 110 | 90 | 120 | 90 | 75 | 300 | 220
| | М62 | 220 | 170 | 46 | 66 | 33 | 740 | 350 | 230 | 8900 | 480 | 330 | 550 | 250 | 165 | 440 | 200 | 130 | 1100 | 520
