S1NZH/Course-project-9.101/Лаб.работа/! Литература/SAE J617-1992/3.jpg

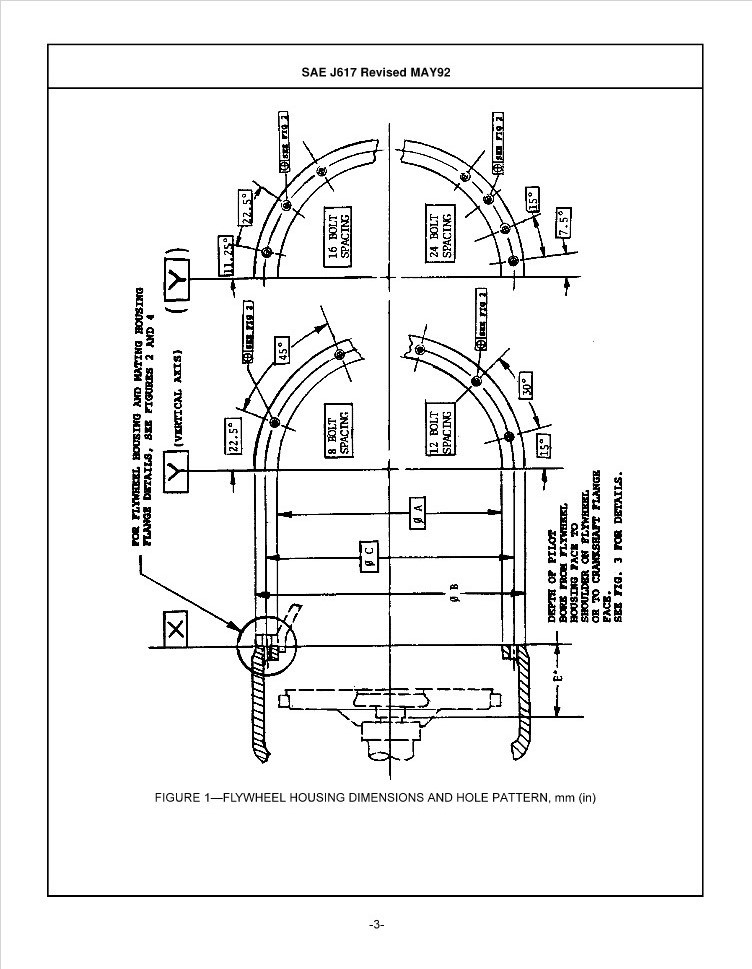
Лаб.работа/! Литература/SAE J617-1992/3.jpg
