S1NZH/Course-project-9.101/МКЭ/В отчет/Снимок экрана 2026-06-15 220657.png

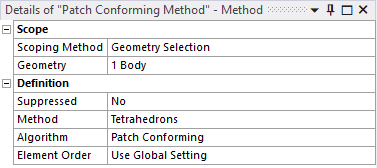
МКЭ/В отчет/Снимок экрана 2026-06-15 220657.png
