S1NZH/Course-project-9.101/(list of files, cad)

Other CAD files:
Лаб.работа/Несоосные/4R81-6-2-B(8+2).dwg
Лаб.работа/Несоосные/параллельные/4R107-1-2-A(10+1).dwg
Лаб.работа/Соосные/4R93-10-2-A(10+2).dwg
Лаб.работа/Несоосные/4R82-1-1-A-2(8+3).dwg
Лаб.работа/Несоосные/параллельные/4R104-1-2-A(10+1)-1.dwg
Лаб.работа/Соосные/4R93-14-3-A(10+1).dwg
Лаб.работа/Несоосные/4R95-2-2-A(9+1).dwg
Лаб.работа/Несоосные/параллельные/4R101-1-1-A(9+3).dwg
Лаб.работа/Соосные/4R81-4-15-A(8+3).dwg
Лаб.работа/Несоосные/4R99-3-3-A(8+1).dwg
Лаб.работа/Несоосные/параллельные/4R105-1-2-A(10+1).dwg
Лаб.работа/Соосные/4R82-1-13-B(8+3).dwg
Лаб.работа/Несоосные/4R94-1-2-A(9+1).dwg
Лаб.работа/Несоосные/параллельные/4R107-1-3-A(10+1).dwg
Лаб.работа/Соосные/4R81-6-5-A(8+2).dwg
Лаб.работа/Несоосные/4R83-3-1-A(8+2).dwg
Лаб.работа/Несоосные/параллельные/4R104-1-1-A(10+1).dwg
Лаб.работа/Соосные/4R81-2-1-A(8+1).dwg
Лаб.работа/Несоосные/4R81-4-6-B(8+3).dwg
Лаб.работа/Несоосные/параллельные/4R94-1-1-A(9+1).dwg
Лаб.работа/Соосные/4R81-4-33-A(8+3).dwg
Лаб.работа/Несоосные/4R82-1-12-A(8+3).dwg
Лаб.работа/Несоосные/параллельные/4R97-1-1-A(9+2).dwg
Лаб.работа/Соосные/4R93-14-1-A(10+1).dwg
Лаб.работа/Несоосные/4R81-4-7-A(8+3).dwg
Лаб.работа/Несоосные/параллельные/4R103-1-1-A(10+1).dwg
Лаб.работа/Соосные/4R93-14-7-A(9+1).dwg
Лаб.работа/Несоосные/4R93-10-1-A(10+2).dwg
Лаб.работа/Несоосные/параллельные/4R95-1-1-A(9+1).dwg
Лаб.работа/Соосные/4R93-14-4-A(10+1).dwg
Лаб.работа/Несоосные/4R86-29-4-A(8+3).dwg
Лаб.работа/Несоосные/параллельные/4R97-1-2-A(9+2).dwg
Лаб.работа/Соосные/4R82-1-15-A(8+3).dwg
Лаб.работа/Несоосные/4R107-1-2-A(10+1).dwg
Лаб.работа/Несоосные/параллельные/4R105-1-1-A(10+1).dwg
Лаб.работа/Соосные/4R93-4-1-A(9+1).dwg
Лаб.работа/Несоосные/4R86-19-A(8+3).dwg
Лаб.работа/Несоосные/параллельные/4R107-1-1-A(10+1).dwg
Лаб.работа/Соосные/4R82-1-9-A(8+3).dwg
Лаб.работа/Несоосные/4R81-4-30-A(8+3).dwg
Лаб.работа/Несоосные/параллельные/4R105-1-3-A(10+1).dwg
Лаб.работа/Соосные/4R82-1-8-B(8+3).dwg
Лаб.работа/Несоосные/4R81-4-10-A(8+3).dwg
Лаб.работа/Несоосные/параллельные/4R96-1-1-A(9+1).dwg
Лаб.работа/Соосные/4R82-1-14-A(8+3).dwg
Лаб.работа/Несоосные/4R83-1-5-A(8+3).dwg
Лаб.работа/Несоосные/параллельные/4R104-1-2-A(10+1).dwg
Лаб.работа/Соосные/4R81-4-6-A(8+3).dwg
Лаб.работа/Несоосные/4R82-1-16-B(8+3).dwg
Лаб.работа/Несоосные/параллельные/4R104-1-3-A(10+1).dwg
Лаб.работа/Соосные/4R93-14-11-A(9+1).dwg
Лаб.работа/Несоосные/4R104-1-2-A(9+2).dwg
Лаб.работа/Несоосные/параллельные/4R106-1-1-A(10+1).dwg
Лаб.работа/Соосные/4R82-1-3-B(8+3).dwg
Лаб.работа/Несоосные/4R95-2-1-A(9+1).dwg
Лаб.работа/Соосные/4R93-4-1-B(9+1).dwg
Лаб.работа/Несоосные/4R93-22-3-C(9+1).dwg
Лаб.работа/Соосные/4R82-1-8-A(8+3).dwg
Лаб.работа/Несоосные/4R93-19-1-B(9+1).dwg
Лаб.работа/Соосные/4R81-4-17-A(8+3).dwg
Лаб.работа/Несоосные/4R93-14-6-A(10+1).dwg
Лаб.работа/Соосные/4R93-14-8-A(9+1).dwg
Лаб.работа/Несоосные/4R81-3-1-A(8+1).dwg
Лаб.работа/Соосные/4R86-1-2-A(8+3).dwg
Лаб.работа/Несоосные/4R81-3-2-A(8+1).dwg
Лаб.работа/Соосные/4R81-2-3-A(8+1).dwg
Лаб.работа/Несоосные/4R95-2-3-B(9+1).dwg
Лаб.работа/Соосные/4R93-19-3-A(9+1).dwg
Лаб.работа/Несоосные/4R81-4-16-A(8+3).dwg
Лаб.работа/Соосные/4R81-4-20-A(8+3).dwg
Лаб.работа/Несоосные/4R82-1-2-A(8+3).dwg
Лаб.работа/Соосные/4R93-19-2-A(9+1).dwg
Лаб.работа/Несоосные/4R82-1-18-A(8+3).dwg
Лаб.работа/Соосные/4R83-1-9-A(8+3).dwg
Лаб.работа/Несоосные/4R81-4-3-A(8+3).dwg
Лаб.работа/Соосные/4R82-1-9-B(8+3).dwg
Лаб.работа/Несоосные/4R83-1-6-A(8+3).dwg
Лаб.работа/Соосные/4R82-1-3-C(8+3).dwg
Лаб.работа/Несоосные/4R99-3-1-B(8+1).dwg
Лаб.работа/Соосные/4R93-5-3-A(9+1).dwg
Лаб.работа/Несоосные/4R81-4-9-A(8+3).dwg
Лаб.работа/Соосные/4R93-24-1-A(9+1).dwg
Лаб.работа/Несоосные/4R81-4-7-B(8+3).dwg
Лаб.работа/Соосные/4R81-4-32-A(8+3).dwg
Лаб.работа/Несоосные/4R94-2-1-B(9+1).dwg
Лаб.работа/Соосные/4R93-4-3-A(9+1).dwg
Лаб.работа/Несоосные/4R93-22-2-C(9+1).dwg
Лаб.работа/Соосные/4R82-1-15-B(8+3).dwg
Лаб.работа/Несоосные/4R81-4-29-A(8+3).dwg
Лаб.работа/Соосные/4R82-1-20-B(8+3).dwg
Лаб.работа/Несоосные/4R93-14-6-A(9+1).dwg
Лаб.работа/Соосные/4R81-4-21-A(8+3).dwg
Лаб.работа/Несоосные/4R83-1-3-A(8+3).dwg
Лаб.работа/Соосные/4R93-16-1-A-1 (9+1).dwg
Лаб.работа/Несоосные/4R93-19-3-B(9+1).dwg
Лаб.работа/Соосные/4R81-4-5-B(8+3).dwg
Лаб.работа/Несоосные/4R81-3-3-A(8+1).dwg
Лаб.работа/Соосные/4R81-4-11-A(8+3).dwg
Лаб.работа/Несоосные/4R81-6-3-A(8+2).dwg
Лаб.работа/Соосные/4R81-4-31-A(8+3).dwg
Лаб.работа/Несоосные/4R104-1-1-A(9+2).dwg
Лаб.работа/Соосные/4R93-14-12-A(9+1).dwg
Лаб.работа/Несоосные/4R94-2-3-A(9+1).dwg
Лаб.работа/Соосные/4R93-22-3-B(9+1).dwg
Лаб.работа/Несоосные/4R99-3-5-A(8+0).dwg
Лаб.работа/Соосные/4R86-1-6-A(8+3).dwg
Лаб.работа/Несоосные/4R81-2-2-A(8+1).dwg
Лаб.работа/Соосные/4R93-10-3-A(10+2).dwg
Лаб.работа/Несоосные/4R82-1-2-B(8+3).dwg
Лаб.работа/Соосные/4R93-14-13-A(10+1).dwg
Лаб.работа/Несоосные/4R82-3-1-A-2(8+1).dwg
Лаб.работа/Соосные/4R81-4-26-A(8+3).dwg
Лаб.работа/Несоосные/4R93-22-1-B(9+1).dwg
Лаб.работа/Соосные/4R82-1-4-A(8+3).dwg
Лаб.работа/Несоосные/4R81-4-13-A(8+3).dwg
Лаб.работа/Соосные/4R93-14-2-A(10+1).dwg
Лаб.работа/Несоосные/4R82-1-11-A(8+3).dwg
Лаб.работа/Соосные/4R82-1-20-A(8+3).dwg
Лаб.работа/Несоосные/4R93-22-1-C(9+1).dwg
Лаб.работа/Соосные/4R93-24-2-A(9+1).dwg
Лаб.работа/Несоосные/4R101-1-1-A(9+3).dwg
Лаб.работа/Соосные/4R82-1-13-A(8+3).dwg
Лаб.работа/Несоосные/4R82-1-10-A(8+3).dwg
Лаб.работа/Соосные/4R81-4-6-B(8+3).dwg
Лаб.работа/Несоосные/4R99-3-1-A(8+1).dwg
Лаб.работа/Соосные/4R82-1-21-A(8+3).dwg
Лаб.работа/Несоосные/4R81-4-22-A(8+3).dwg
Лаб.работа/Соосные/4R93-22-2-B(9+1).dwg
Лаб.работа/Несоосные/4R86-29-2-A(8+3).dwg
Лаб.работа/Соосные/4R93-16-3-A-1 (9+1).dwg
Лаб.работа/Несоосные/4R81-4-28-A(8+3).dwg
Лаб.работа/Соосные/4R86-1-3-A(8+3).dwg
Лаб.работа/Несоосные/4R85-5-1-A(9+2).dwg
Лаб.работа/Соосные/4R93-14-3-B(10+1).dwg
Лаб.работа/Несоосные/4R81-4-24-A(8+3).dwg
Лаб.работа/Соосные/4R81-4-19-A(8+3).dwg
Лаб.работа/Несоосные/4R81-2-5-A(8+1).dwg
Лаб.работа/Соосные/4R81-2-1-A-1(8+1).dwg
Лаб.работа/Несоосные/4R93-14-10-A(10+1).dwg
Лаб.работа/Соосные/4R81-2-1-A-3(8+1).dwg
Лаб.работа/Несоосные/4R82-1-3-A(8+3).dwg
Лаб.работа/Соосные/4R93-14-14-A(10+1).dwg
Лаб.работа/Несоосные/4R99-3-2-A(8+1).dwg
Лаб.работа/Соосные/4R86-1-5-A(8+3).dwg
Лаб.работа/Несоосные/4R82-1-16-A(8+3).dwg
Лаб.работа/Соосные/4R81-2-6-A(8+1).dwg
Лаб.работа/Несоосные/4R82-3-1-B-1(8+1).dwg
Лаб.работа/Соосные/4R81-4-12-A(8+3).dwg
Лаб.работа/Несоосные/4R99-3-2-B(8+1).dwg
Лаб.работа/Соосные/4R81-2-1-A-2(8+1).dwg
Лаб.работа/Несоосные/4R107-1-1-A(10+1).dwg
Лаб.работа/Несоосные/4R81-2-4-A(8+1).dwg
Лаб.работа/Несоосные/4R81-4-1-A(8+3).dwg
Лаб.работа/Несоосные/4R81-4-12-A(8+3).dwg
Лаб.работа/Несоосные/4R81-4-14-A(8+3).dwg
Лаб.работа/Несоосные/4R81-4-18-A(8+3).dwg
Лаб.работа/Несоосные/4R81-4-2-A(8+3).dwg
Лаб.работа/Несоосные/4R81-4-23-A(8+3).dwg
Лаб.работа/Несоосные/4R81-4-25-A(8+3).dwg
Лаб.работа/Несоосные/4R81-4-4-A(8+3).dwg
Лаб.работа/Несоосные/4R81-4-5-A(8+3).dwg
Лаб.работа/Несоосные/4R81-4-8-A(8+3).dwg
Лаб.работа/Несоосные/4R81-4-8-B(8+3).dwg
Лаб.работа/Несоосные/4R81-6-1-A(8+2).dwg
Лаб.работа/Несоосные/4R81-6-2-A(8+2).dwg
Лаб.работа/Несоосные/4R81-6-4-A(8+2).dwg
Лаб.работа/Несоосные/4R81-6-6-A(8+2).dwg
Лаб.работа/Несоосные/4R82-1-1-A(8+3).dwg
Лаб.работа/Несоосные/4R82-1-1-A-1(8+3).dwg
Лаб.работа/Несоосные/4R82-1-17-A(8+3).dwg
Лаб.работа/Несоосные/4R82-1-19-A(8+3).dwg
Лаб.работа/Несоосные/4R82-1-4-A(8+3).dwg
Лаб.работа/Несоосные/4R82-1-5-A(8+3).dwg
Лаб.работа/Несоосные/4R82-1-6-A(8+3).dwg
Лаб.работа/Несоосные/4R82-1-7-A(8+3).dwg
Лаб.работа/Несоосные/4R82-3-1-A-1(8+1).dwg
Лаб.работа/Несоосные/4R82-3-1-B-2(8+1).dwg
Лаб.работа/Несоосные/4R83-1-1-A(8+3).dwg
Лаб.работа/Несоосные/4R83-1-2-A(8+3).dwg
Лаб.работа/Несоосные/4R83-1-4-A(8+3).dwg
Лаб.работа/Несоосные/4R85-5-1-B(9+2).dwg
Лаб.работа/Несоосные/4R85-5-2-A(9+2).dwg
Лаб.работа/Несоосные/4R93-10-3-A(10+2).dwg
Лаб.работа/Несоосные/4R93-14-10-A(9+1).dwg
Лаб.работа/Несоосные/4R93-14-4-A(10+1).dwg
Лаб.работа/Несоосные/4R93-14-5-A(10+1).dwg
Лаб.работа/Несоосные/4R93-14-5-A(9+1).dwg
Лаб.работа/Несоосные/4R94-1-1-A(9+1).dwg
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
