S1NZH/Course-project-9.101/Лаб.работа/ZUB (Подбор чисел зубьев шестерен ПР с одновенцовыми сателлитами)/resultat/4ПР.docx

k= 1.889 A(CT)= 3 Z(МЦК)= 27 Z(CT)= 12 Z(БЦК)= 51

k= 1.897 A(CT)= 3 Z(МЦК)= 29 Z(CT)= 13 Z(БЦК)= 55

k= 1.903 A(CT)= 3 Z(МЦК)= 31 Z(CT)= 14 Z(БЦК)= 59

k= 1.909 A(CT)= 3 Z(МЦК)= 33 Z(CT)= 15 Z(БЦК)= 63

k= 1.893 A(CT)= 3 Z(МЦК)= 56 Z(CT)= 25 Z(БЦК)= 106

k= 1.897 A(CT)= 3 Z(МЦК)= 58 Z(CT)= 26 Z(БЦК)= 110

k= 1.900 A(CT)= 3 Z(МЦК)= 60 Z(CT)= 27 Z(БЦК)= 114

k= 1.903 A(CT)= 3 Z(МЦК)= 62 Z(CT)= 28 Z(БЦК)= 118

k= 1.906 A(CT)= 3 Z(МЦК)= 64 Z(CT)= 29 Z(БЦК)= 122

k= 1.897 A(CT)= 3 Z(МЦК)= 87 Z(CT)= 39 Z(БЦК)= 165

k= 1.899 A(CT)= 3 Z(МЦК)= 89 Z(CT)= 40 Z(БЦК)= 169

k= 1.901 A(CT)= 3 Z(МЦК)= 91 Z(CT)= 41 Z(БЦК)= 173

k= 1.903 A(CT)= 3 Z(МЦК)= 93 Z(CT)= 42 Z(БЦК)= 177

k= 1.897 A(CT)= 3 Z(МЦК)= 116 Z(CT)= 52 Z(БЦК)= 220

k= 1.898 A(CT)= 3 Z(МЦК)= 118 Z(CT)= 53 Z(БЦК)= 224

k= 1.900 A(CT)= 3 Z(МЦК)= 120 Z(CT)= 54 Z(БЦК)= 228

k= 1.902 A(CT)= 3 Z(МЦК)= 122 Z(CT)= 55 Z(БЦК)= 232

k= 1.903 A(CT)= 3 Z(МЦК)= 124 Z(CT)= 56 Z(БЦК)= 236

k= 1.898 A(CT)= 3 Z(МЦК)= 147 Z(CT)= 66 Z(БЦК)= 279

k= 1.899 A(CT)= 3 Z(МЦК)= 149 Z(CT)= 67 Z(БЦК)= 283

k= 1.901 A(CT)= 3 Z(МЦК)= 151 Z(CT)= 68 Z(БЦК)= 287

k= 1.902 A(CT)= 3 Z(МЦК)= 153 Z(CT)= 69 Z(БЦК)= 291

k= 1.898 A(CT)= 3 Z(МЦК)= 176 Z(CT)= 79 Z(БЦК)= 334

k= 1.899 A(CT)= 3 Z(МЦК)= 178 Z(CT)= 80 Z(БЦК)= 338

k= 1.900 A(CT)= 3 Z(МЦК)= 180 Z(CT)= 81 Z(БЦК)= 342

k= 1.901 A(CT)= 3 Z(МЦК)= 182 Z(CT)= 82 Z(БЦК)= 346

k= 1.902 A(CT)= 3 Z(МЦК)= 184 Z(CT)= 83 Z(БЦК)= 350

k= 1.899 A(CT)= 3 Z(МЦК)= 207 Z(CT)= 93 Z(БЦК)= 393

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

k= 1.902 A(CT)= 6 Z(МЦК)= 244 Z(CT)= 110 Z(БЦК)= 464

k= 1.899 A(CT)= 6 Z(МЦК)= 267 Z(CT)= 120 Z(БЦК)= 507

k= 1.900 A(CT)= 6 Z(МЦК)= 269 Z(CT)= 121 Z(БЦК)= 511

k= 1.900 A(CT)= 6 Z(МЦК)= 271 Z(CT)= 122 Z(БЦК)= 515

k= 1.901 A(CT)= 6 Z(МЦК)= 273 Z(CT)= 123 Z(БЦК)= 519
