S1NZH/Course-project-9.101/Лаб.работа/ZUB2 (Подбор чисел зубьев шестерен ПР с двухвенцовыми сателлитами)/resultat/!3_76.docx

Расчет числа зубьев зубчатых колес планетарного ряда

2-го класса с двухвенцовыми сателлитами

Минимальное число зубьев зубчатых колёс: 17

Максимальное число зубьев МЦК и сателлита МЦК: 250

Минимальное число сателлитов: 3

Конструктивный параметр: 3.76

k= 3.760 A(CT)= 3 Z(МЦК)= 22 Z(CTМЦК)= 44 Z(CTБЦК)= 75 Z(БЦК)= 141 ЦЕЛОЕ ЧИСЛО= 2618.000

k= 3.760 A(CT)= 3 Z(МЦК)= 25 Z(CTМЦК)= 47 Z(CTБЦК)= 72 Z(БЦК)= 144 ЦЕЛОЕ ЧИСЛО= 2856.000

k= 3.760 A(CT)= 3 Z(МЦК)= 25 Z(CTМЦК)= 60 Z(CTБЦК)= 150 Z(БЦК)= 235 ЦЕЛОЕ ЧИСЛО= 5950.000

k= 3.760 A(CT)= 3 Z(МЦК)= 35 Z(CTМЦК)= 63 Z(CTБЦК)= 90 Z(БЦК)= 188 ЦЕЛОЕ ЧИСЛО= 4998.000

k= 3.760 A(CT)= 3 Z(МЦК)= 39 Z(CTМЦК)= 52 Z(CTБЦК)= 50 Z(БЦК)= 141 ЦЕЛОЕ ЧИСЛО= 3094.000

k= 3.760 A(CT)= 3 Z(МЦК)= 50 Z(CTМЦК)= 52 Z(CTБЦК)= 39 Z(БЦК)= 141 ЦЕЛОЕ ЧИСЛО= 3094.000

k= 3.760 A(CT)= 3 Z(МЦК)= 50 Z(CTМЦК)= 69 Z(CTБЦК)= 69 Z(БЦК)= 188 ЦЕЛОЕ ЧИСЛО= 5474.000

k= 3.760 A(CT)= 3 Z(МЦК)= 55 Z(CTМЦК)= 47 Z(CTБЦК)= 30 Z(БЦК)= 132 ЦЕЛОЕ ЧИСЛО= 2618.000

k= 3.760 A(CT)= 3 Z(МЦК)= 69 Z(CTМЦК)= 69 Z(CTБЦК)= 50 Z(БЦК)= 188 ЦЕЛОЕ ЧИСЛО= 5474.000

k= 3.760 A(CT)= 3 Z(МЦК)= 75 Z(CTМЦК)= 44 Z(CTБЦК)= 22 Z(БЦК)= 141 ЦЕЛОЕ ЧИСЛО= 2618.000

k= 3.760 A(CT)= 3 Z(МЦК)= 90 Z(CTМЦК)= 63 Z(CTБЦК)= 35 Z(БЦК)= 188 ЦЕЛОЕ ЧИСЛО= 4998.000

k= 3.760 A(CT)= 3 Z(МЦК)= 100 Z(CTМЦК)= 47 Z(CTБЦК)= 21 Z(БЦК)= 168 ЦЕЛОЕ ЧИСЛО= 3332.000

k= 3.760 A(CT)= 3 Z(МЦК)= 125 Z(CTМЦК)= 45 Z(CTБЦК)= 18 Z(БЦК)= 188 ЦЕЛОЕ ЧИСЛО= 3570.000

k= 3.760 A(CT)= 3 Z(МЦК)= 150 Z(CTМЦК)= 60 Z(CTБЦК)= 25 Z(БЦК)= 235 ЦЕЛОЕ ЧИСЛО= 5950.000

k= 3.760 A(CT)= 4 Z(МЦК)= 25 Z(CTМЦК)= 47 Z(CTБЦК)= 72 Z(БЦК)= 144 ЦЕЛОЕ ЧИСЛО= 2142.000

k= 3.760 A(CT)= 4 Z(МЦК)= 100 Z(CTМЦК)= 47 Z(CTБЦК)= 21 Z(БЦК)= 168 ЦЕЛОЕ ЧИСЛО= 2499.000

k= 3.760 A(CT)= 5 Z(МЦК)= 25 Z(CTМЦК)= 60 Z(CTБЦК)= 150 Z(БЦК)= 235 ЦЕЛОЕ ЧИСЛО= 3570.000

k= 3.760 A(CT)= 5 Z(МЦК)= 125 Z(CTМЦК)= 45 Z(CTБЦК)= 18 Z(БЦК)= 188 ЦЕЛОЕ ЧИСЛО= 2142.000

k= 3.760 A(CT)= 5 Z(МЦК)= 150 Z(CTМЦК)= 60 Z(CTБЦК)= 25 Z(БЦК)= 235 ЦЕЛОЕ ЧИСЛО= 3570.000

k= 3.760 A(CT)= 6 Z(МЦК)= 22 Z(CTМЦК)= 44 Z(CTБЦК)= 75 Z(БЦК)= 141 ЦЕЛОЕ ЧИСЛО= 1309.000

k= 3.760 A(CT)= 6 Z(МЦК)= 25 Z(CTМЦК)= 47 Z(CTБЦК)= 72 Z(БЦК)= 144 ЦЕЛОЕ ЧИСЛО= 1428.000

k= 3.760 A(CT)= 6 Z(МЦК)= 25 Z(CTМЦК)= 60 Z(CTБЦК)= 150 Z(БЦК)= 235 ЦЕЛОЕ ЧИСЛО= 2975.000

k= 3.760 A(CT)= 6 Z(МЦК)= 35 Z(CTМЦК)= 63 Z(CTБЦК)= 90 Z(БЦК)= 188 ЦЕЛОЕ ЧИСЛО= 2499.000

k= 3.760 A(CT)= 6 Z(МЦК)= 39 Z(CTМЦК)= 52 Z(CTБЦК)= 50 Z(БЦК)= 141 ЦЕЛОЕ ЧИСЛО= 1547.000

k= 3.760 A(CT)= 6 Z(МЦК)= 50 Z(CTМЦК)= 52 Z(CTБЦК)= 39 Z(БЦК)= 141 ЦЕЛОЕ ЧИСЛО= 1547.000

k= 3.760 A(CT)= 6 Z(МЦК)= 50 Z(CTМЦК)= 69 Z(CTБЦК)= 69 Z(БЦК)= 188 ЦЕЛОЕ ЧИСЛО= 2737.000

k= 3.760 A(CT)= 6 Z(МЦК)= 55 Z(CTМЦК)= 47 Z(CTБЦК)= 30 Z(БЦК)= 132 ЦЕЛОЕ ЧИСЛО= 1309.000

k= 3.760 A(CT)= 6 Z(МЦК)= 69 Z(CTМЦК)= 69 Z(CTБЦК)= 50 Z(БЦК)= 188 ЦЕЛОЕ ЧИСЛО= 2737.000

k= 3.760 A(CT)= 6 Z(МЦК)= 75 Z(CTМЦК)= 44 Z(CTБЦК)= 22 Z(БЦК)= 141 ЦЕЛОЕ ЧИСЛО= 1309.000

k= 3.760 A(CT)= 6 Z(МЦК)= 90 Z(CTМЦК)= 63 Z(CTБЦК)= 35 Z(БЦК)= 188 ЦЕЛОЕ ЧИСЛО= 2499.000

k= 3.760 A(CT)= 6 Z(МЦК)= 100 Z(CTМЦК)= 47 Z(CTБЦК)= 21 Z(БЦК)= 168 ЦЕЛОЕ ЧИСЛО= 1666.000

k= 3.760 A(CT)= 6 Z(МЦК)= 125 Z(CTМЦК)= 45 Z(CTБЦК)= 18 Z(БЦК)= 188 ЦЕЛОЕ ЧИСЛО= 1785.000

k= 3.760 A(CT)= 6 Z(МЦК)= 150 Z(CTМЦК)= 60 Z(CTБЦК)= 25 Z(БЦК)= 235 ЦЕЛОЕ ЧИСЛО= 2975.000
