S1NZH/Course-project-9.101/Образцы/Саша.pdf

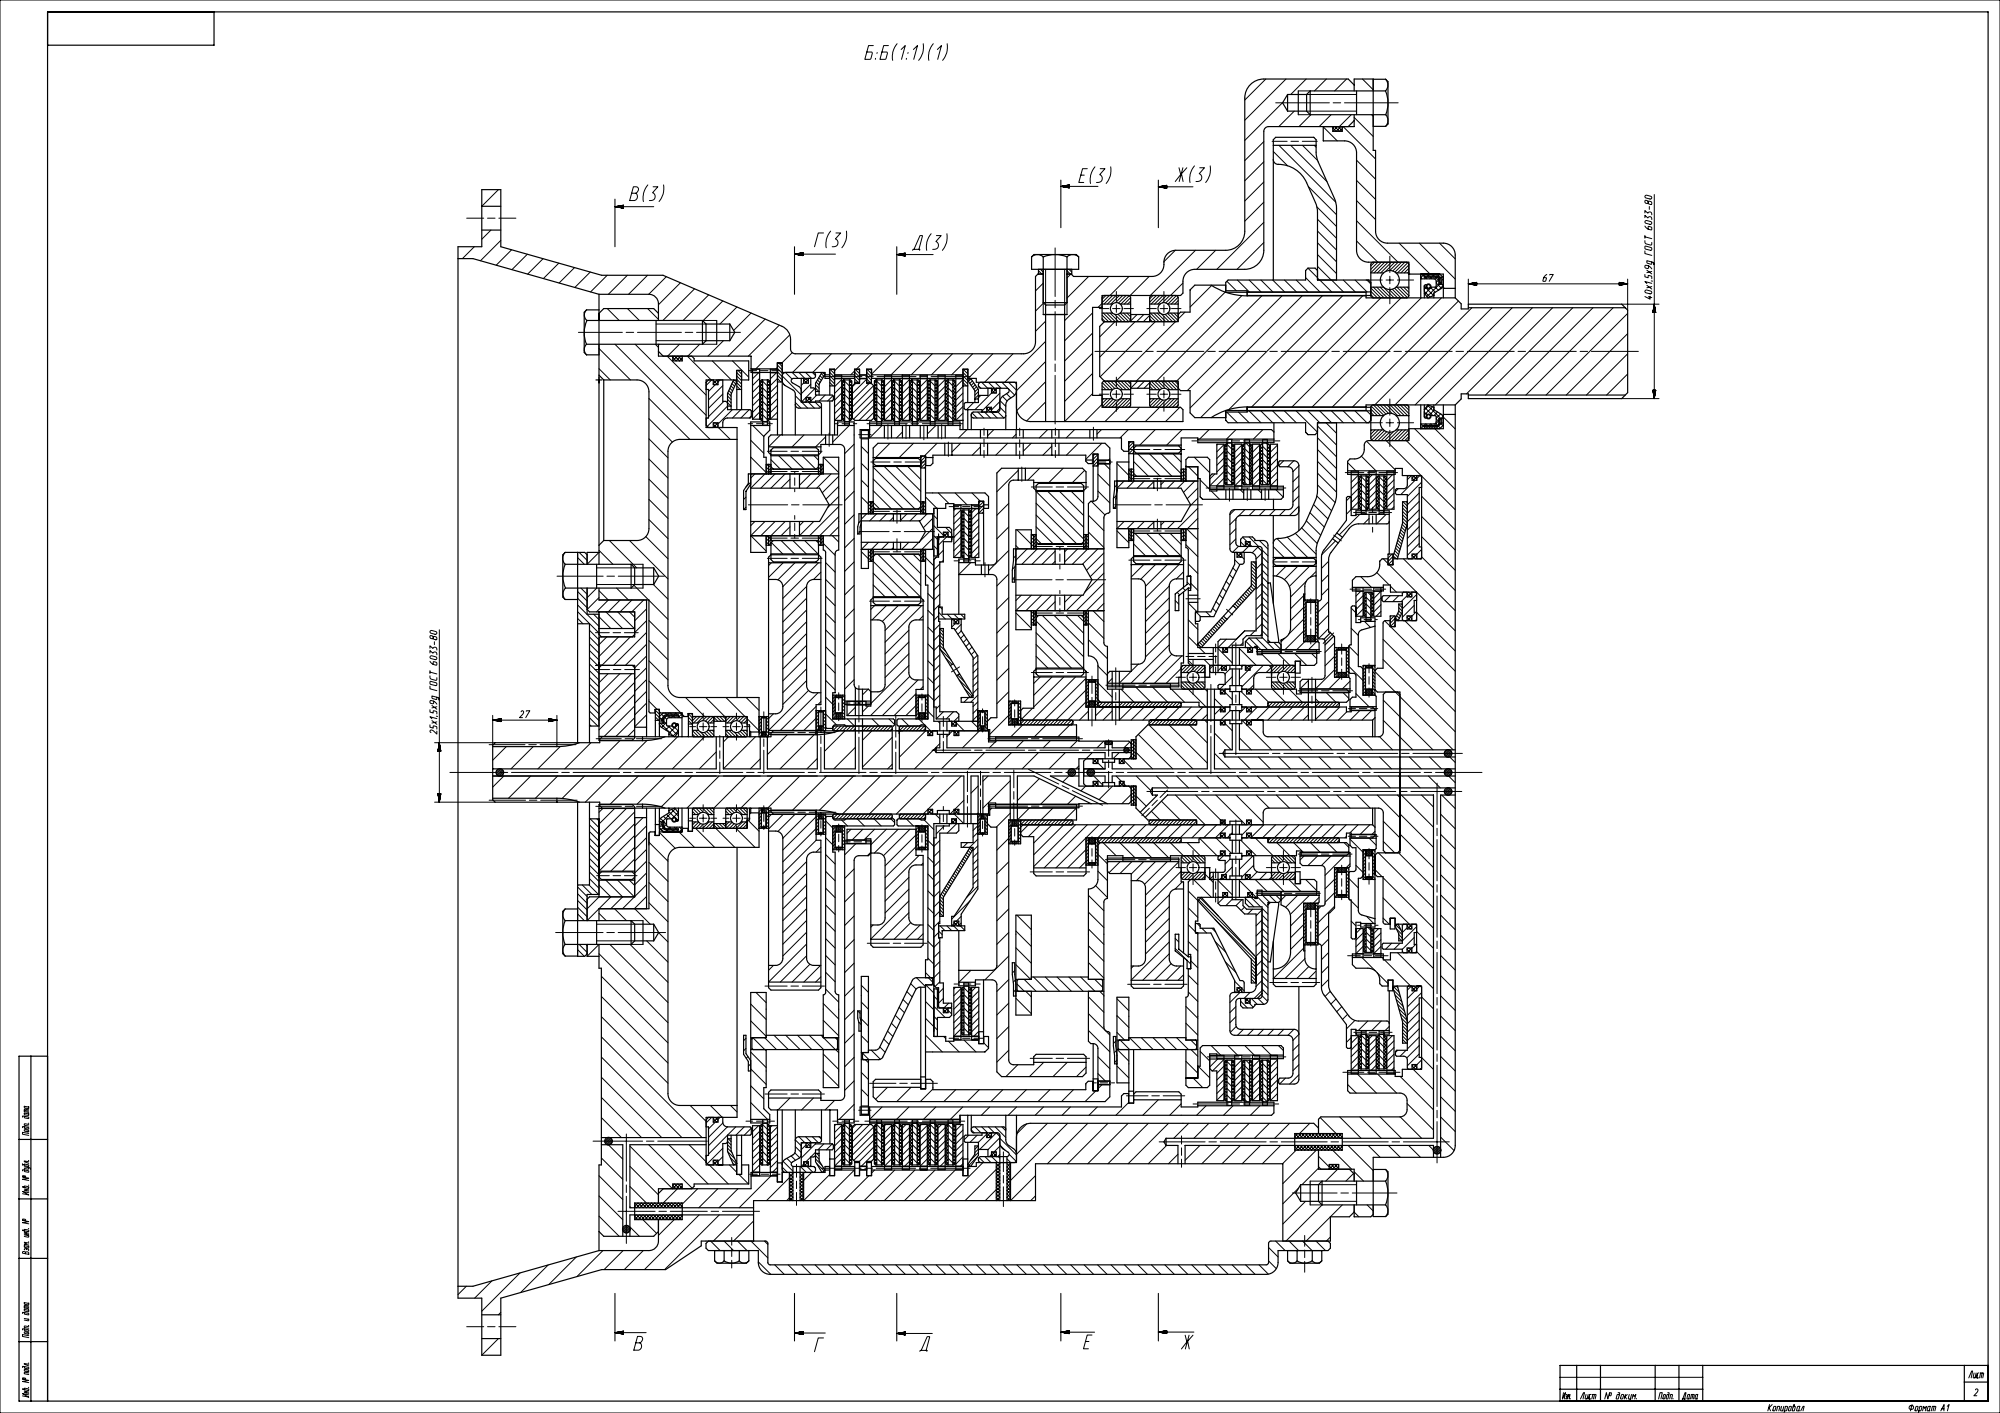
[picture p120: page 1]
