S1NZH/Course-project-9.101/Образцы/Макс.pdf

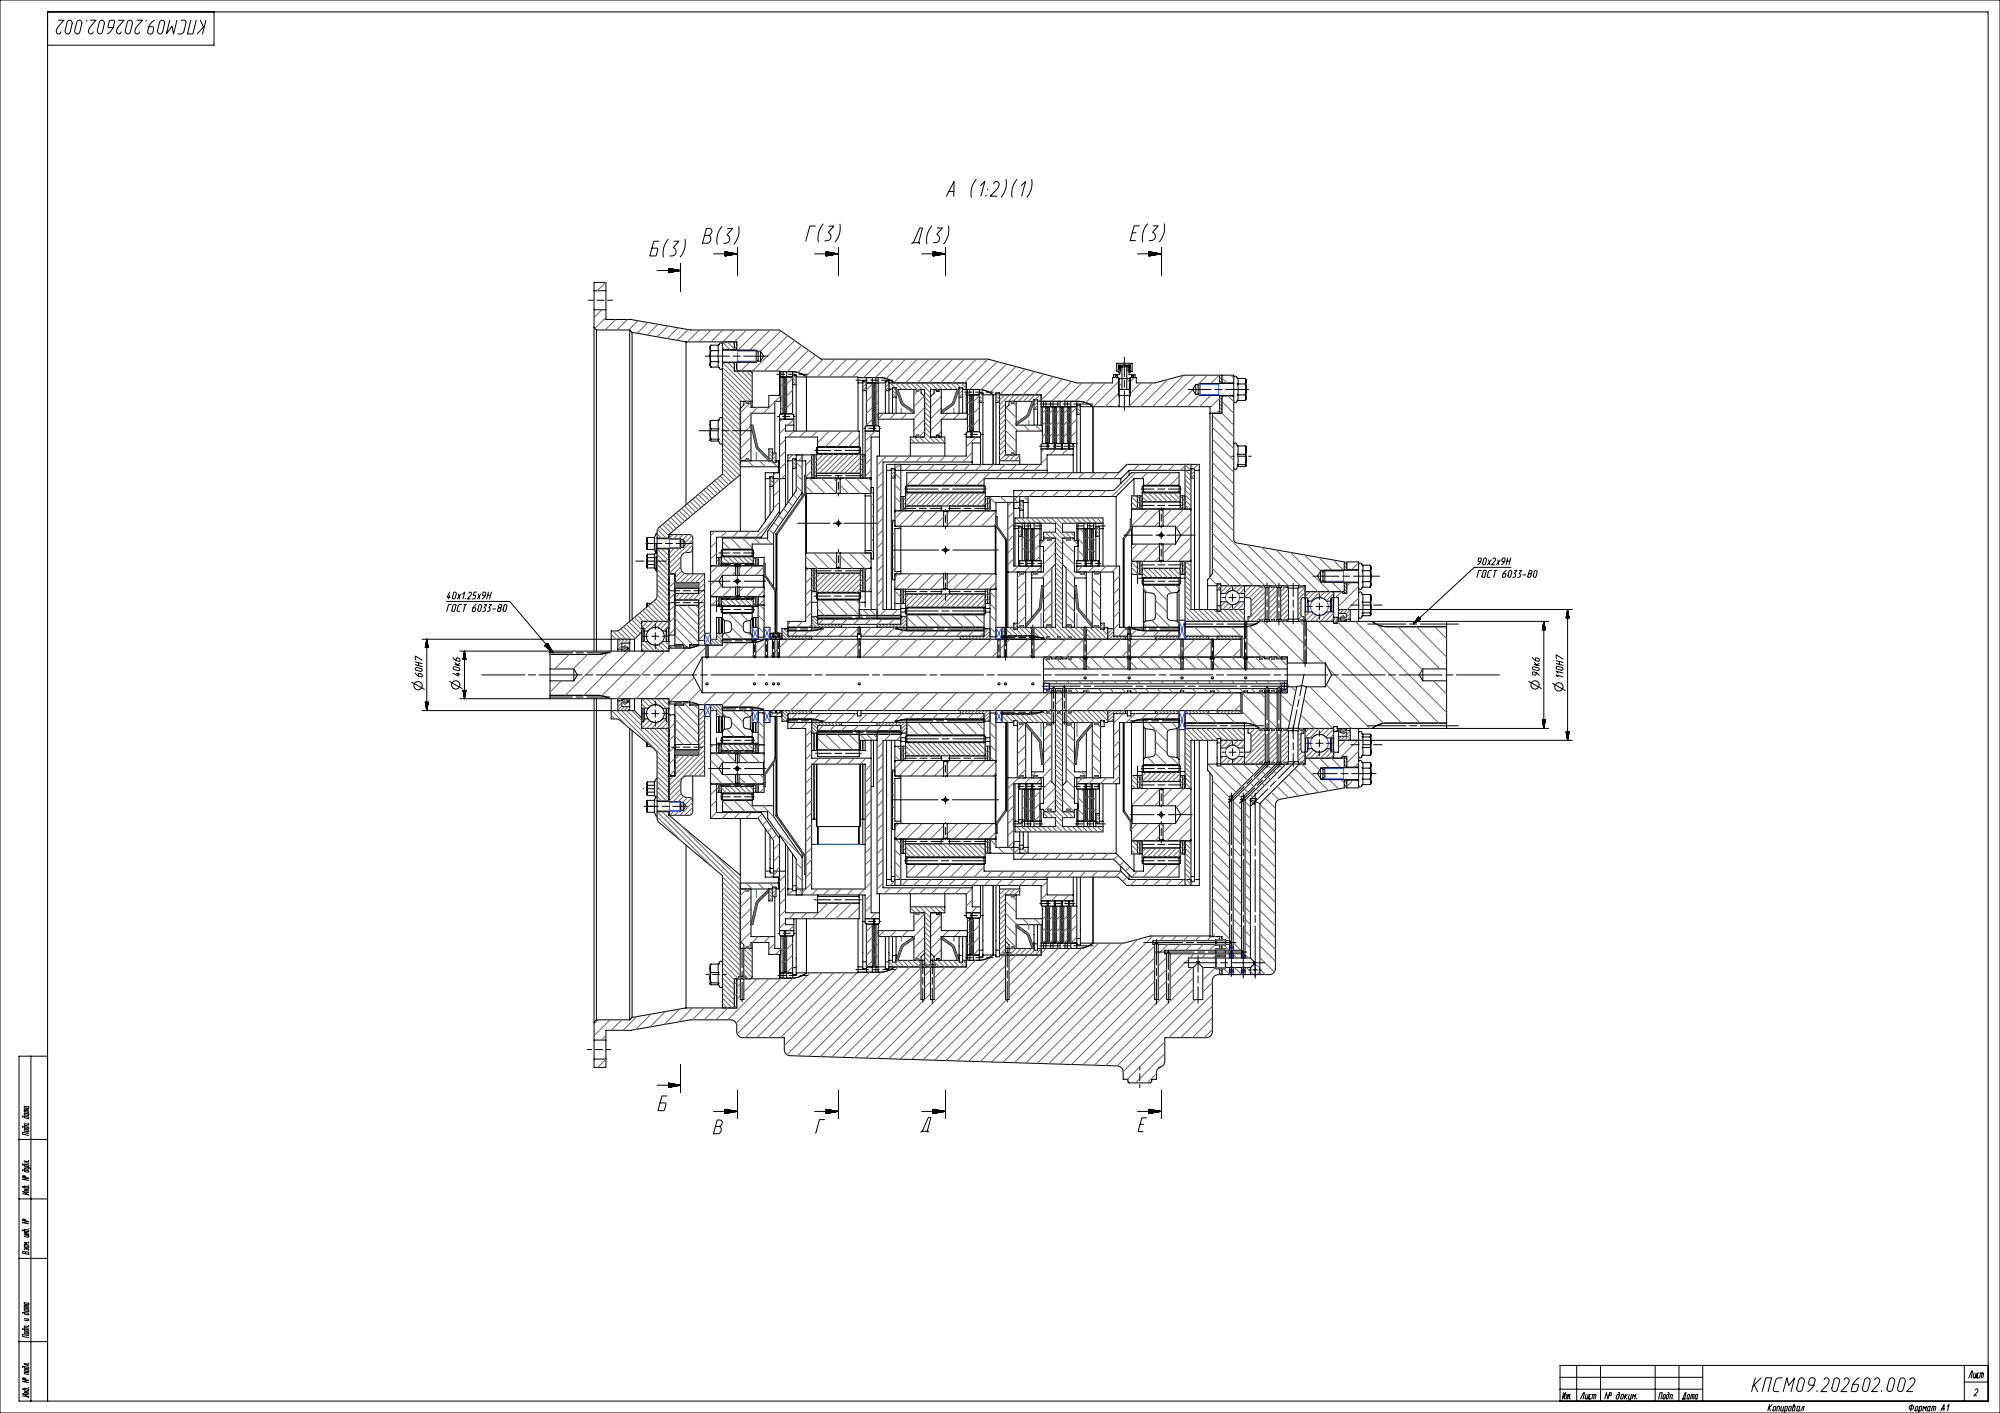
[picture p121: page 1]
