S1NZH/Course-project-9.101/(commit log)

2026-03-25 Добавлены .gitignore и .gitattributes
2026-03-25 Добавлены расчеты с лабы.
    [PR1.xlsx, Вариант 1.xlsx, Расчет фрикционных элементов управления.xlsx, Расчет эвольвентных шлицов.xlsx]
2026-04-13 Начаты модели + новые материалы
    [PR1.xlsx, Вариант 1.xlsx, Расчет фрикционных элементов управления.xlsx, Расчет эвольвентных шлицов.xlsx]
2026-04-19 Обновление материалов
    [4R101-1-1-A(9+3).dwg, 4R103-1-1-A(10+1).dwg, 4R104-1-1-A(10+1).dwg, 4R104-1-1-A(9+2).dwg, 4R104-1-2-A(10+1)-1.dwg, 4R104-1-2-A(10+1).dwg, 4R104-1-2-A(9+2).dwg, 4R104-1-3-A(10+1).dwg]
2026-04-19 Расчет осей + щек сателитов
2026-04-19 Проработка ПР1
2026-04-21 Проработка ПР2-4
2026-04-25 Проработка зубчатых колес ПР
2026-04-26 Обновлен .gitignore
2026-04-26 Установка ПР1 и ПР2 в сборку. Проработка прочих моделей.
2026-04-27 Соеденены планетарные ряды. Проработка ПР3 и ПР4
2026-04-28 Добавлена щека ПР3
2026-04-28 Уточнение конструкций ПР.
2026-04-28 Изменены конструкции щек ПР1 и ПР3
2026-04-29 Переработанны шлицы, начата проработка Мы7
    [Расчет фрикционных элементов управления.xlsx]
2026-05-03 Упрощено отображение зубчатых зацеплений. Проработка конструкции ПКП.
2026-05-04 Добавлен Пакет фрикционов М7
2026-05-04 Проработка сборки ПКП.
    [Расчет фрикционных элементов управления.xlsx]
2026-05-05 Попытка вставить М7 в сборку.
2026-05-06 Переработка геометрии под пересчитанную М7
    [Расчет фрикционных элементов управления.xlsx]
2026-05-12 Реализована примерная установка М7. Изменены крепления БЦК ПР2 и 3.
2026-05-12 Переработана геометрия, Завершена М7
2026-05-18 Поправка геометрии. Дополнение в листы.
2026-05-19 Начата М8
    [Расчет фрикционных элементов управления.xlsx]
2026-05-20 Перенос файлов
2026-05-20 Изменены фаски зубчатых колес.
2026-05-20 Сделаны рабочие чертежи. Дополнен первый лист
2026-05-21 Выполнен расчет по МКЭ
    [Ось С3.x_t]
2026-05-23 Работа над М8. Добавлены внутренний и внешний барабаны
    [Расчет фрикционных элементов управления.xlsx]
2026-06-01 Проработка М8.
2026-06-02 Переработаноы крепления БЦК ПР2-4.
2026-06-02 Откорретированны щеки
2026-06-03 Переделна конструкция ПР3. Заготовка для Т3
    [Расчет фрикционных элементов управления.xlsx]
2026-06-09 Заготовка под Т3
2026-06-09 Переработка конструкции ПКП.
2026-06-12 Проработка Т2, Т3, Т5.
    [Расчет фрикционных элементов управления.xlsx]
2026-06-13 Проработка конструкции.
2026-06-15 Задел под выход ПКП и Т4
2026-06-15 Переделан МКЭ
    [Ось С3.x_t, Ось С4.x_t]
2026-06-15 Новые правки МКЭ
2026-06-17 Обновлены рабочие чертежи
2026-06-17 Добавлен выход из ПКП
    [Расчет фрикционных элементов управления.xlsx]
2026-06-18 Проработка масляных каналов и соответсвующие изменения конструкции.
2026-06-20 Переделана геометрия для внедрения подшипников.
    [Расчет фрикционных элементов управления.xlsx]
2026-06-22 Добавлен подшипник между ПР1 и ПР2. Переработаны некоторые элементы.
2026-06-23 Правки в рабочие чертежи
2026-06-23 Добавлены маслоуловители
2026-06-24 Добавлен насос и пружин в муфты
2026-06-25 Изменена конструкция Т2 и Т3. Добавлен подшипниковый узел на входе
2026-06-25 Проработаны насос и подшипниковый узел. Добавлена крышка картера
2026-06-29 Переделаны элементы управления
    [Var1.xlsx, Расчет фрикционных элементов управления.xlsx]
2026-07-06 Изменения в коснтрукции
2026-08-31 Изменения размеров Т3. Начат картер.
    [Расчет фрикционных элементов управления.xlsx]
2026-08-31 Начат картер.
    [Расчет фрикционных элементов управления.xlsx]
2026-09-02 Добавлены канавки под стопорные кольца внутри картера
2026-09-04 Изменено расположение поршня Т5. Добавлены места под болтовое соединение.
    [Расчет фрикционных элементов управления.xlsx]
2026-09-05 Соединены валы. Добавлены стопоры для элементов управления
2026-09-05 Проработаны некоторые элементы.
2026-09-06 Проработана конструкция
2026-09-07 Проработка выхода из ПКП
2026-09-07 Завершена часть картера. Исправлен выход.
2026-09-08 ПКП заключена в картер. Отредактированы листы.
    [Расчет фрикционных элементов управления.xlsx]
2026-09-09 Добавлены масляные каналы для смазывания + Взрыв схема ПР3
2026-09-09 Добавлены отверстия в блок управления и прилив для масляных каналов.
2026-09-11 Добавлены пружины в тормоза
2026-09-14 Полностью изменен Т4
    [Расчет фрикционных элементов управления.xlsx]
2026-09-14 ЗАКОНЧЕНА МОДЕЛЬ ПКП. Подготовка к правке чертежа.
2026-09-14 Правки рабочих чертежей.
2026-09-14 Доделана модель ПКП. Добавлены крепления под рым-болты, лапы и сливная пробка.
2026-09-14 Подготовка к разрушению вида чертежа.
2026-09-15 Небольшие правки чертежа
2026-09-15 ЗАВЕРШЕН ЧЕРТЕЖ ПКП
    [Расчет фрикционных элементов управления.xlsx]
2026-09-16 ПРОЕКТ ЗАВЕРШЕН!
    [Var1.xlsx, Расчет эвольвентных шлицов.xlsx]
2026-09-16 ПРОЕКТ ЗАВЕРШЕН
    [Var1.xlsx, Расчет эвольвентных шлицов.xlsx]
2026-09-16 Внемены правки в чертеж и РЧ.
2026-09-16 Внесены правки v2
2026-09-17 Внесены правки v2.1
2026-09-20 Внесены правки v2.2
